Fadil-1/8-BIT-BREADBOARD-CPU/README.md

# F8-BB: Expanded 8-bit Breadboard CPU

F8-BB is my expanded 8-bit breadboard CPU. The project is inspired by [Ben Eater's 8-bit CPU series](https://www.youtube.com/playlist?list=PLowKtXNTBypGqImE405J2565dvjafglHU), but it has grown into a larger custom machine with a 16-bit address space and additional I/O hardware.

The goal of this repository is to collect the files needed to document, program, and maintain the build.

Full build

## Blog

More detailed explanations are available on the project blog:

```text
https://fadil-1.github.io/blog/8-bit_breadboard_CPU/overview/
```

## Acknowledgment

A huge thank you to [Ben Eater](https://github.com/beneater) for the original educational CPU series that inspired this project.

I also want to thank [DerULF1 / ULF_Casper](https://github.com/DerULF1) for his 8-bit CPU [series](https://www.youtube.com/playlist?list=PL5-Ar_CvItgaP27eT_C7MnCiubkyaEqF0). The interrupt handling and PS/2 keyboard module in my build are largely derived from his design.

## Hardware highlights

- 8-bit data bus
- 16-bit memory/system bus
- 16-bit Program Counter
- 16-bit Stack Pointer
- Bridge Register for transfers between the 8-bit data bus and 16-bit memory/system bus
- 48 KB of RAM from `0x0000` through `0xBFFF`
- Bootloader ROM window starting at `0xC000`
- Stack initialized at `0xBFFF` and growing downward into RAM
- Programmable clock speed with eight selectable clock rates
- Microcoded control unit built from three M27C4002 EPROMs
- Generated 48-bit control word split across three 16-bit ROM outputs
- General-purpose registers A, B, C, D, and E
- Writable flags and interrupt-related control state
- ALU operations including ADD, SUB, AND, OR, XOR, compare, and shifts
- 16-bit 14-segment display output
- 128x64 OLED display
- SPI/SD-card interface work
- PS/2 keyboard decoder integration planned for the monitor/OS path

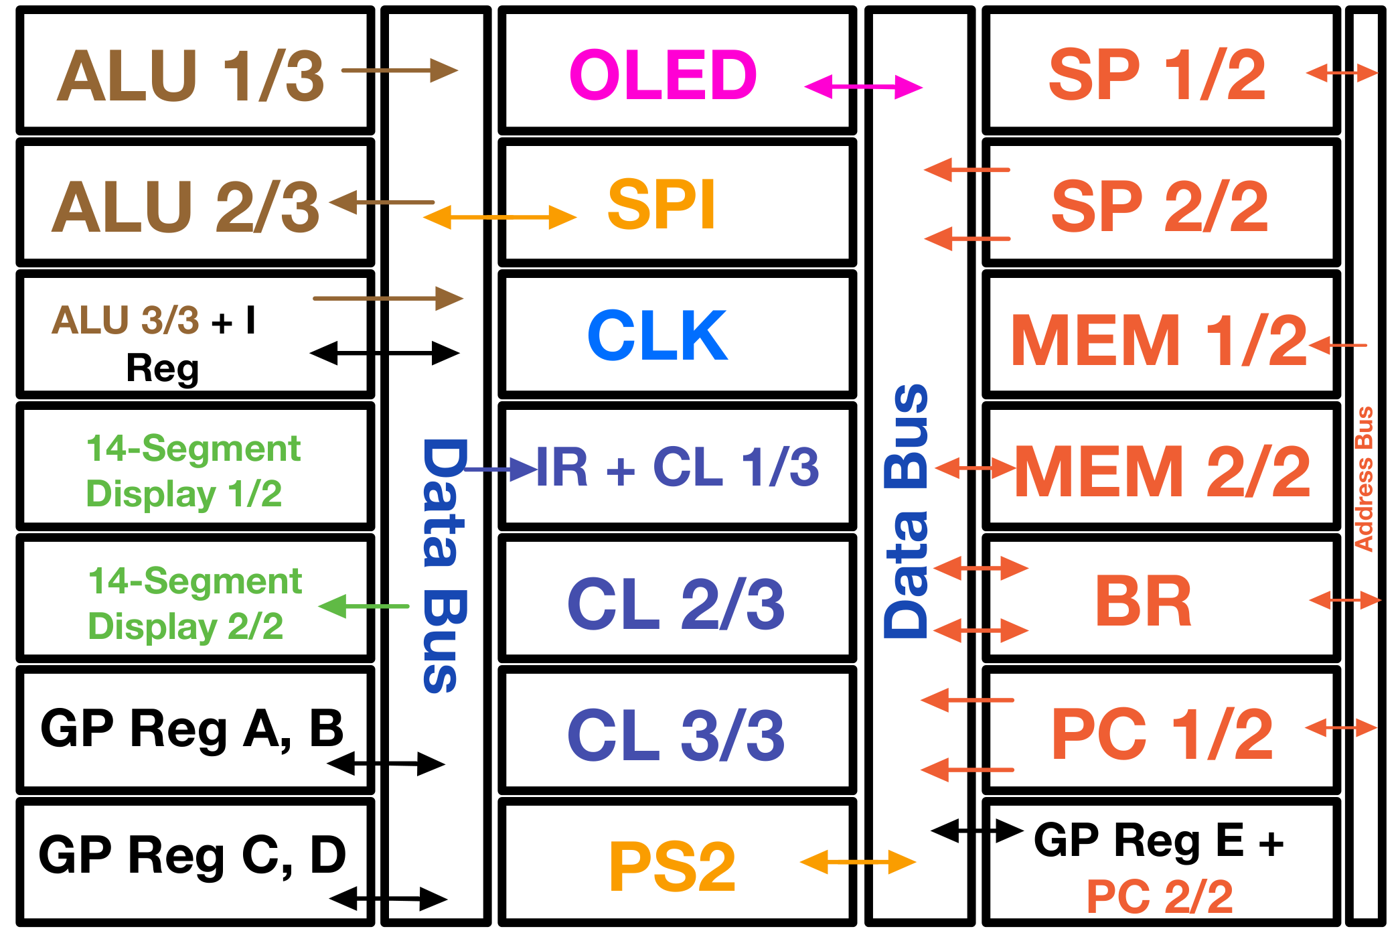
[picture p1: images/Layout.png]
Breadboard layout


## Repository layout

```text
ASM/
    Assembly source files.

ASM/boot/
    ROM bootstrap programs, including SD-card bootloader code.

ASM/drivers/
    Hardware-facing assembly libraries, including OLED and SPI/SD routines.

ASM/libs/
    Shared assembly helpers such as timing routines.

ASM/programs/
    Example programs grouped by how they are loaded.

ASM/programs/loaded_from_ROM/
    Smaller examples that can run from ROM or older direct-programming flows.

ASM/programs/loaded_from_SD/
    Larger SD-loaded programs, including prime-number and OLED animation examples.

ASM/ruledef.asm
    Generated CustomASM rule definitions for the current instruction set.

generated/
    Generated files produced by project tools.

generated/microcode/
    Generated instruction documentation and microcode ROM images.

tools/microcode/
    Python microcode generator used to create CustomASM rule definitions,
    instruction documentation, and the three microcode ROM binaries.

tools/deployment/
    Scripts for assembling, packaging, writing, and verifying ROM/SD payloads.

generated/display_rom/
    Generated binary image for the 14-segment display ROM.

tools/display_rom/
    Generator for the 14-segment display ROM.

tools/oled/
    OLED-related tools, including text-library generators and the SD delta video converter.

arduino_EEPROM_programmer/
    Arduino-based EEPROM programmer material used earlier in the project.

schematics_and_figures/
    Module schematics, and exported figures.

datasheets/
    Datasheets for ICs and modules used in the build.

images/
    Project photos and overview diagrams.
```

## Microcode and generated files

The current microcode source lives here:

```text
tools/microcode/microcode_generator.py
```

It generates:

```text
ASM/ruledef.asm
generated/microcode/instructions.md
generated/microcode/microcode_rom_0.bin
generated/microcode/microcode_rom_1.bin
generated/microcode/microcode_rom_2.bin
```

`ASM/ruledef.asm` is used by CustomASM programs. The generated instruction reference and ROM binaries are placed under `generated/microcode/`.

## Deployment tools

tools/deployment/
    Scripts for assembling, packaging, writing, and verifying ROM/SD payloads.

The deployment tools live here:

```text
tools/deployment/
```

Current tools include:

```text
deploy_asm.py
make_bootdesc.py
compare_binary.py
```

`deploy_asm.py` assembles CustomASM programs and prepares either ROM payloads or SD-card payloads. It can also create BT1 multi-sector SD payloads and write/read back data from a raw SD block device.

`make_bootdesc.py` creates standalone BT1 boot descriptor sectors.

`compare_binary.py` compares two binary files byte-for-byte and reports whether they match.

## Assembly files

The `ASM/` directory is split between boot code, reusable drivers, shared helpers, and standalone programs.

Current public assembly areas include:

```text
ASM/boot/
    SD-card ROM bootstrap programs.

ASM/drivers/oled/
    OLED constants, low-level display routines, text libraries, and graphics primitives.

ASM/drivers/spi_sd/
    SPI and SD-card routines used by the bootloader and future monitor work.

ASM/libs/
    Shared helper routines.

ASM/programs/
    Early demo programs.
```

## OLED text libraries

The OLED driver includes two text layers:

```text
oled_text_5x7.asm
    5x7 text in 6x8 cells.

oled_text_4x6.asm
    Compact 4x6 text in 4x7 cells.
```

I noticed that **writing on raw pixel row 63 produces a visible artifact near the top of the display**.
Normal 5x7 text usually hides this because the last row of each 8-pixel cell is blank spacing, but filled graphics can expose it.
The compact 4x6 library only uses a 32-column by 9-row text grid and avoids raw pixel row 63 altogether.

## Architecture

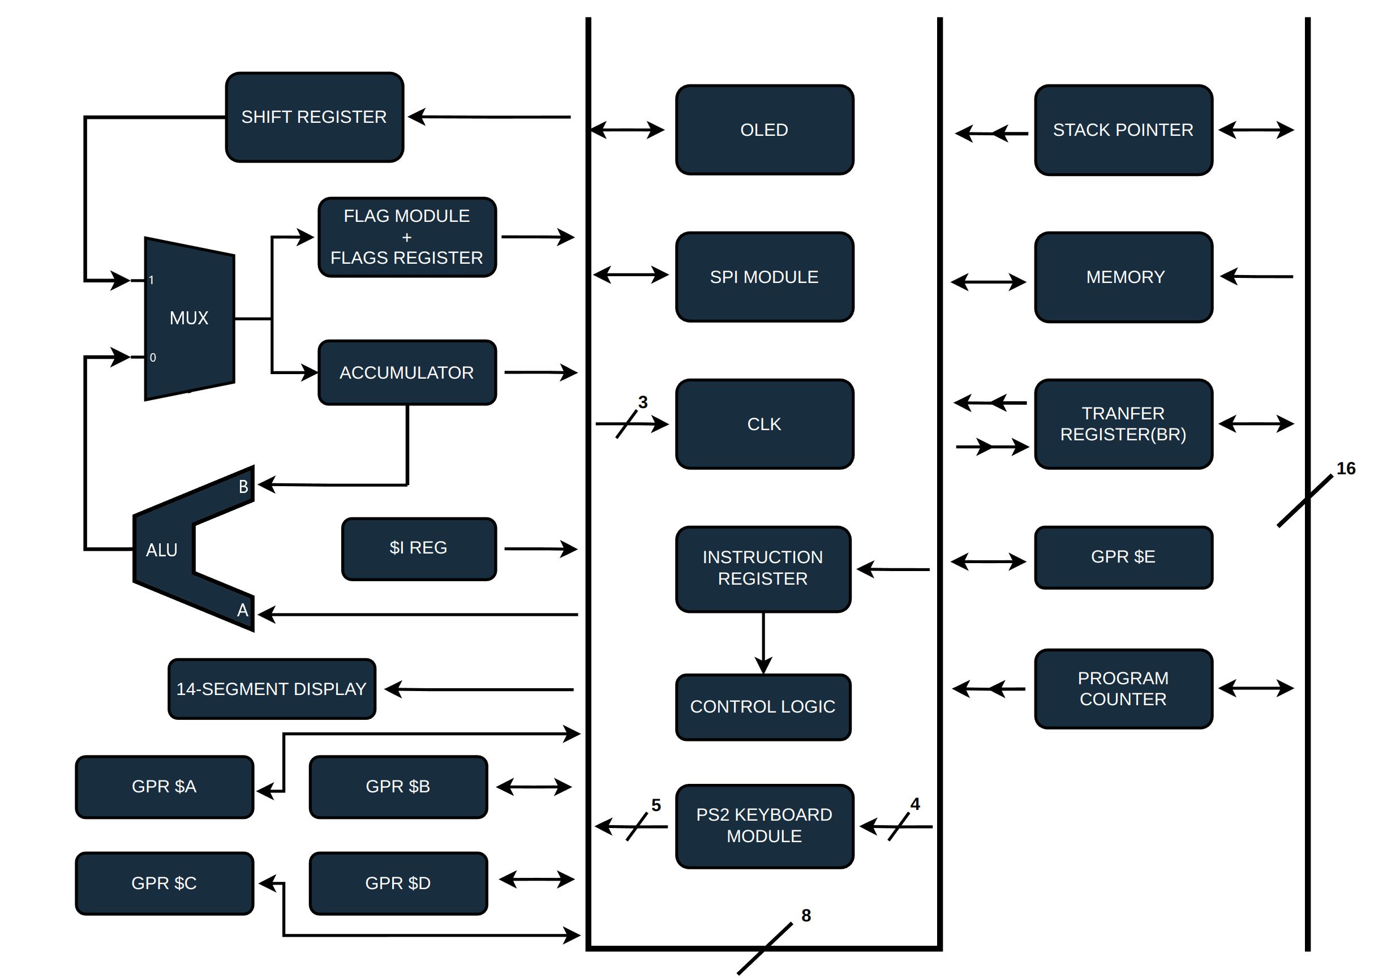
[picture p2: images/architecture.png]
Architecture diagram


## License

This repository uses separate licenses for software, hardware design material, and documentation/images. See `LICENSE.md` and the `LICENSES/` directory for details.
