Fadil-1/8-BIT-BREADBOARD-CPU/ASM/programs/loaded_from_SD/oled_animations/input_media/sources.md

**eyes.gif**: https://in.pinterest.com/pin/1144547692800903402/

**stick_fight.webp**: https://substackcdn.com/image/fetch/$s_!EK0Y!,f_auto,q_auto:good,fl_progressive:steep/https%3A%2F%2Fsubstack-post-media.s3.amazonaws.com%2Fpublic%2Fimages%2F11380e14-c910-4db9-95fe-eae28db8013d_900x430.gif

**rick_roll.gif**: https://www.hoyolab.com/article/73837

**think.gif**: https://kr.pinterest.com/pin/745134700892291931/

**moonwalk.gif**: https://pin.it/4PqO8smEx
