Fadil-1/8-BIT-BREADBOARD-CPU/ASM/programs/loaded_from_SD/oled_animations/input_media/rick_roll.gif

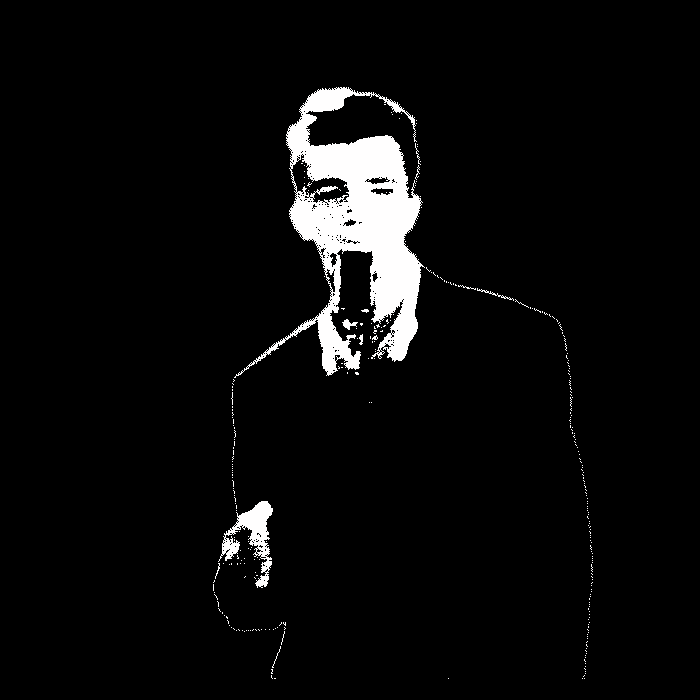
ASM/programs/loaded_from_SD/oled_animations/input_media/rick_roll.gif
