Fadil-1/8-BIT-BREADBOARD-CPU/ASM/programs/loaded_from_SD/oled_animations/input_media/stick_fight.webp

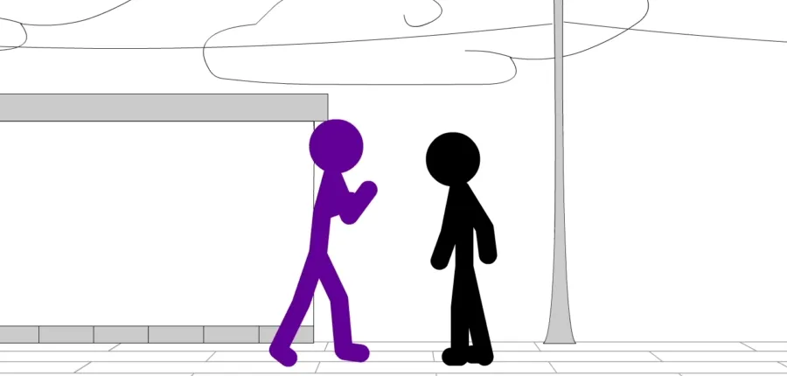
ASM/programs/loaded_from_SD/oled_animations/input_media/stick_fight.webp
