Fadil-1/8-BIT-BREADBOARD-CPU/datasheets/PS2_PORT.png

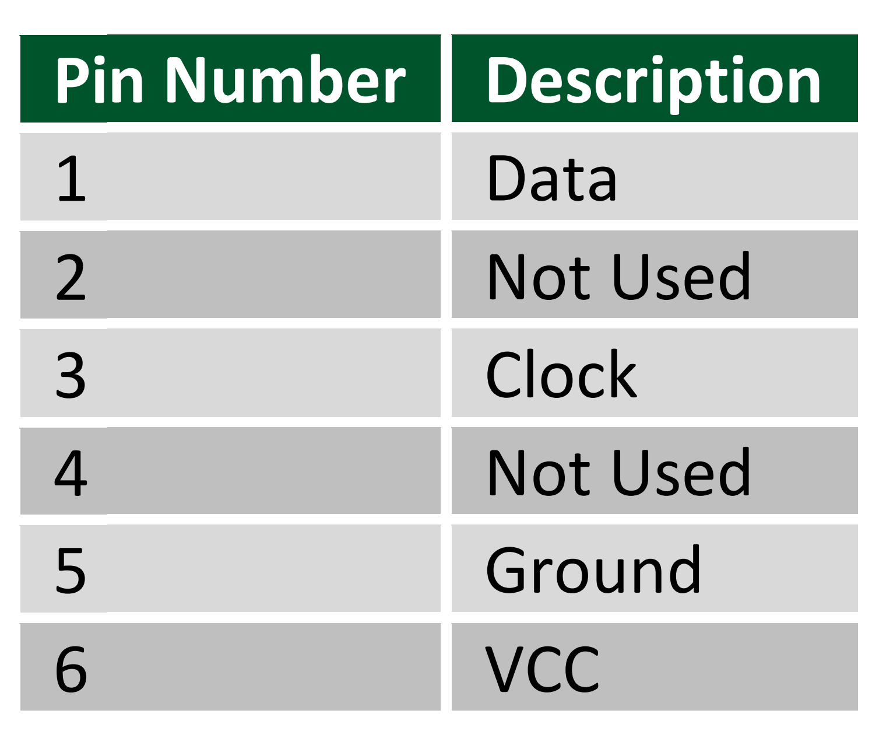
datasheets/PS2_PORT.png
