Fadil-1/8-BIT-BREADBOARD-CPU/datasheets/Segmented Display/6_14-segment_display.png

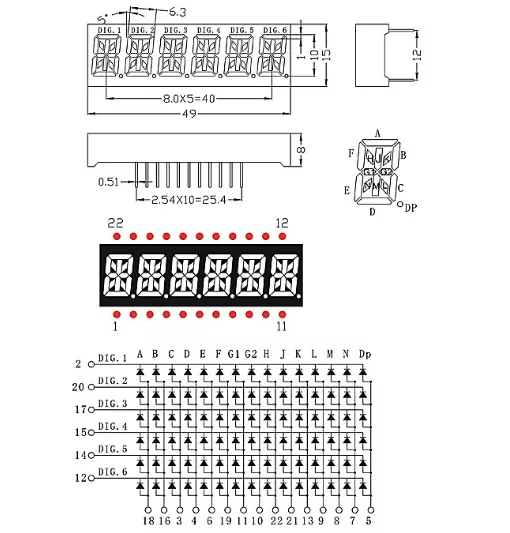
datasheets/Segmented Display/6_14-segment_display.png
