Fadil-1/8-BIT-BREADBOARD-CPU/schematics_and_figures/ALU & Flags Figures/Images/ALU_&_Flags_Figures.png

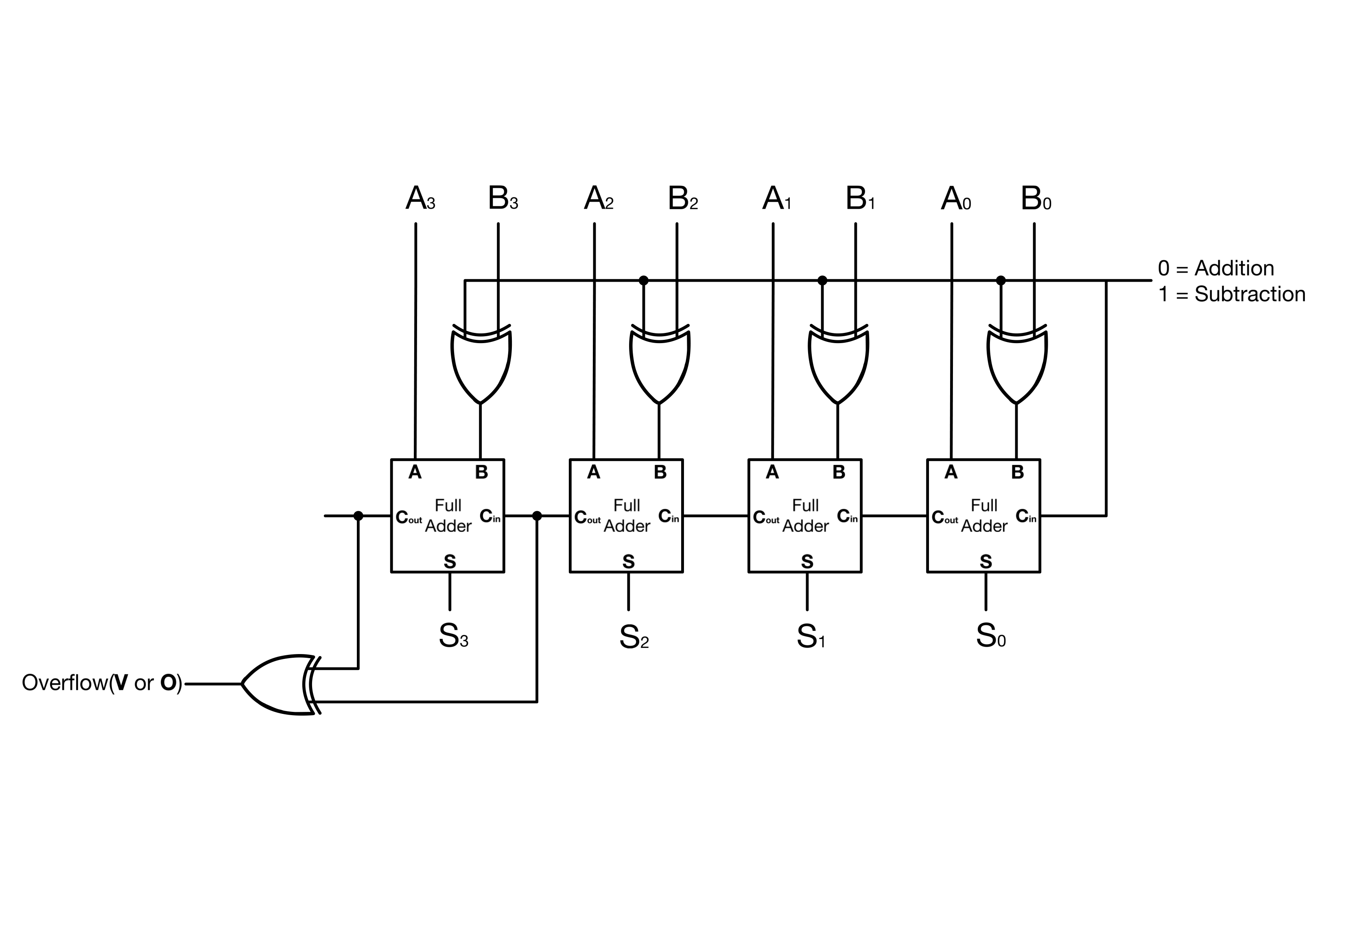
schematics_and_figures/ALU & Flags Figures/Images/ALU_&_Flags_Figures.png
