Fadil-1/8-BIT-BREADBOARD-CPU/schematics_and_figures/ALU Primer Figures/Images/ALU_Primer_Figures-5.png

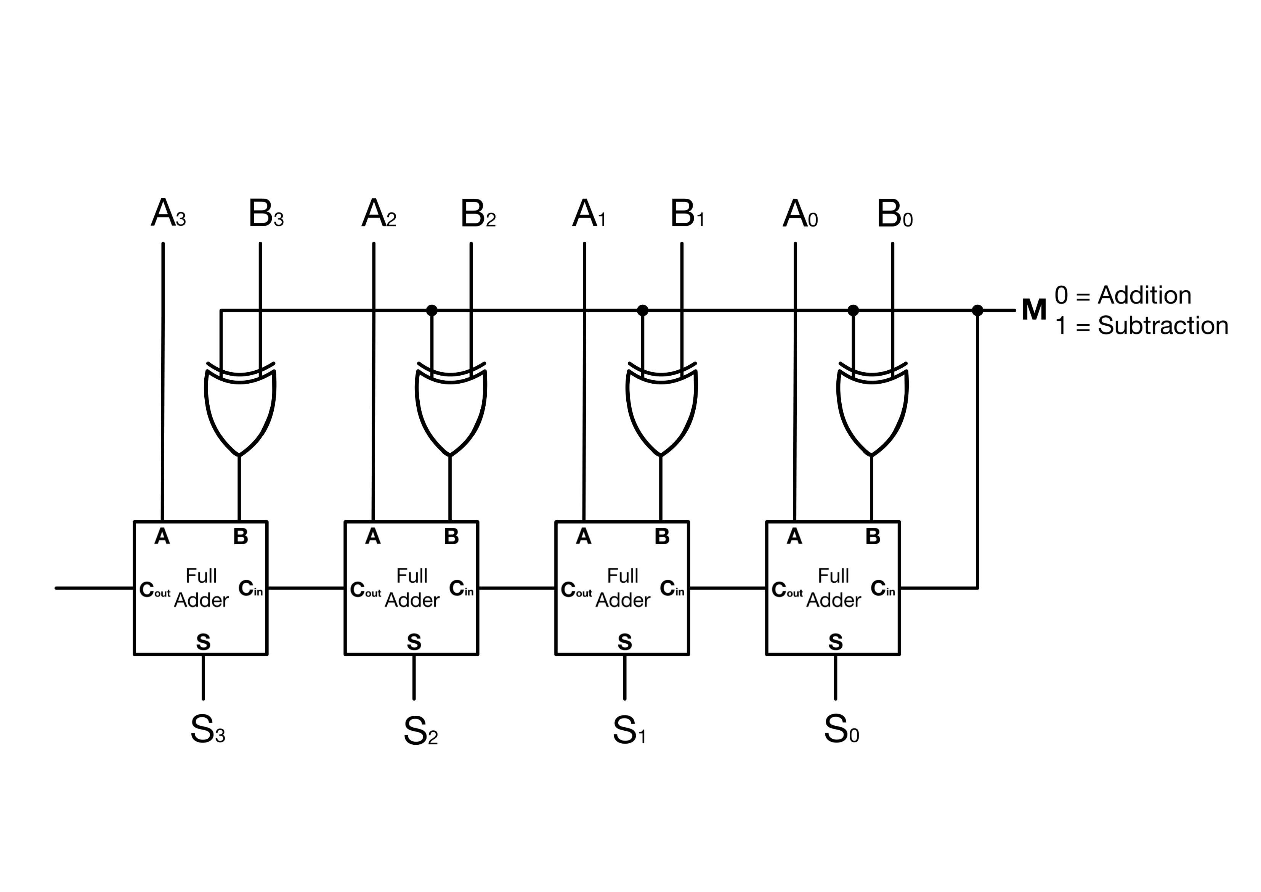
schematics_and_figures/ALU Primer Figures/Images/ALU_Primer_Figures-5.png
