Fadil-1/8-BIT-BREADBOARD-CPU/schematics_and_figures/ALU/Images/ALU-1.png

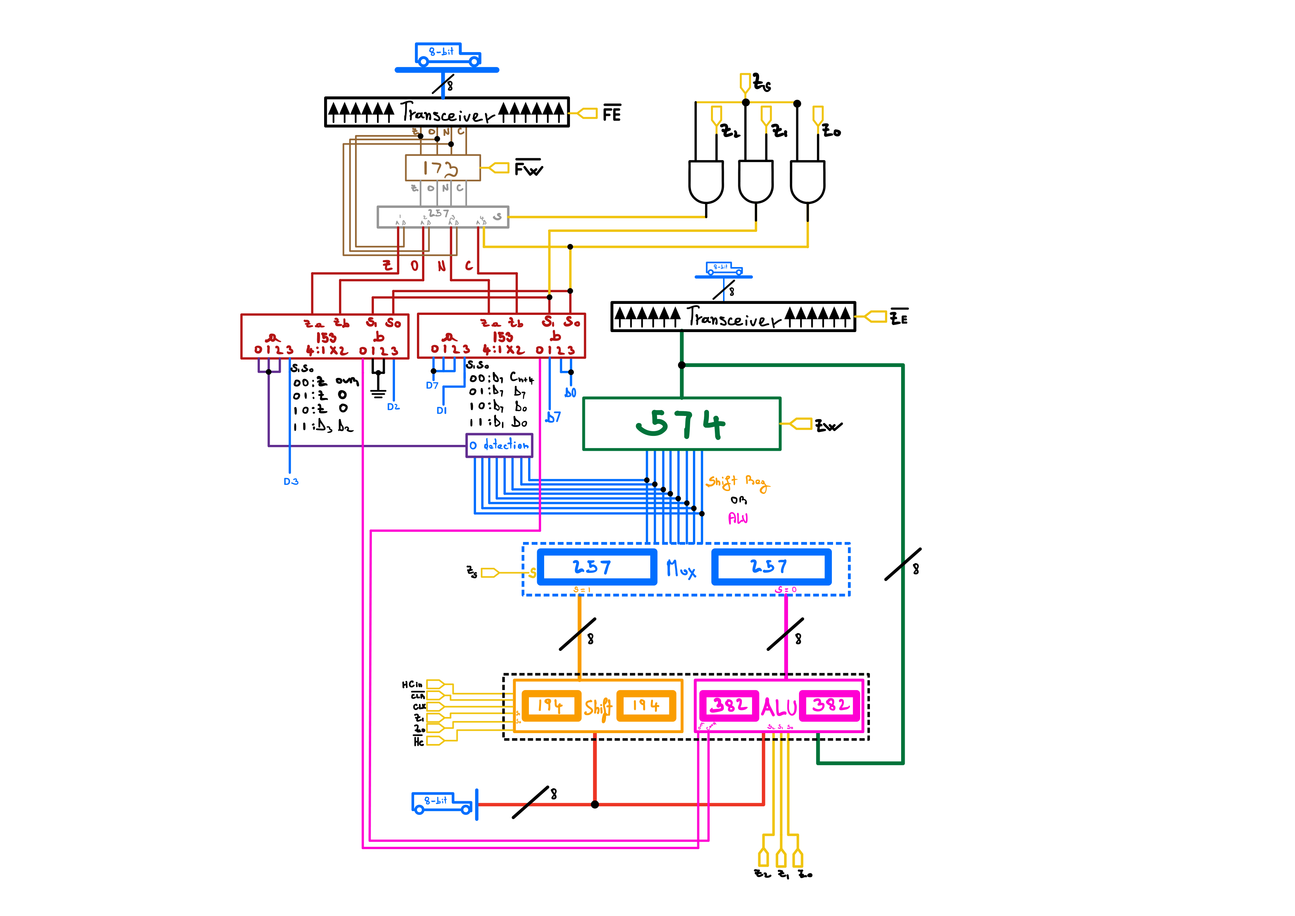
schematics_and_figures/ALU/Images/ALU-1.png
