Fadil-1/8-BIT-BREADBOARD-CPU/schematics_and_figures/ALU/Images/ALU-4.png

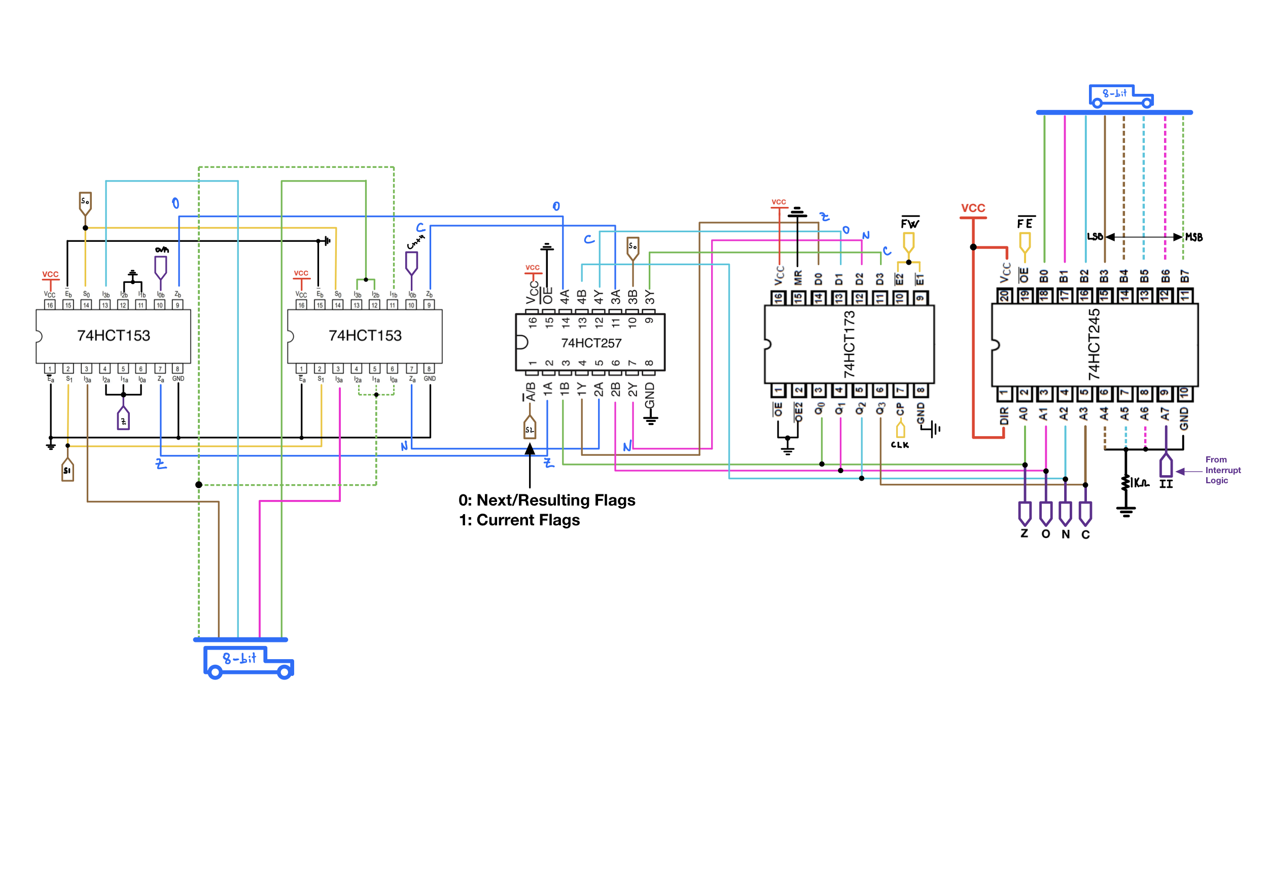
schematics_and_figures/ALU/Images/ALU-4.png
