Fadil-1/8-BIT-BREADBOARD-CPU/schematics_and_figures/Basics Figures/Images/Basics_figures-10.png

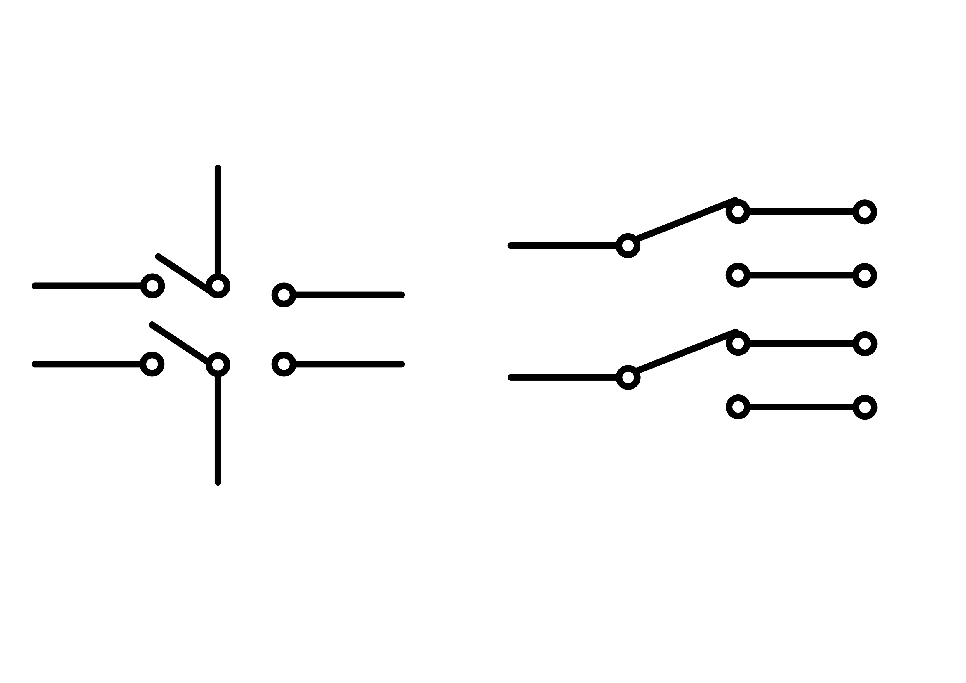
schematics_and_figures/Basics Figures/Images/Basics_figures-10.png
