Fadil-1/8-BIT-BREADBOARD-CPU/schematics_and_figures/Control Logic Figures/Images/Control_Logic_Figures-2.png

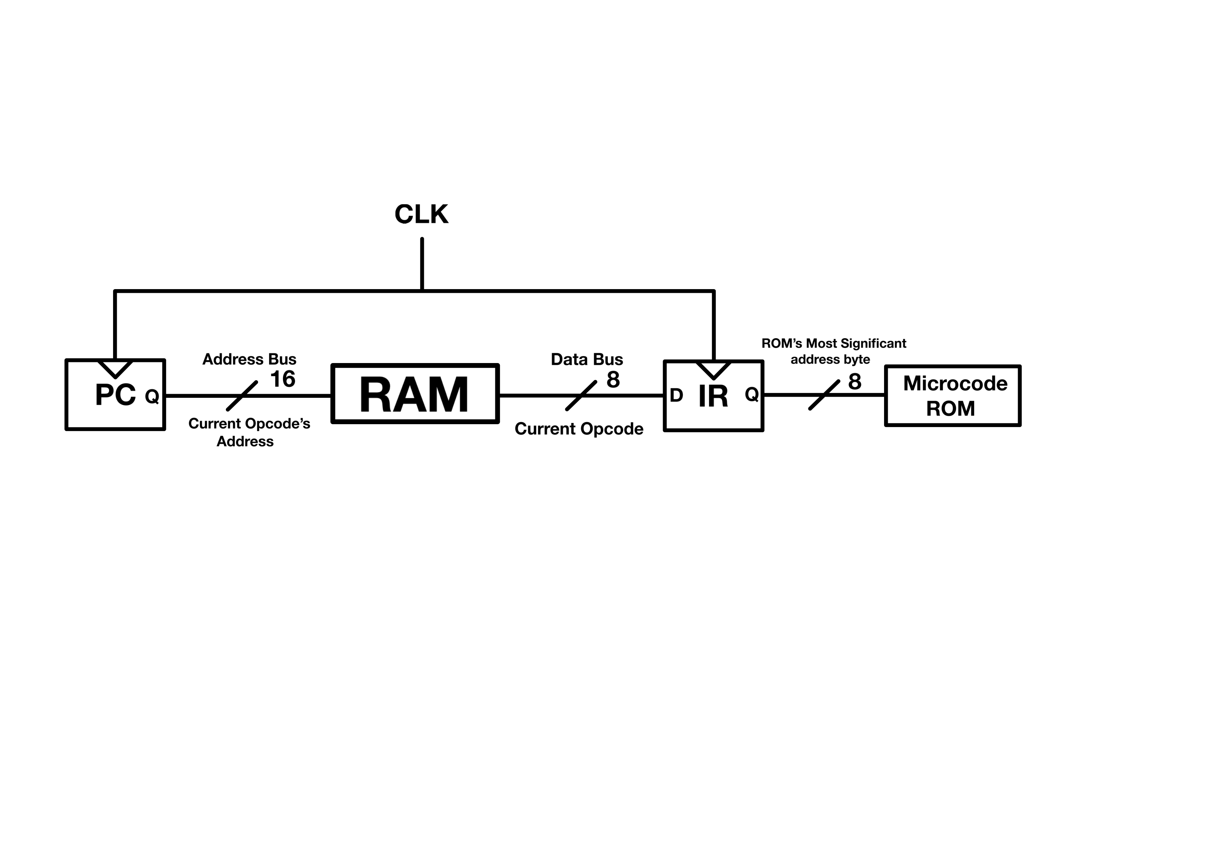
schematics_and_figures/Control Logic Figures/Images/Control_Logic_Figures-2.png
