Fadil-1/8-BIT-BREADBOARD-CPU/schematics_and_figures/Control Logic/Images/Control Logic-1.png

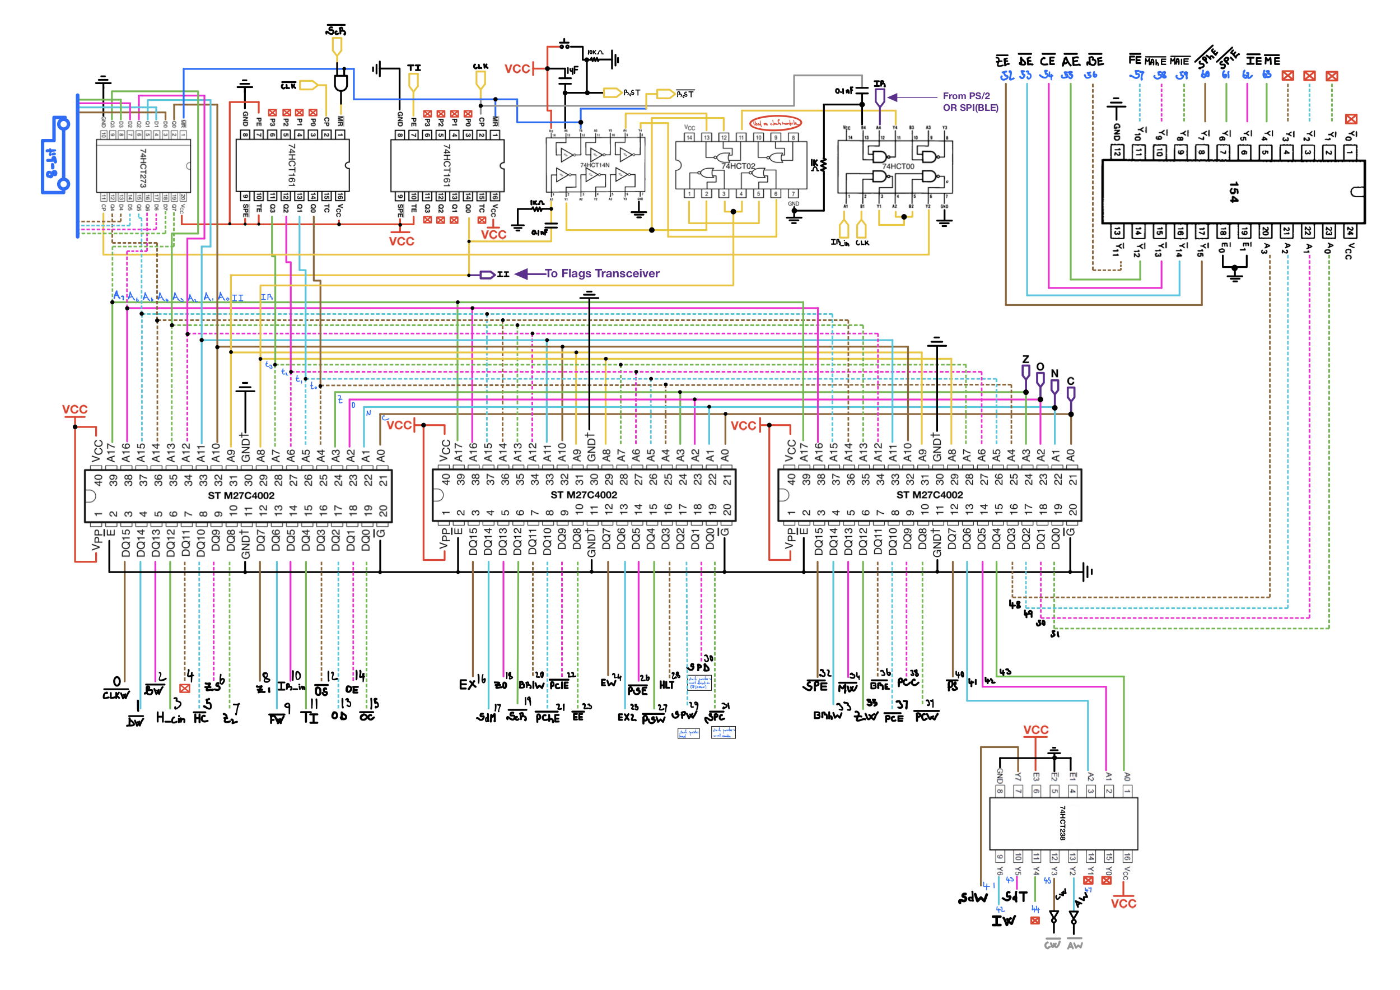
schematics_and_figures/Control Logic/Images/Control Logic-1.png
