Fadil-1/8-BIT-BREADBOARD-CPU/schematics_and_figures/EEPROM Programmers/Images/EEPROM programmers -1.png

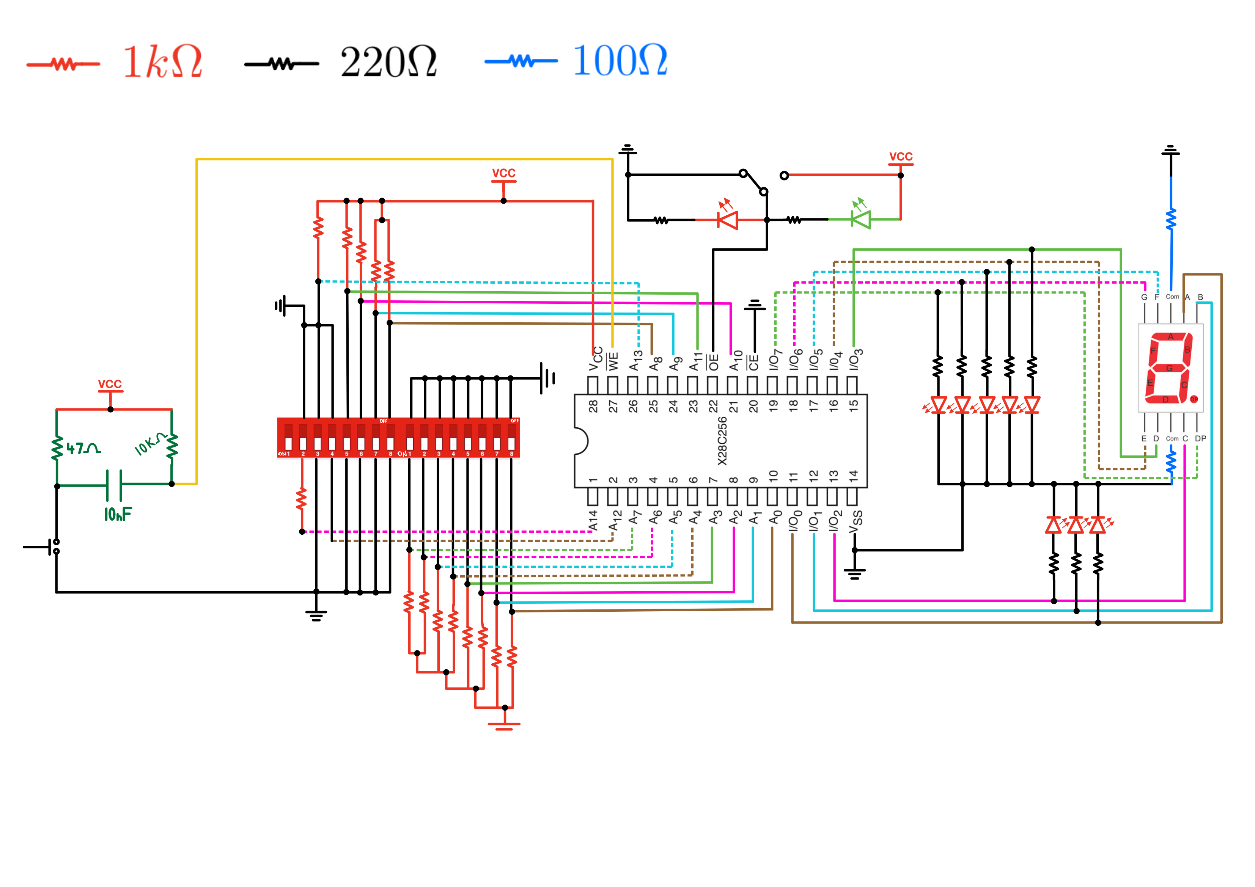
schematics_and_figures/EEPROM Programmers/Images/EEPROM programmers -1.png
