Fadil-1/8-BIT-BREADBOARD-CPU/schematics_and_figures/General Purpose Registers/Images/General purpose Registers-1.png

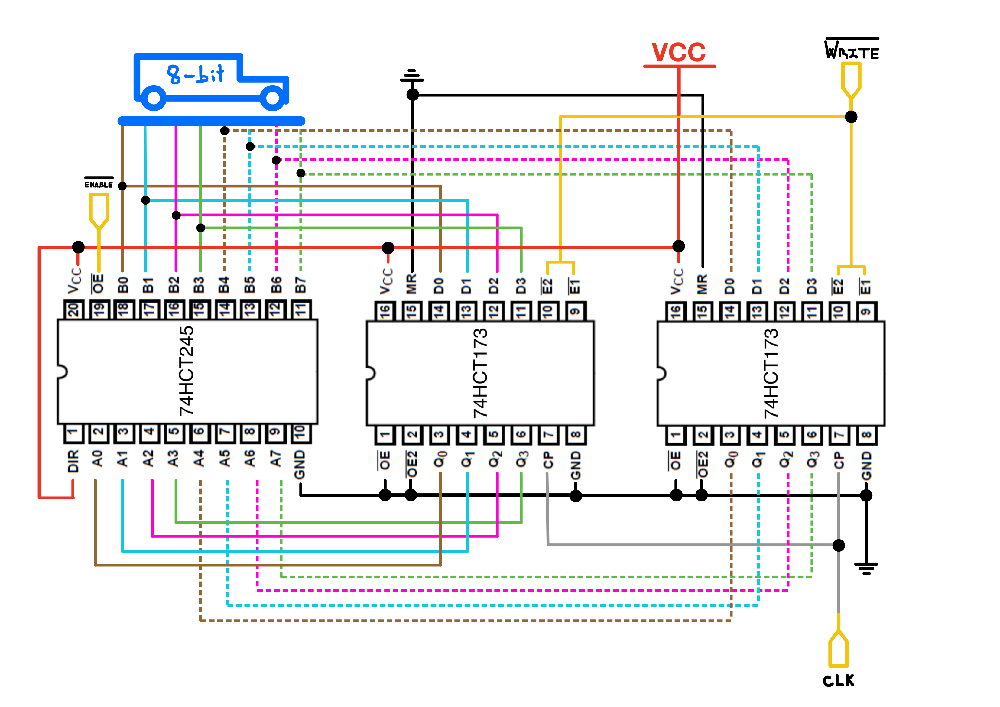
schematics_and_figures/General Purpose Registers/Images/General purpose Registers-1.png
