Fadil-1/8-BIT-BREADBOARD-CPU/schematics_and_figures/Layout/Images/Layout-1.png

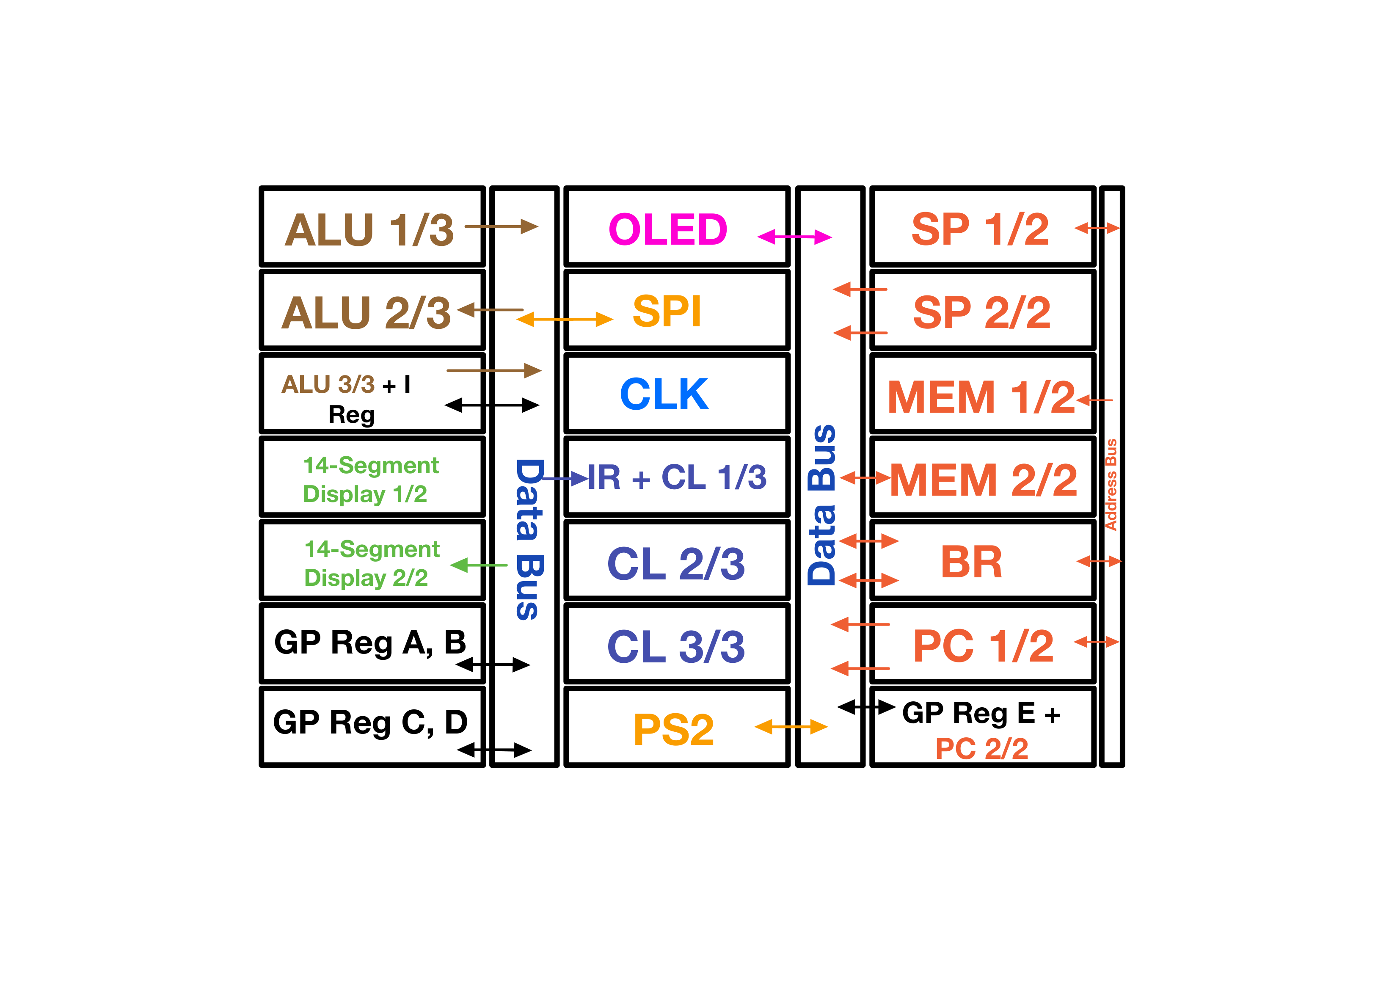
schematics_and_figures/Layout/Images/Layout-1.png
