Fadil-1/8-BIT-BREADBOARD-CPU/schematics_and_figures/OLED Display/Images/OLED DISPLAY-1.png

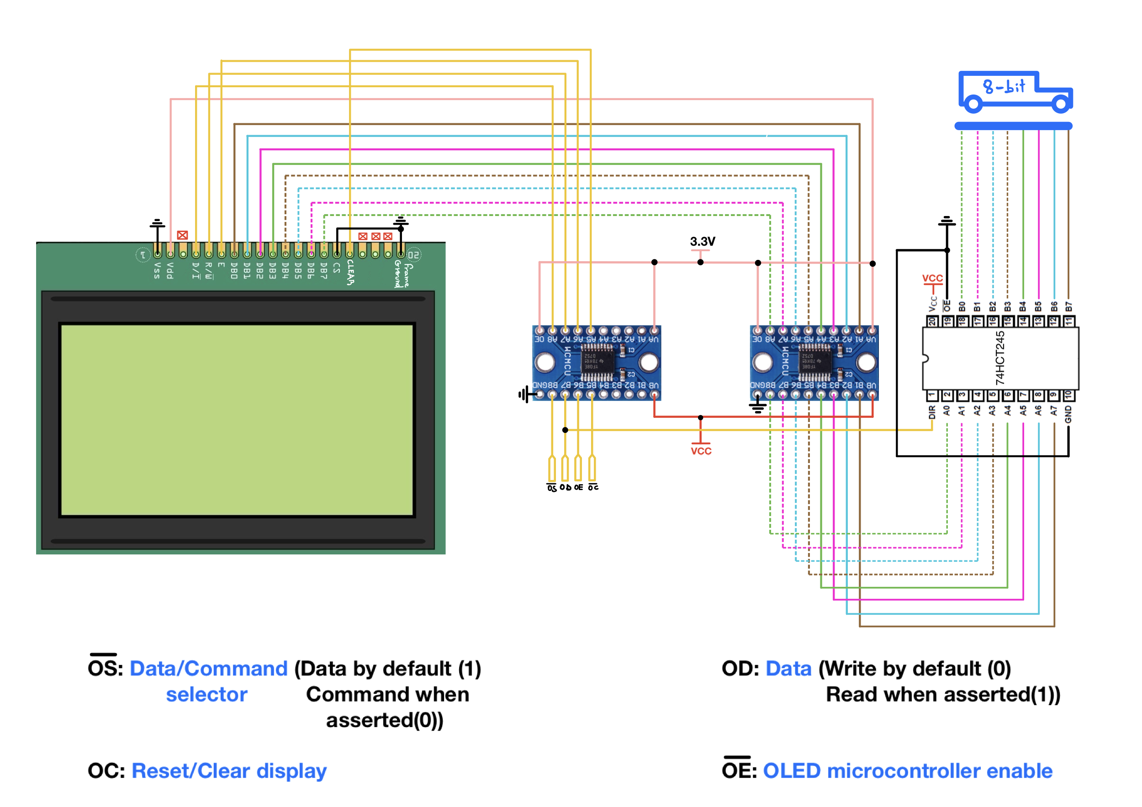
schematics_and_figures/OLED Display/Images/OLED DISPLAY-1.png
