Fadil-1/8-BIT-BREADBOARD-CPU/schematics_and_figures/Permanent Clock Figures/Images/Permanent_Clock_figures-2.png

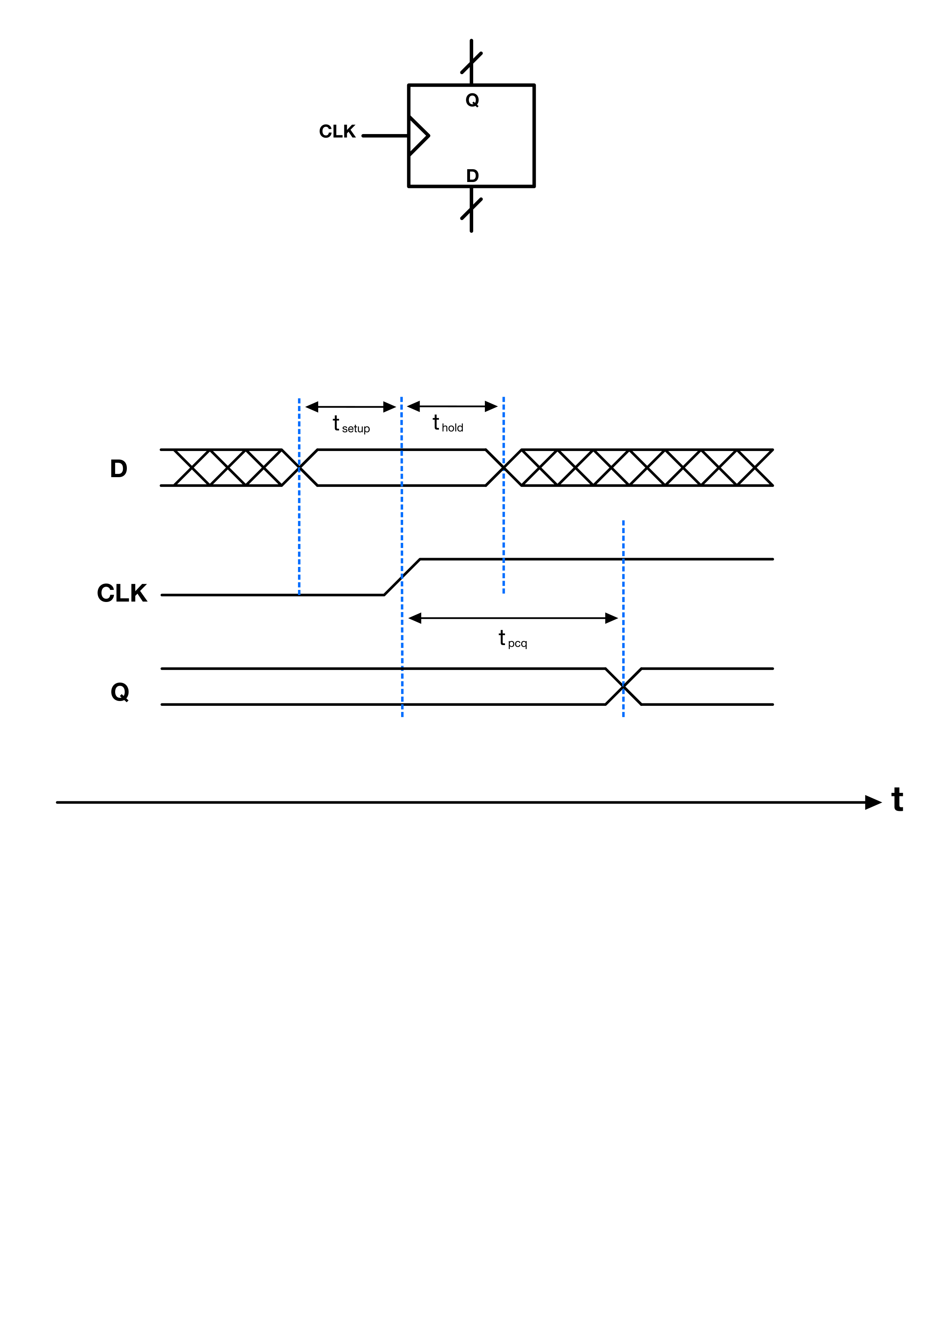
schematics_and_figures/Permanent Clock Figures/Images/Permanent_Clock_figures-2.png
