Fadil-1/8-BIT-BREADBOARD-CPU/schematics_and_figures/Permanent Clock/Images/Permanent Clock-1.png

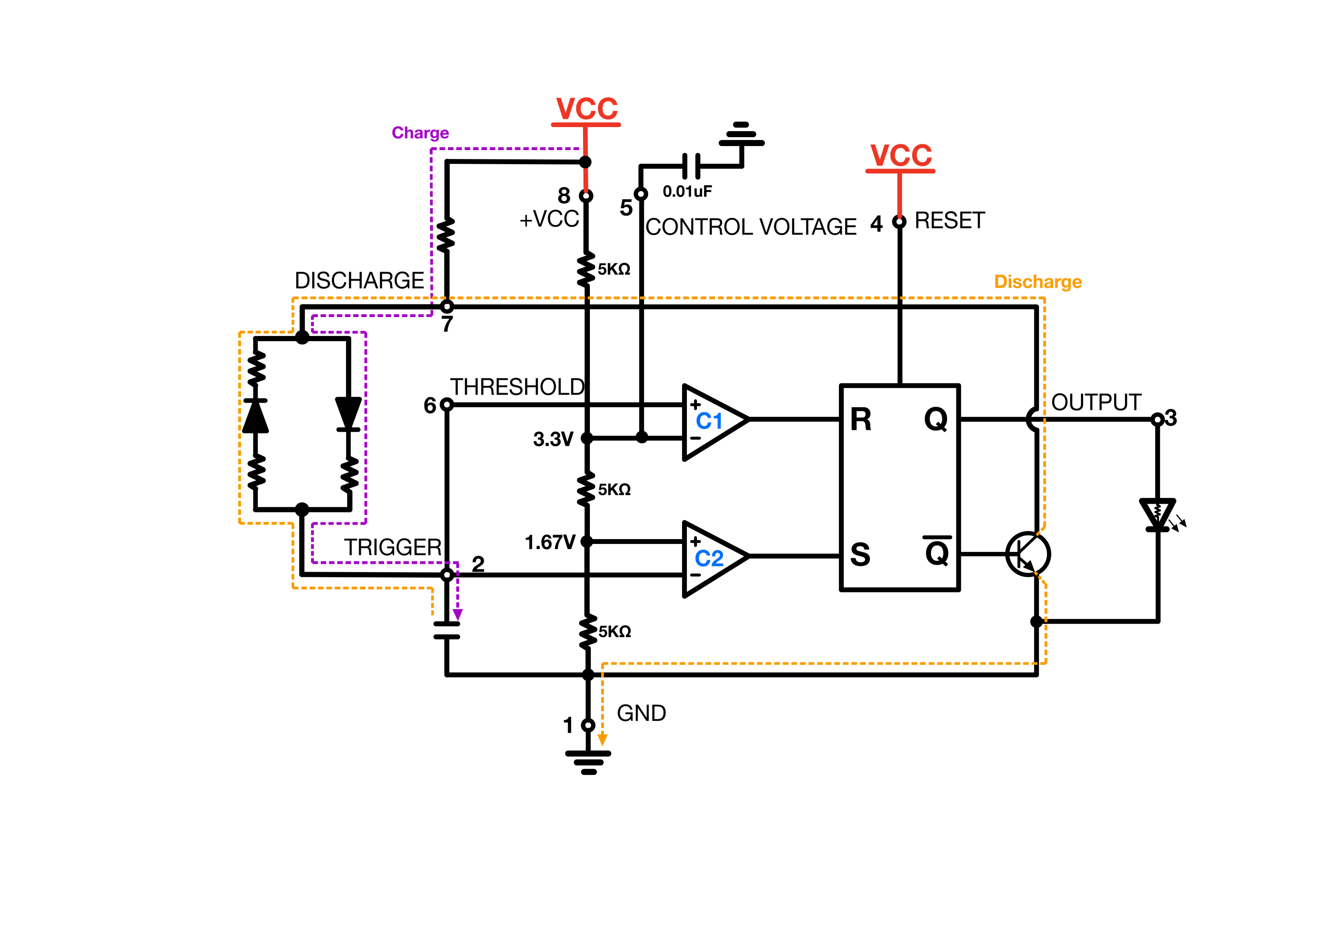
schematics_and_figures/Permanent Clock/Images/Permanent Clock-1.png
