Fadil-1/8-BIT-BREADBOARD-CPU/schematics_and_figures/Port Selector/Images/Port Selector-1.png

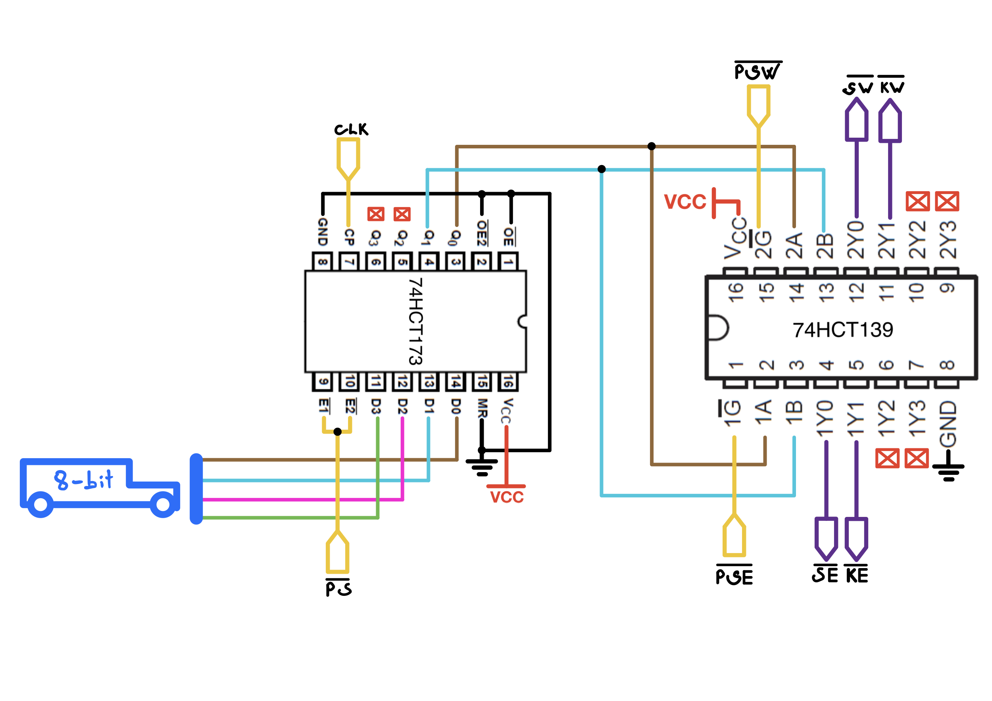
schematics_and_figures/Port Selector/Images/Port Selector-1.png
