Fadil-1/8-BIT-BREADBOARD-CPU/schematics_and_figures/Program Counter Figures/Images/Program_Counter _Figures-3.png

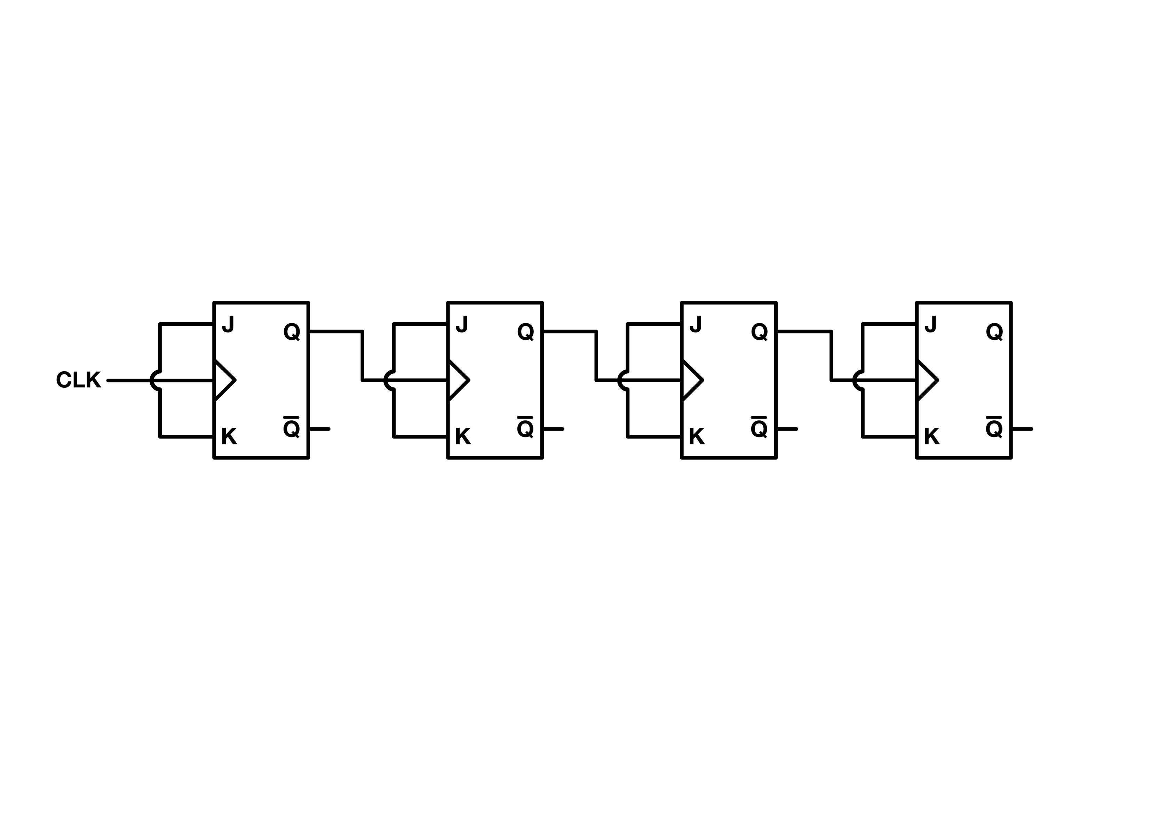
schematics_and_figures/Program Counter Figures/Images/Program_Counter _Figures-3.png
