Fadil-1/8-BIT-BREADBOARD-CPU/schematics_and_figures/Program Counter/Images/PROGRAM COUNTER.png

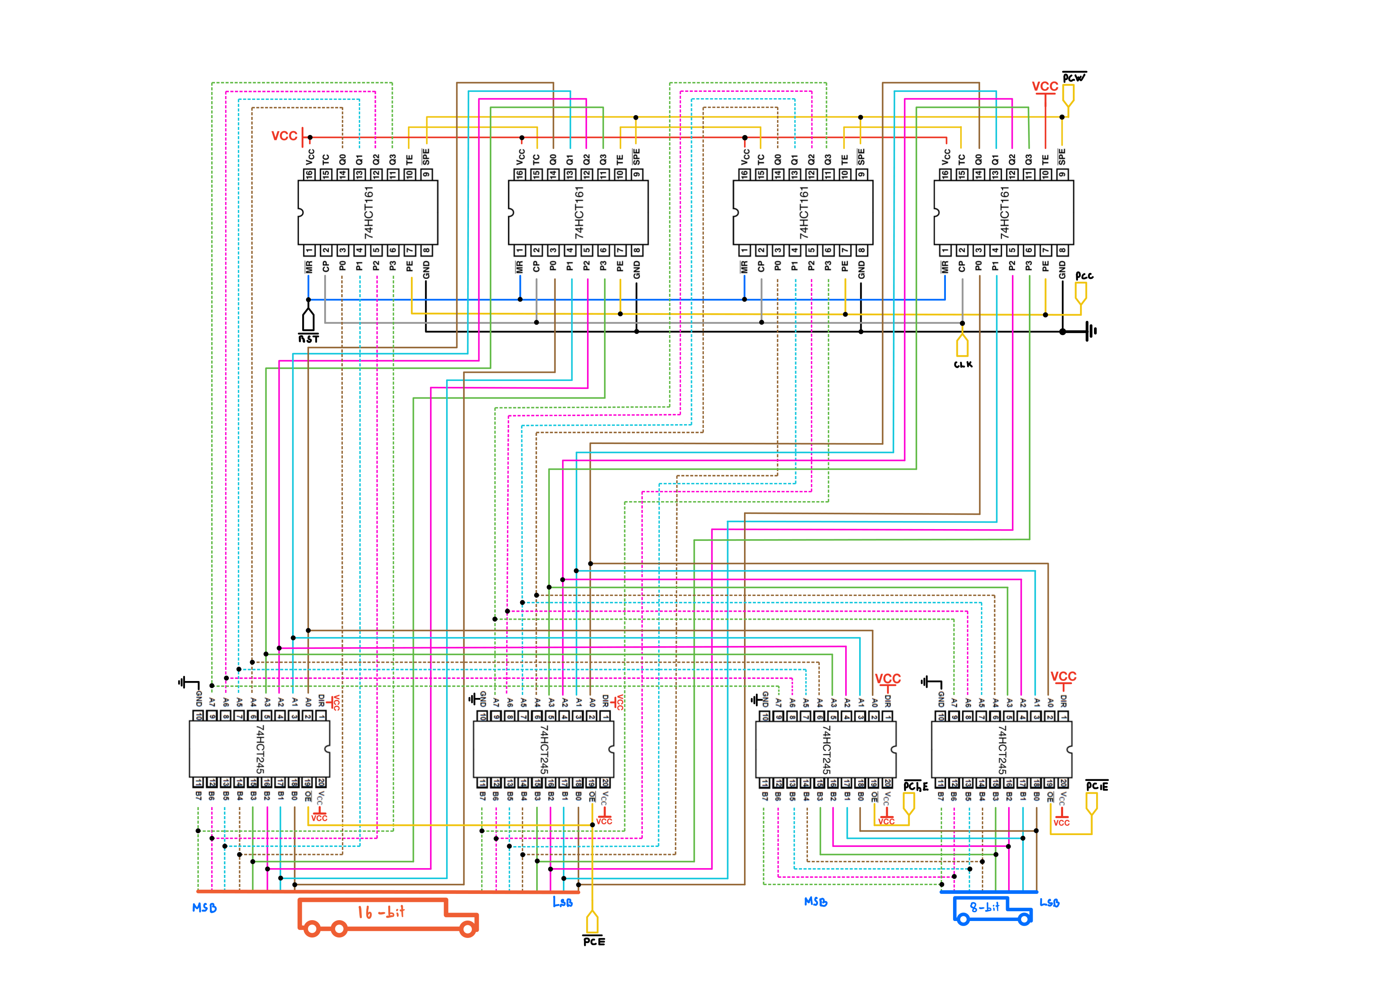
schematics_and_figures/Program Counter/Images/PROGRAM COUNTER.png
