Fadil-1/8-BIT-BREADBOARD-CPU/schematics_and_figures/RAM/Images/RAM-1.png

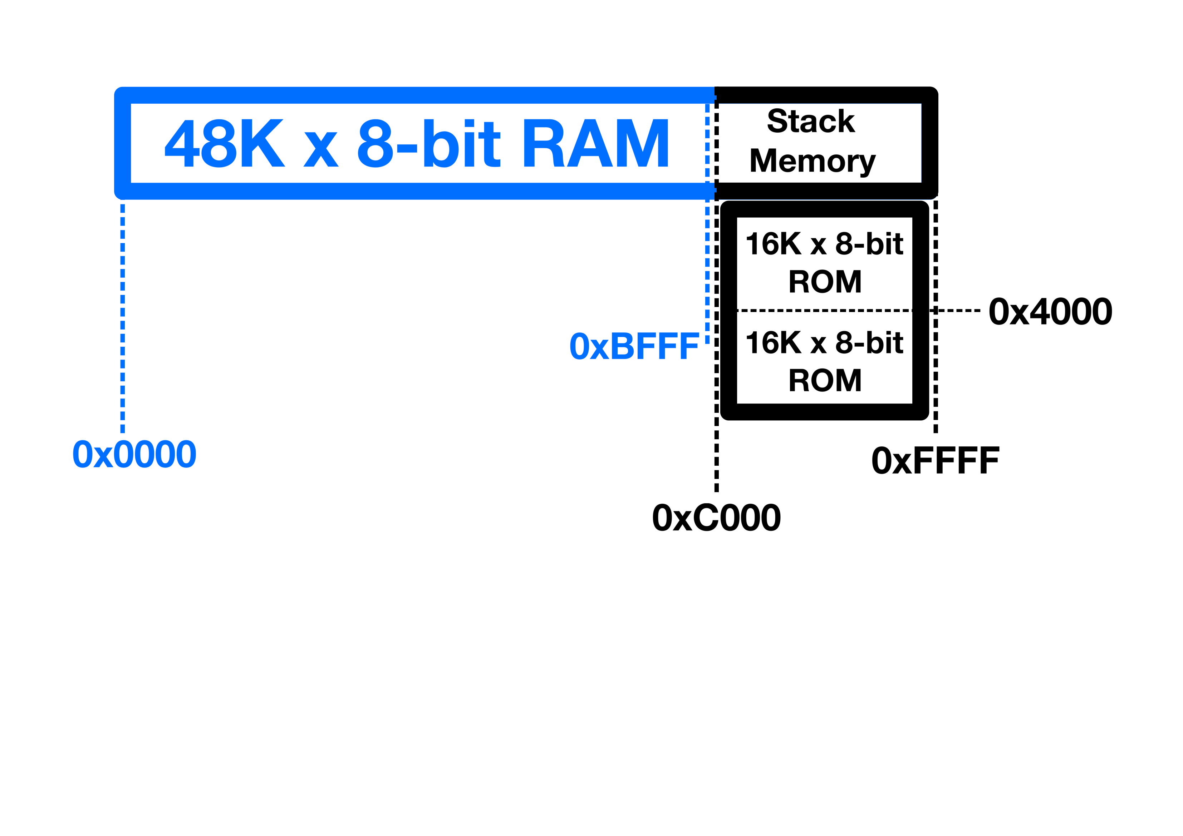
schematics_and_figures/RAM/Images/RAM-1.png
