Fadil-1/8-BIT-BREADBOARD-CPU/schematics_and_figures/RAM/Images/RAM-3.png

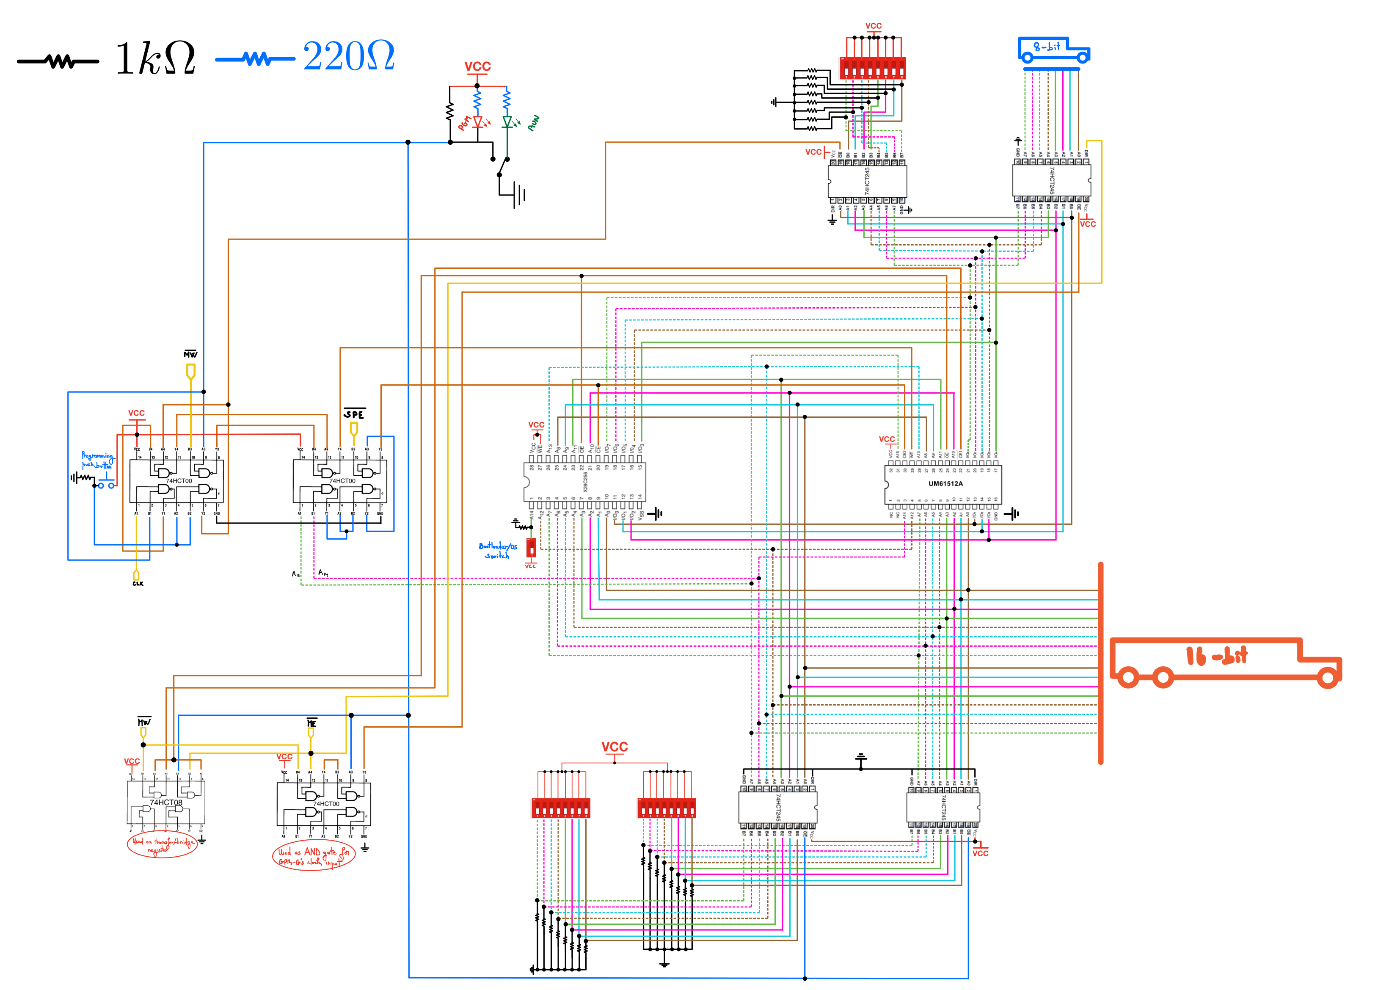
schematics_and_figures/RAM/Images/RAM-3.png
