Fadil-1/8-BIT-BREADBOARD-CPU/schematics_and_figures/Segmented Display Figures/Images/Segmented_Display _Figures-1.png

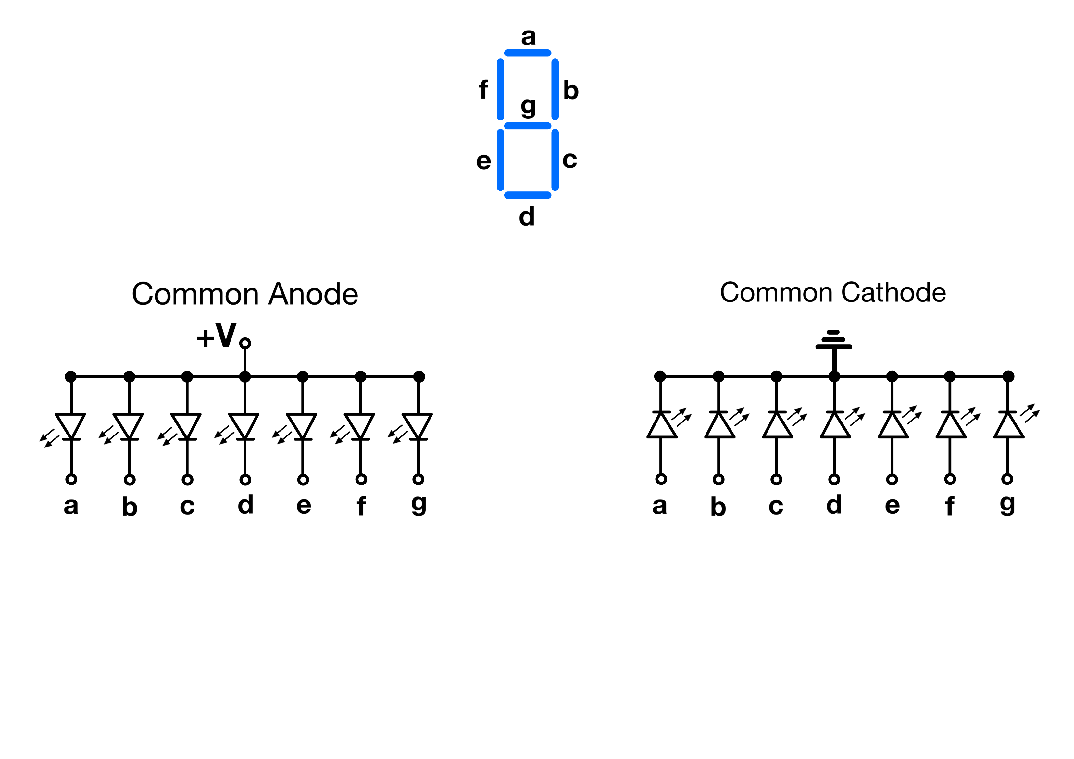
schematics_and_figures/Segmented Display Figures/Images/Segmented_Display _Figures-1.png
