Fadil-1/8-BIT-BREADBOARD-CPU/schematics_and_figures/Segmented Display/Images/Segmented Display-1.png

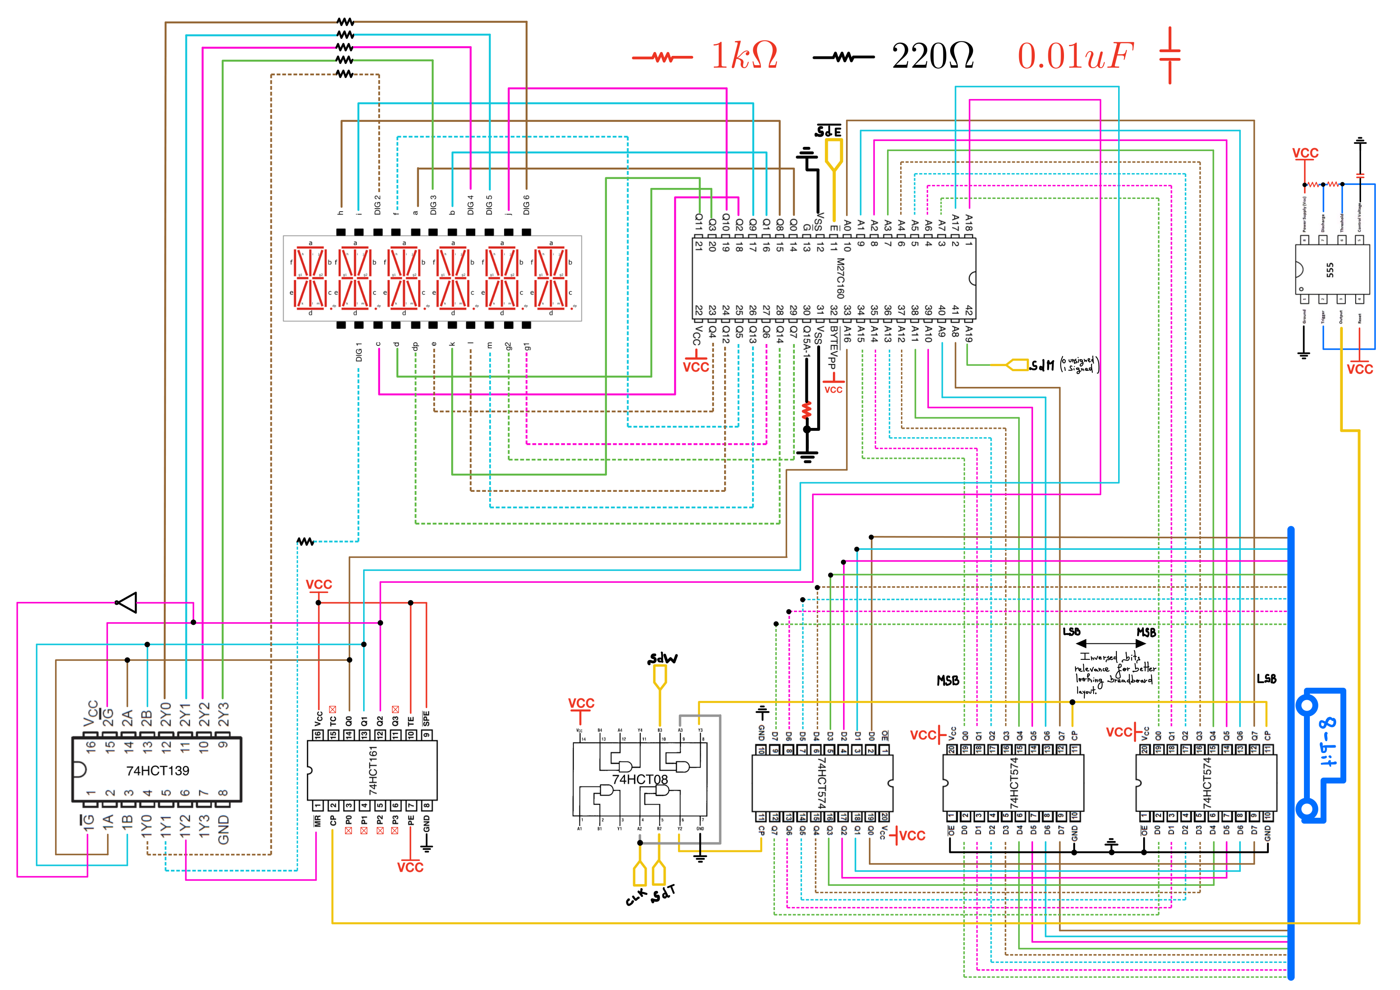
schematics_and_figures/Segmented Display/Images/Segmented Display-1.png
