Fadil-1/8-BIT-BREADBOARD-CPU/schematics_and_figures/SPI Bus/Images/SPI BUS-1.png

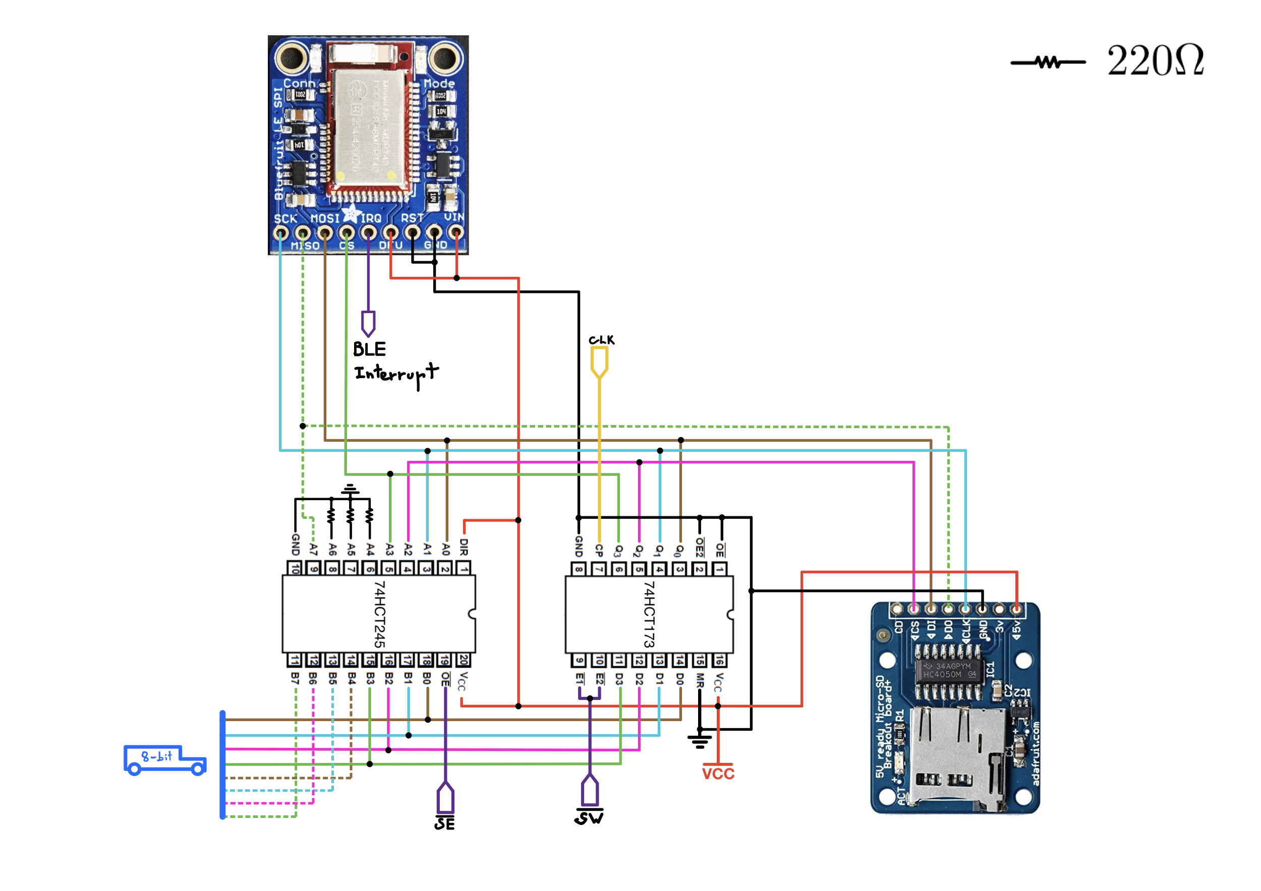
schematics_and_figures/SPI Bus/Images/SPI BUS-1.png
