Fadil-1/8-BIT-BREADBOARD-CPU/schematics_and_figures/Stack Pointer/Images/Stack Pointer.png

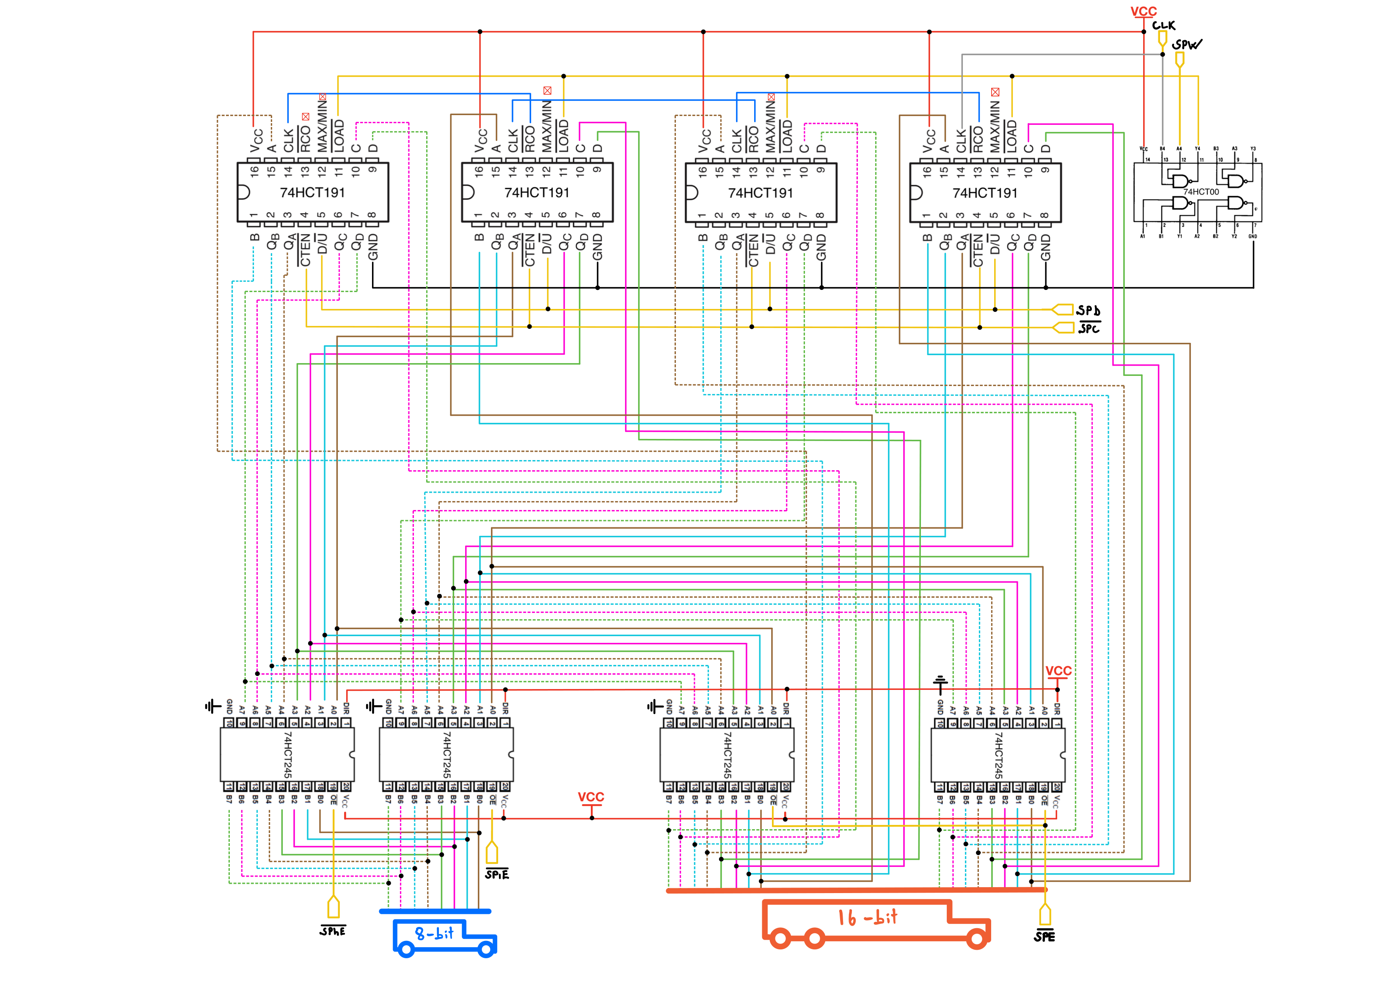
schematics_and_figures/Stack Pointer/Images/Stack Pointer.png
