Fadil-1/8-BIT-BREADBOARD-CPU/schematics_and_figures/Transfer Register/Images/Transfer Register.png

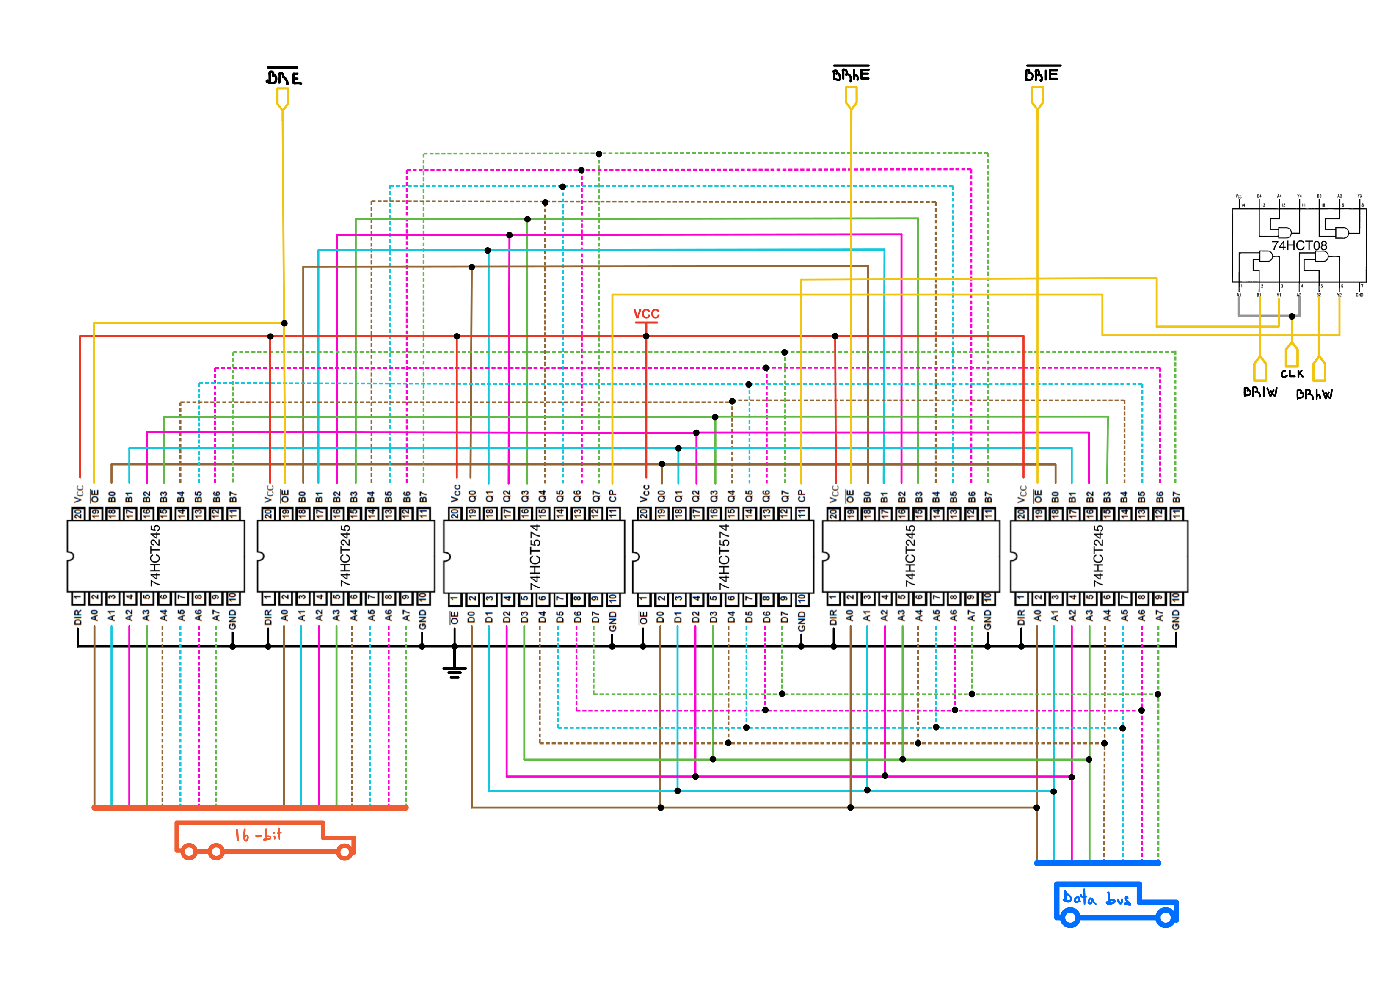
schematics_and_figures/Transfer Register/Images/Transfer Register.png
