Fadil-1/8-BIT-BREADBOARD-CPU/schematics_and_figures/Nomenclatures_figures/Nomenclatures Fgures.pdf

### General-purpose Control lines Clock

A/Q 0
A/Q 1
A/Q 2
A/Q 3
A/Q 4
A/Q 5
A/Q 6
A/Q 7

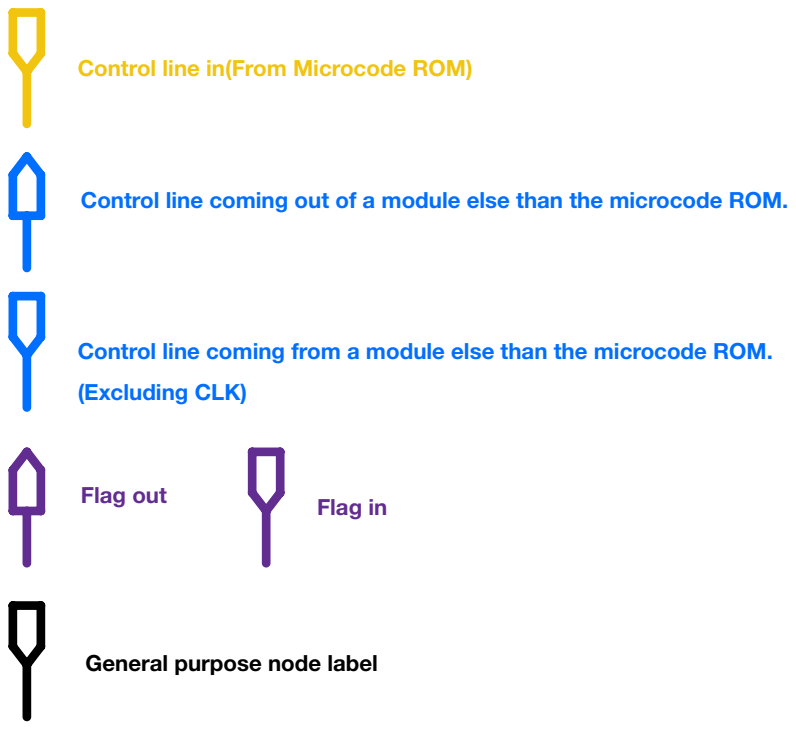
[picture p72: page 2]
Flag out; Flag in

Control line in(From Microcode ROM)

Control line coming out of a module else than the microcode ROM.

Control line coming from a module else than the microcode ROM.
(Excluding CLK)

General purpose node label

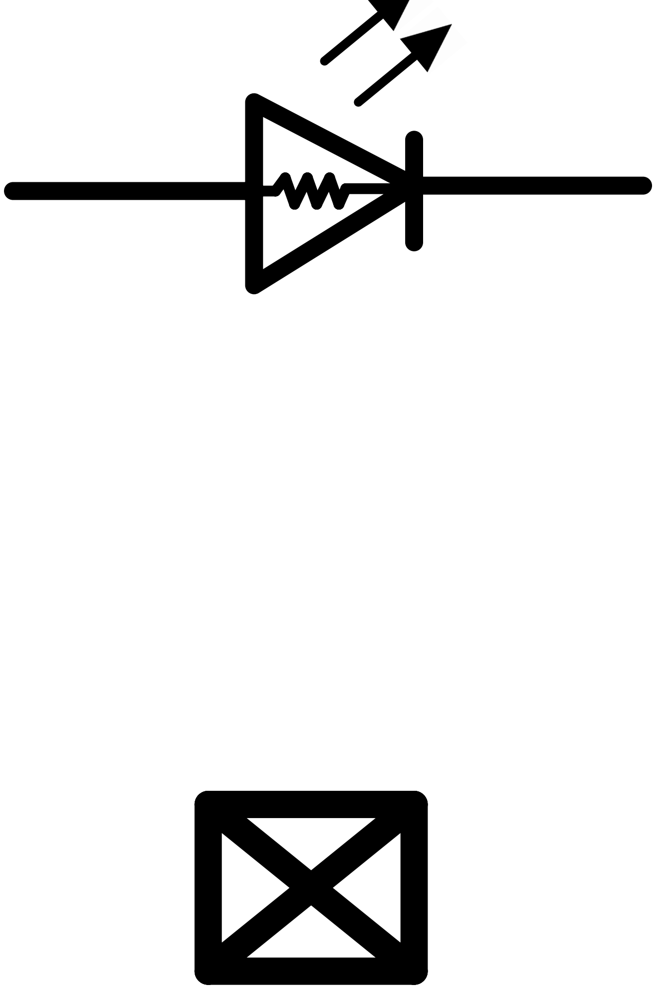
[picture p73: figure]

# LED with built-in resistor

# No connection

5V
