Fadil-1/8-BIT-BREADBOARD-CPU/schematics_and_figures/Nomenclatures_figures/Images/Nomenclatures_figures-1.png

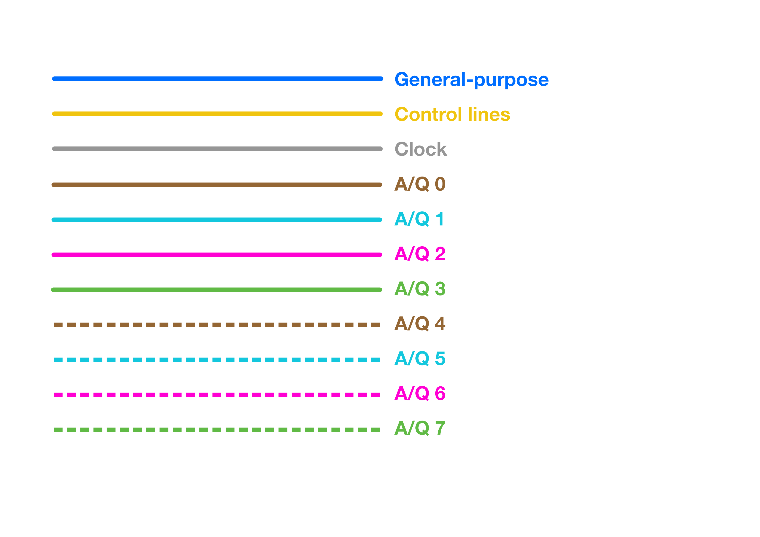
schematics_and_figures/Nomenclatures_figures/Images/Nomenclatures_figures-1.png
