Fadil-1/8-BIT-BREADBOARD-CPU/schematics_and_figures/Debugging CLK Figures/Images/Debugging_CLK_figures-09.png

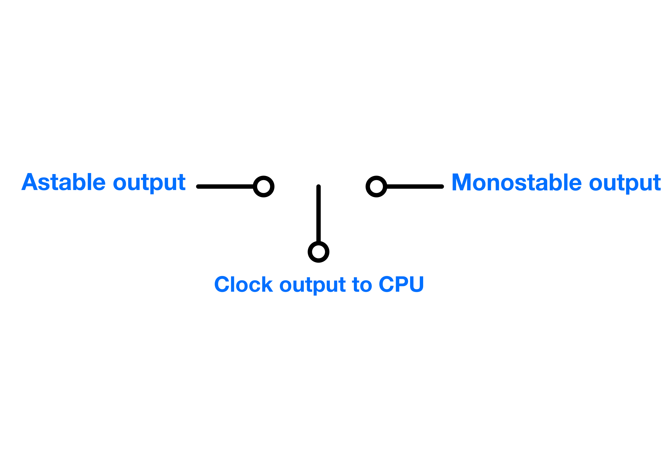
schematics_and_figures/Debugging CLK Figures/Images/Debugging_CLK_figures-09.png
