Fadil-1/8-BIT-BREADBOARD-CPU/schematics_and_figures/Debugging CLK Figures/Images/Debugging_CLK_figures-10.png

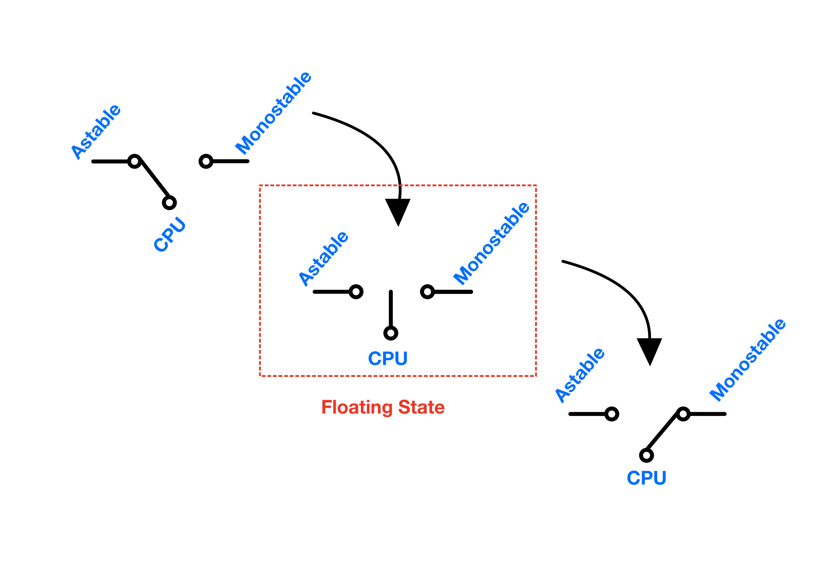
schematics_and_figures/Debugging CLK Figures/Images/Debugging_CLK_figures-10.png
