Fadil-1/8-BIT-BREADBOARD-CPU/schematics_and_figures/Debugging Clock/Images/Debugging Clock.png

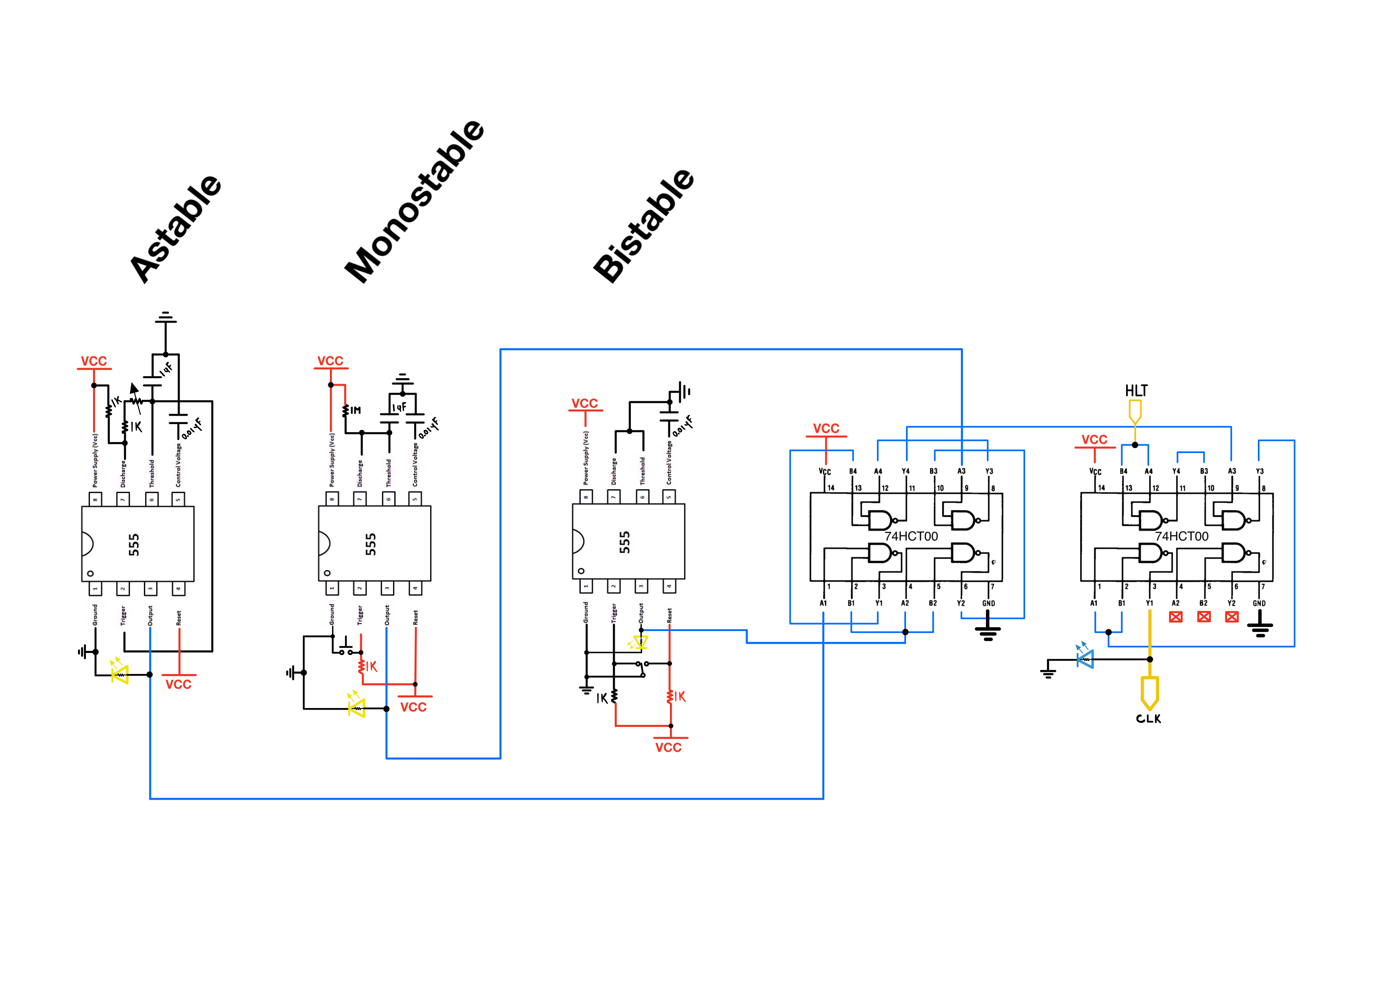
schematics_and_figures/Debugging Clock/Images/Debugging Clock.png
