Fadil-1/8-BIT-BREADBOARD-CPU/schematics_and_figures/Control Logic/Control Logic.pdf

### Sch

### sinCLK

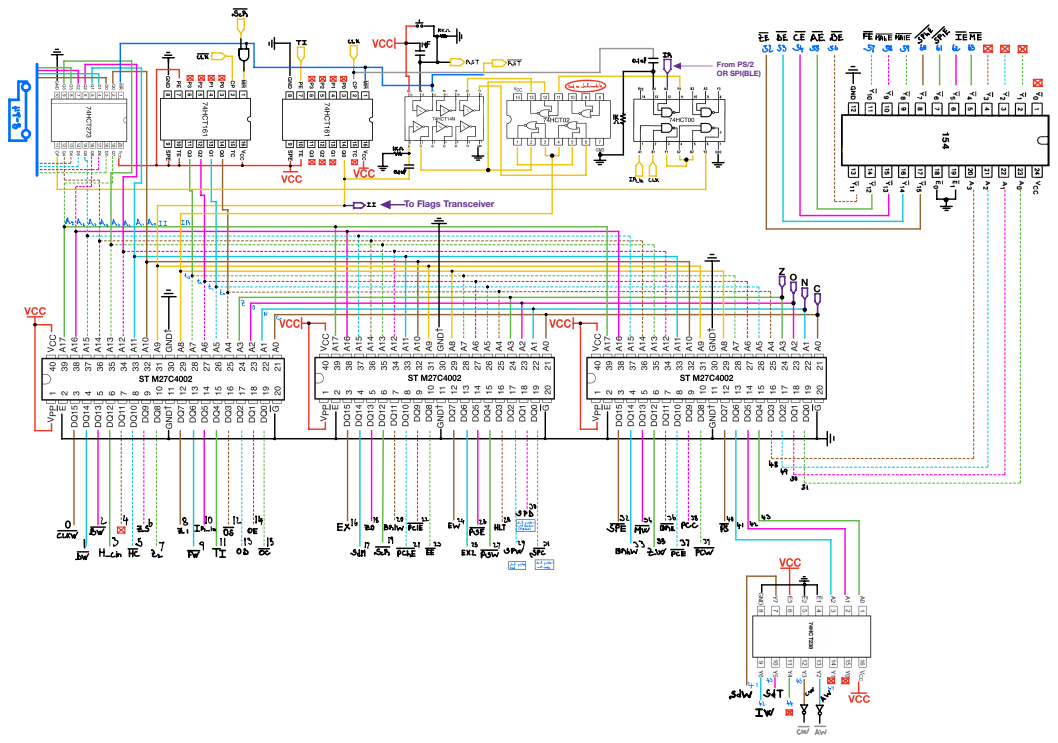
[picture p87: page 1]
FEB; EgE gyma Mag; o.int 3; o.int; ififi.it ff; sp must 256 28; sumsonpch; ps s.fiffi; Eism; CW⁷⁴HCT238

From PS/2
OR SPI(BLE)

used.net.inmodule

To Flags Transceiver
