Fadil-1/8-BIT-BREADBOARD-CPU/schematics_and_figures/SPI Bus/SPI BUS.pdf

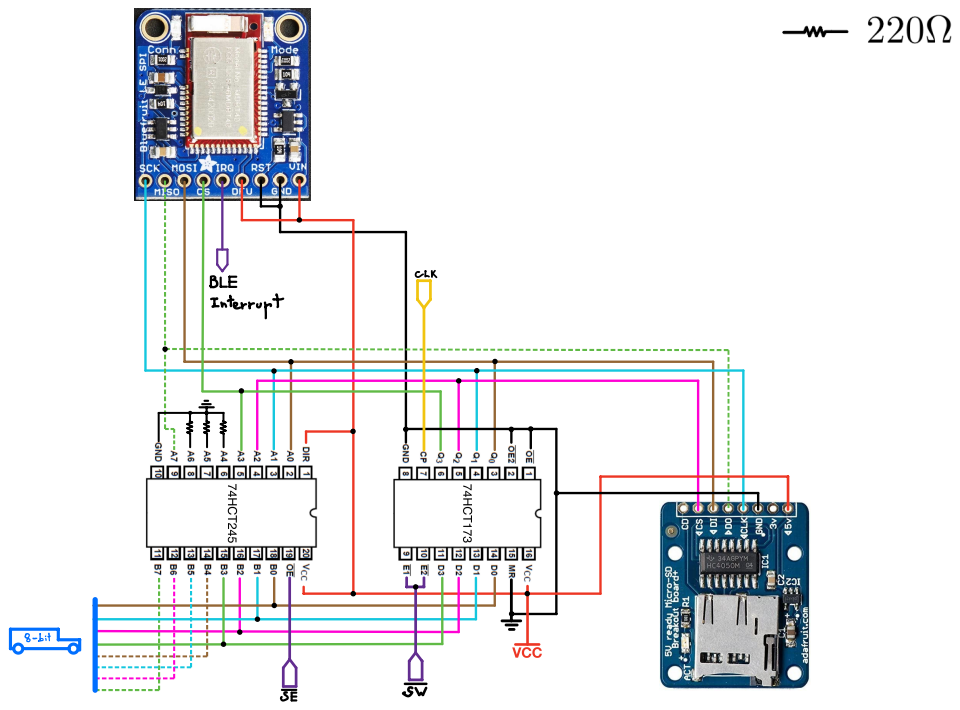
[picture p88: page 1]
CLK3; Interrupt8; bitSS

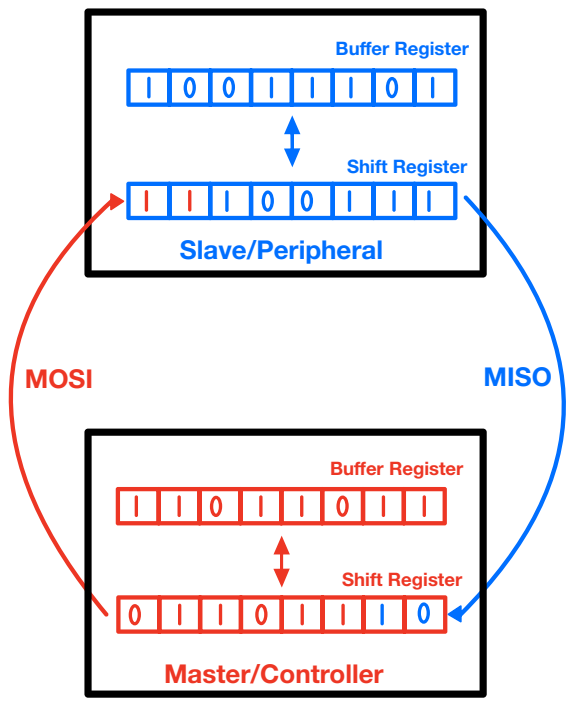
[picture p89: page 2]
MOSI; MISO; Slave/Peripheral; Master/Controller; Shift Register; Buffer Register
