Fadil-1/8-BIT-BREADBOARD-CPU/schematics_and_figures/Basics Figures/Basics Figures.pdf

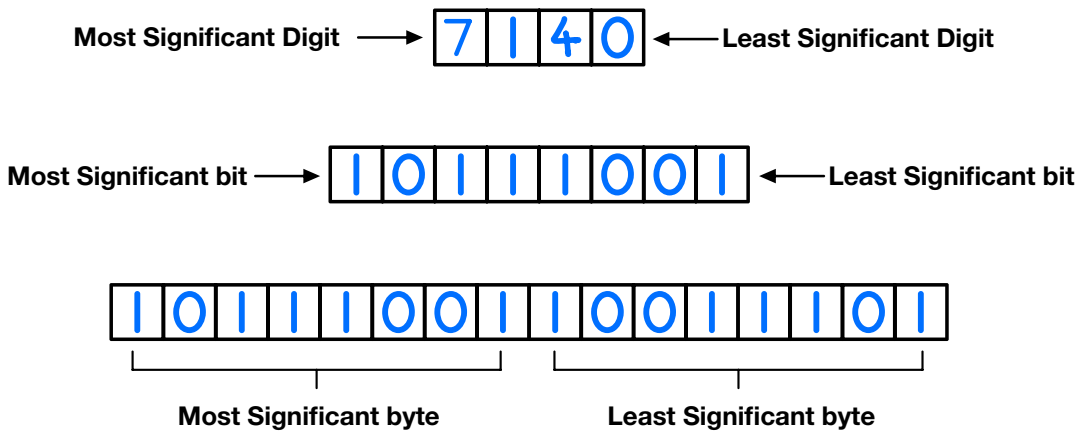
[picture p90: page 1]
4 Most Significant Digit; Least Significant Digit

Most Significant bit

Least Significant bit

Most Significant byte

Least Significant byte

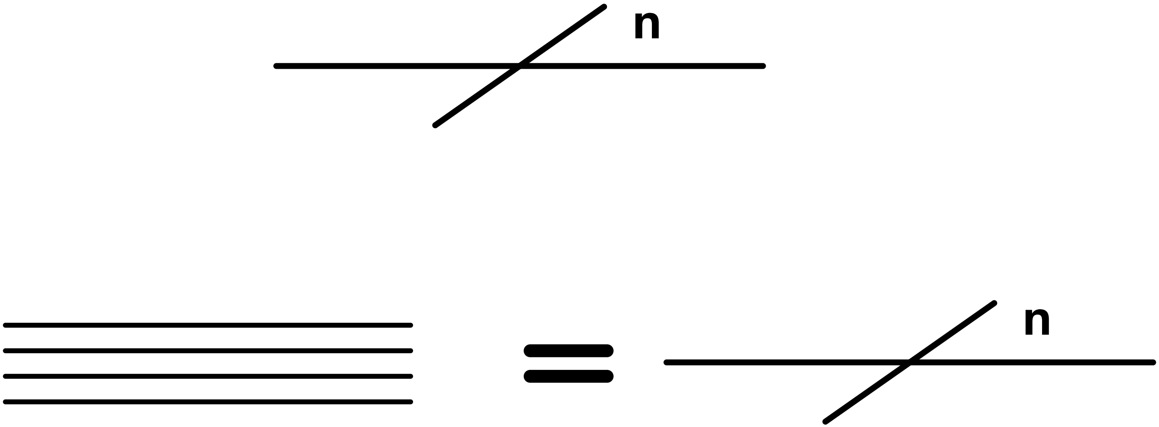
[picture p91: figure]
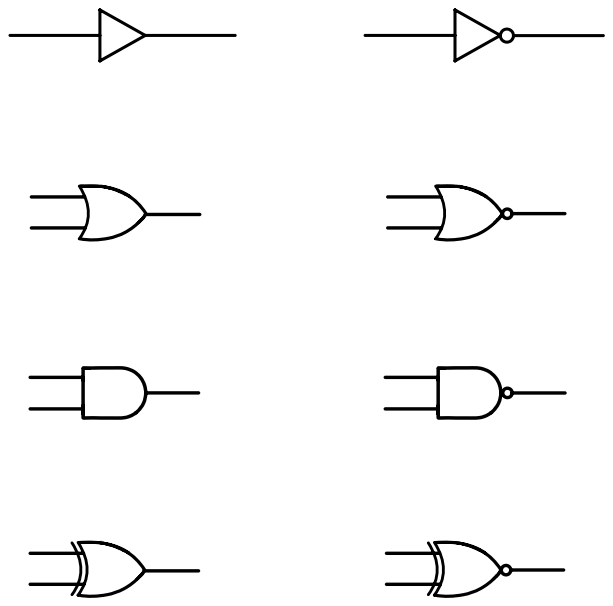
[picture p92: page 3]

It

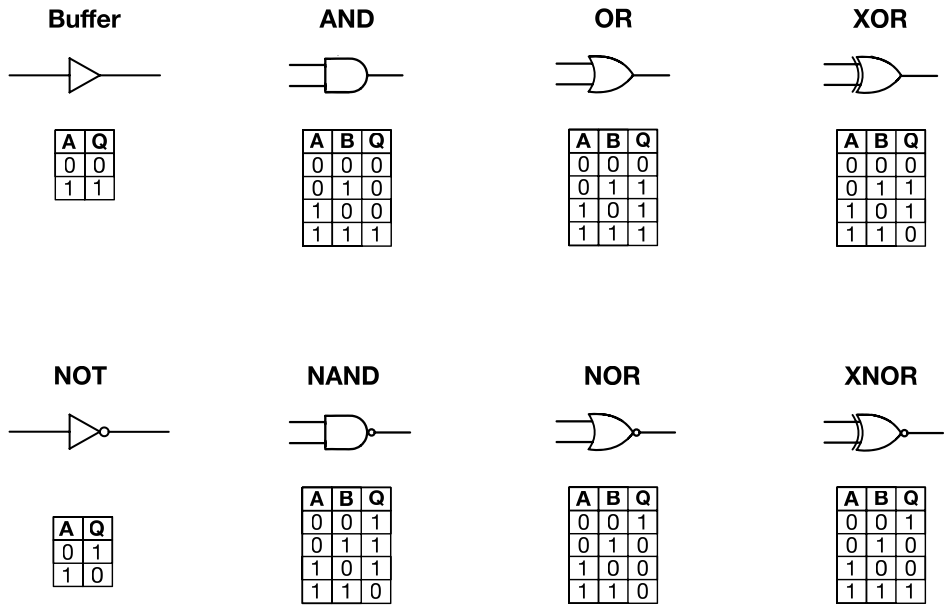
[picture p93: page 4]

Vcc | Vcc

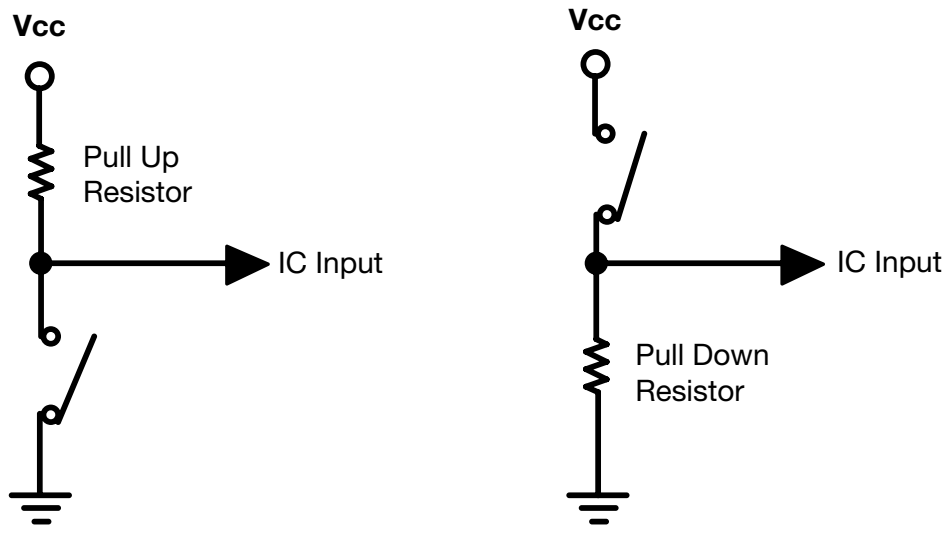
[picture p94: page 5]
Pull Up Resistor; Pull Down Resistor; IC Input

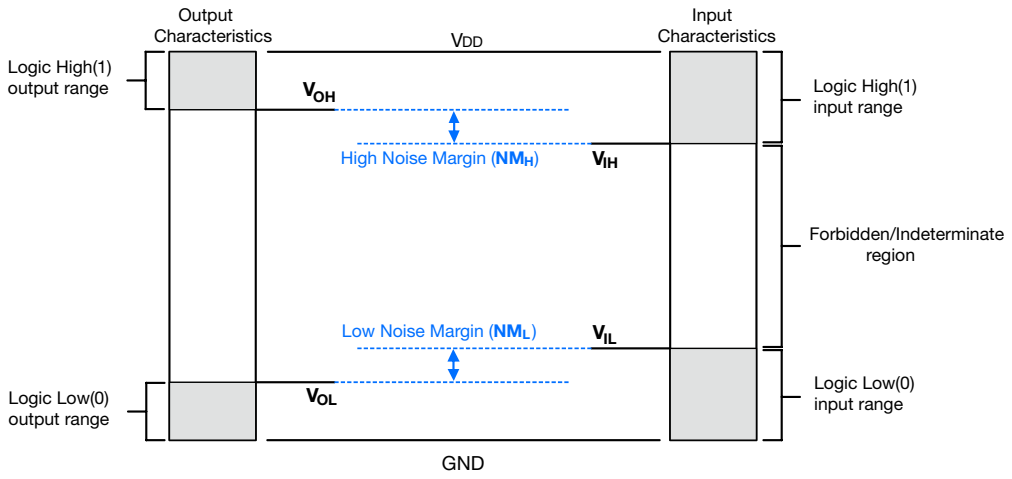
[picture p95: page 6]
Forbidden/Indeterminate region; Logic Low(0) output range; Logic Low(0) input range; Logic High(1); GND; Logic High(1) output range; Input; VDD; Characteristics; Output Characteristics

input range OH

High Noise Margin (NMH )

Low Noise Margin (NM ) L

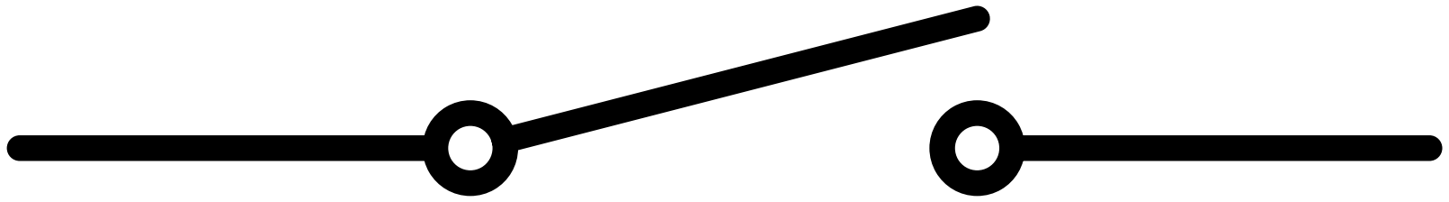
[picture p96: figure]
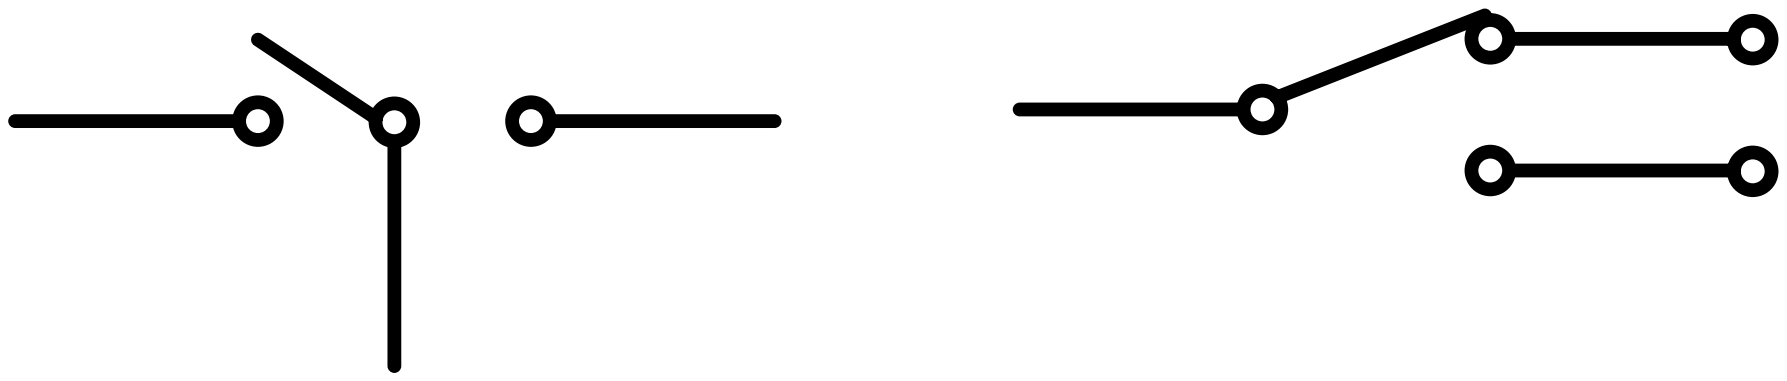
[picture p97: page 8]

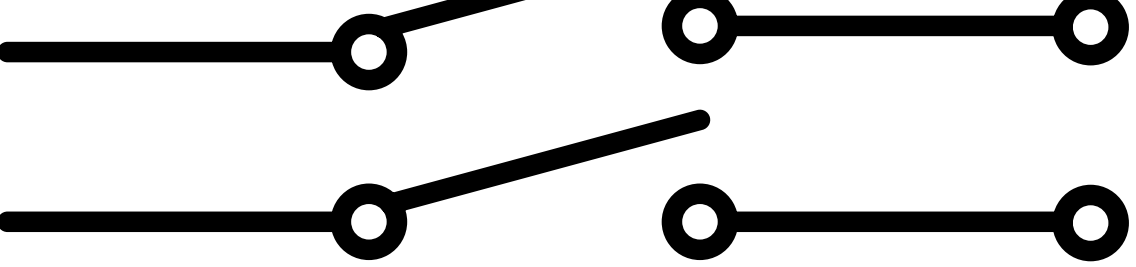
[picture p98: figure]
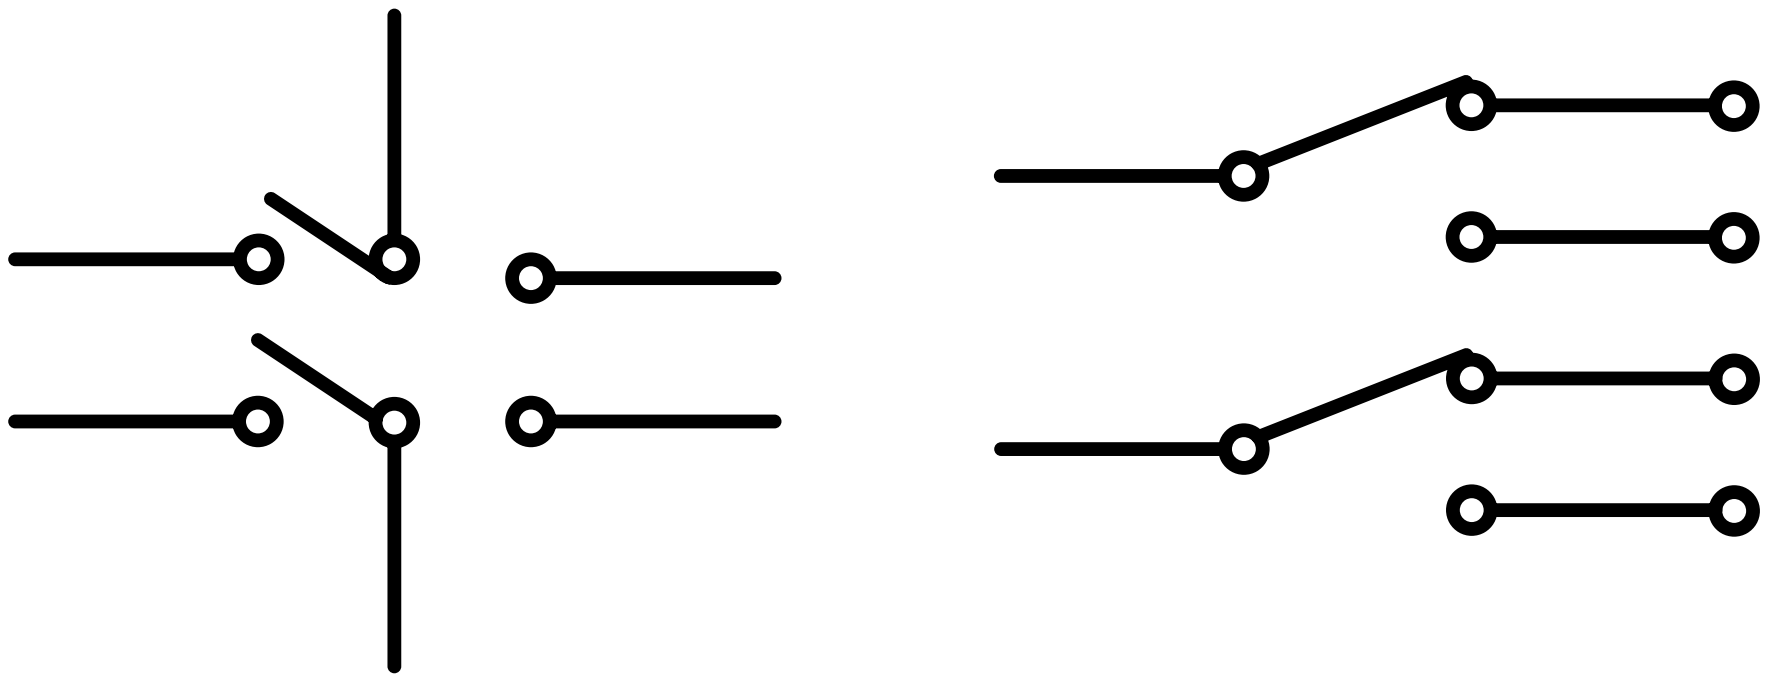
[picture p99: page 10]

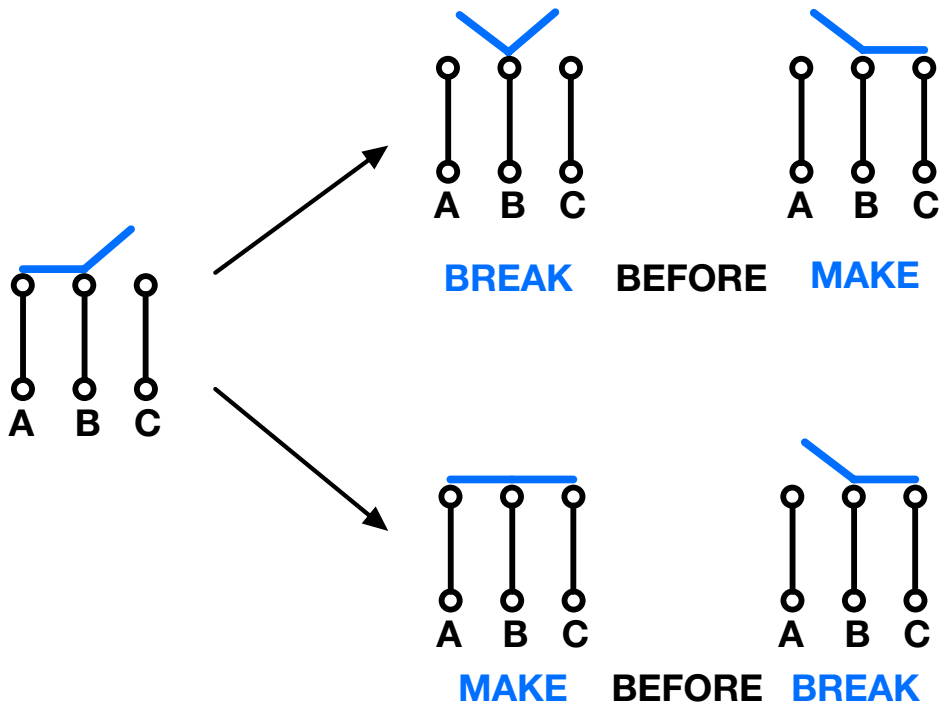
[picture p100: page 11]

BREAK BEFORE MAKE

MAKE BEFORE BREAK

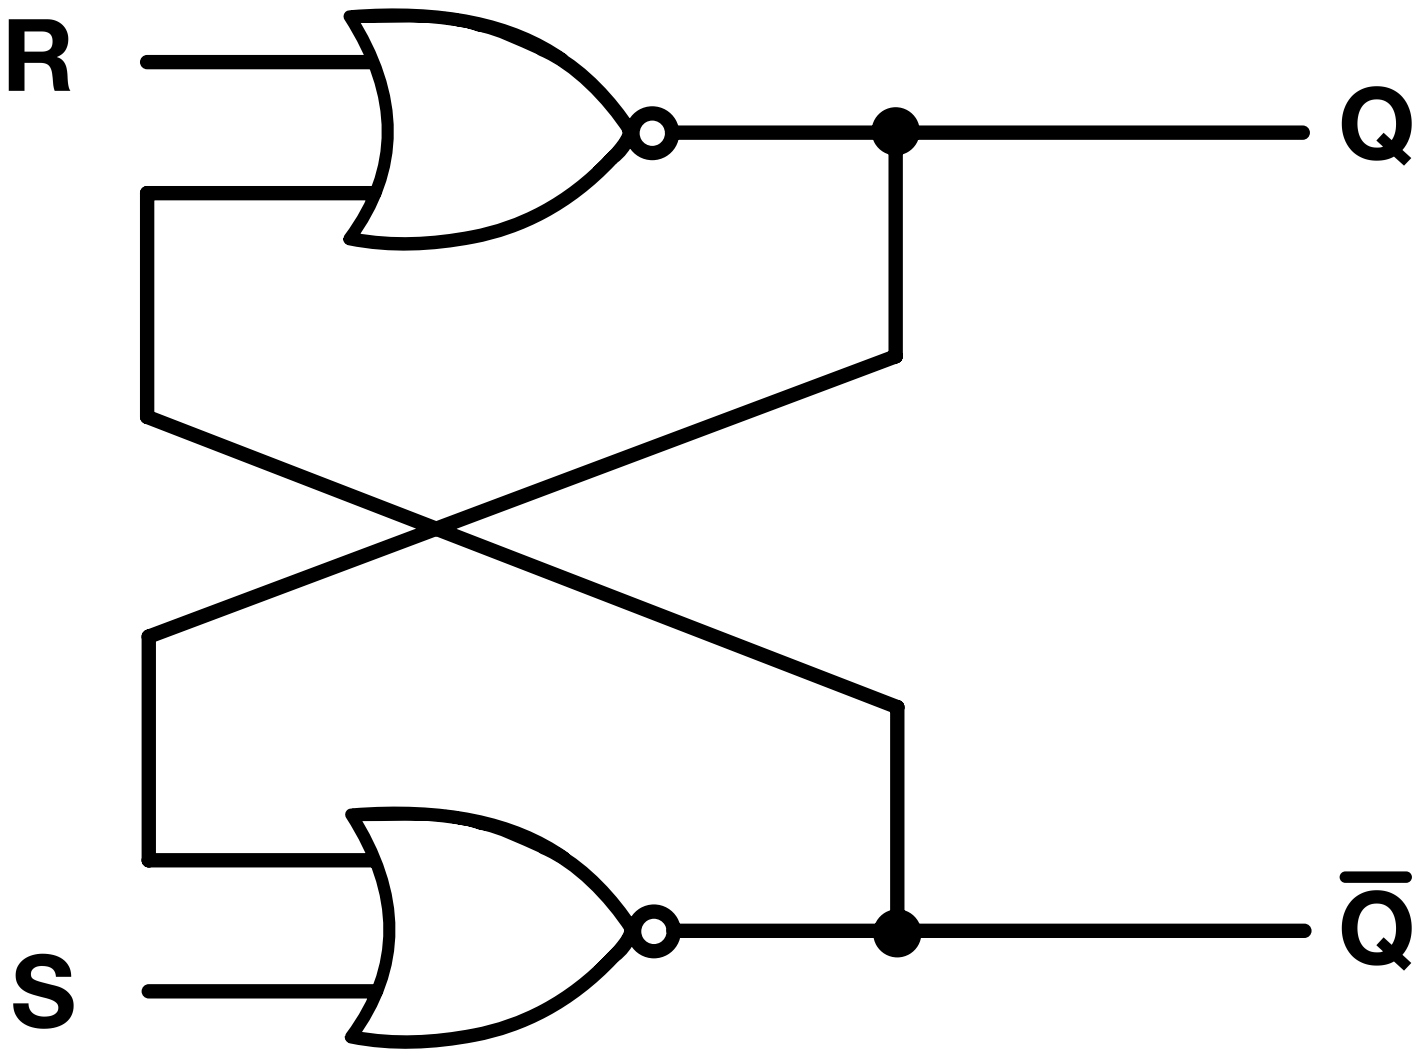
[picture p101: page 12]

R Q

S Q

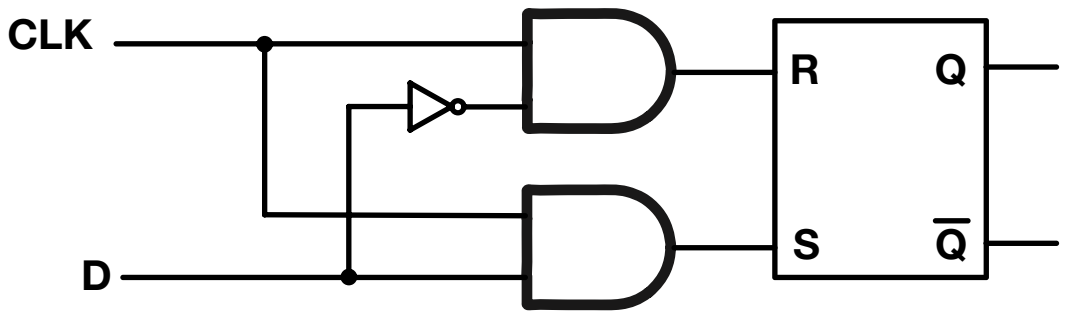
[picture p102: page 14]
CLK

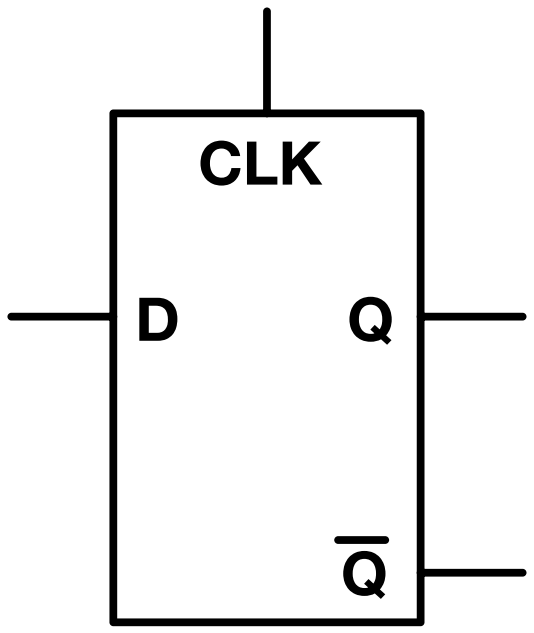
[picture p103: figure]
CLK

D

### CLK

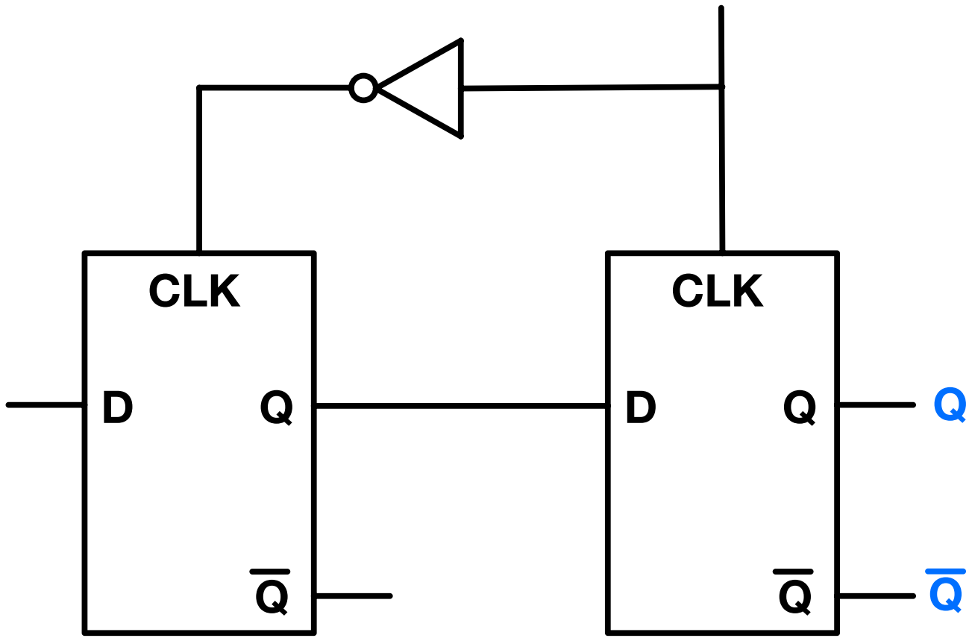
[picture p104: figure]
CLK

L1 | L2

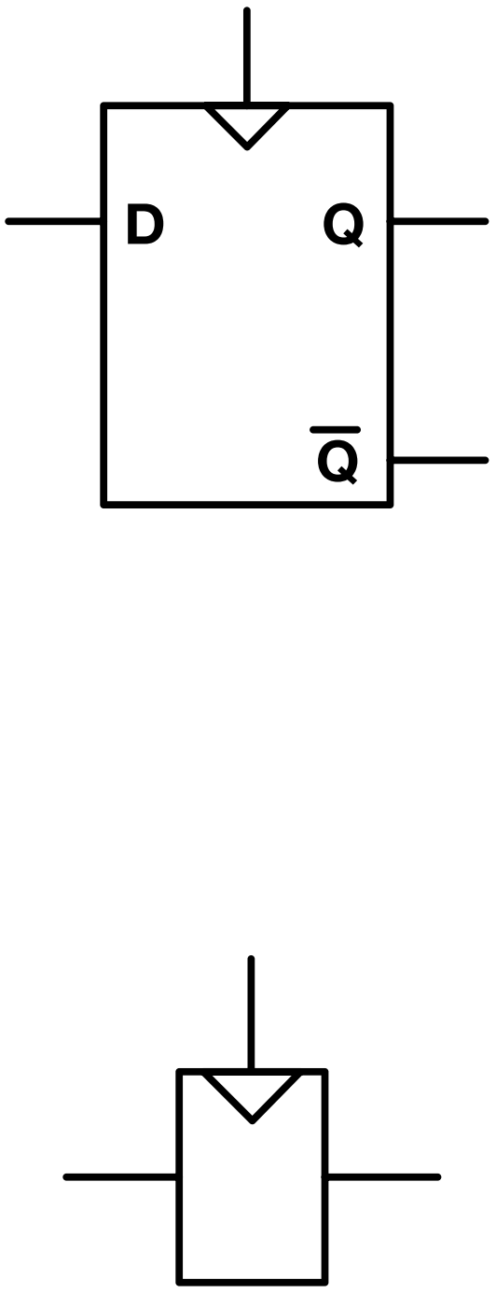
[picture p105: figure]
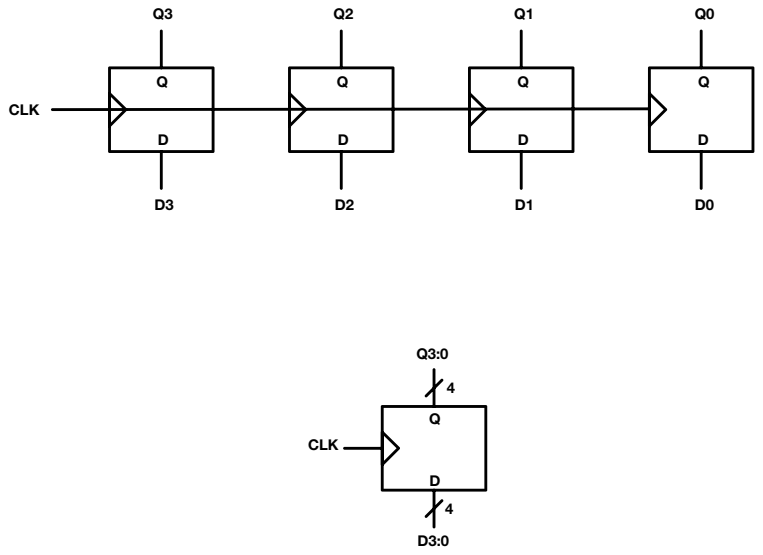
[picture p106: page 18]

Driver | Receiver

D
D ⁰1234567

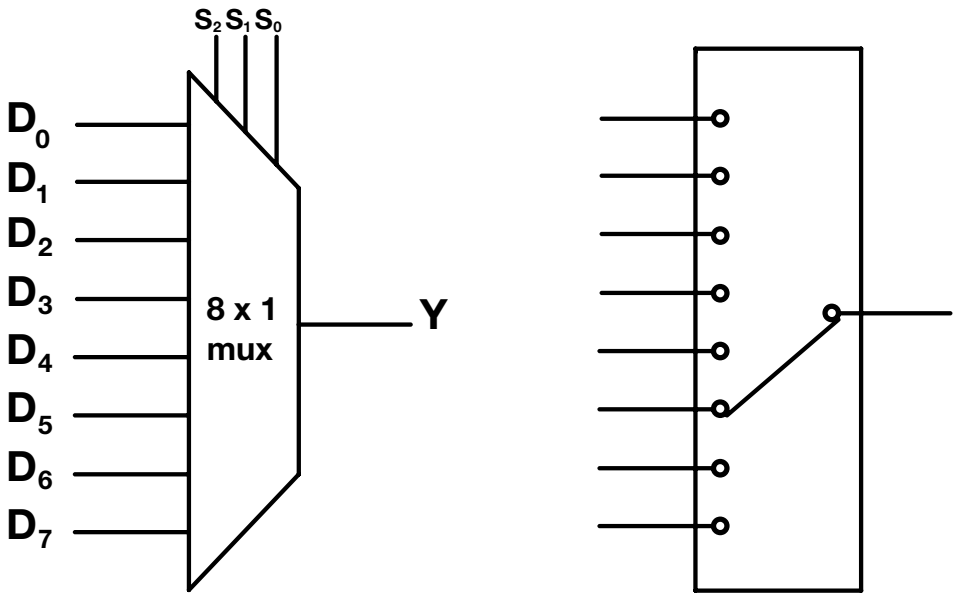
[picture p107: page 20]
mux S2S1S

Y

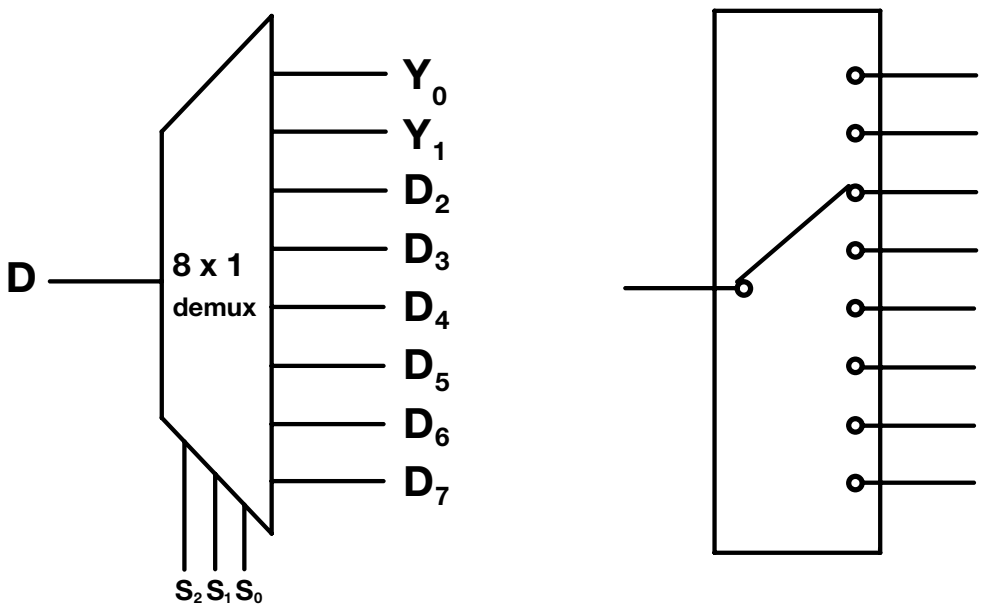
[picture p108: page 21]
x 1 demux
