Fadil-1/8-BIT-BREADBOARD-CPU/schematics_and_figures/Layout/Layout.pdf

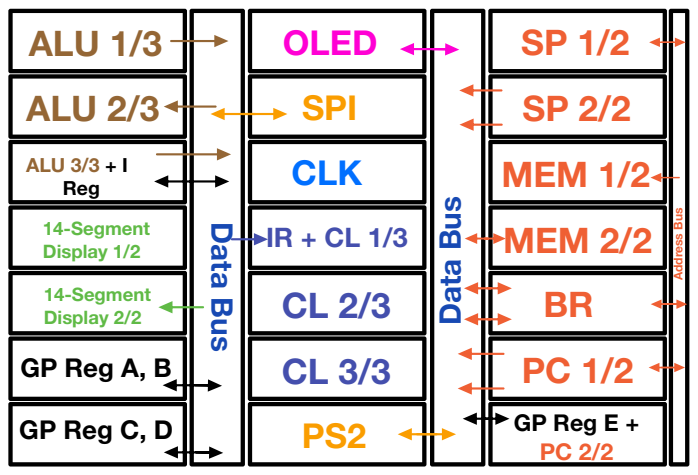
[picture p109: page 1]
MEM 1/2; ALU 1/3; ALU 2/3; 14-Segment Display 1/2; 14-Segment Display 2/2; CLK; GP Reg A,; GP Reg C,; OLED; SPI; Data Bus; MEM 2/2; Address Bus; GP Reg; ALU 3/3; Reg
