Fadil-1/8-BIT-BREADBOARD-CPU/schematics_and_figures/Debugging CLK Figures/Debugging CLK figures.pdf

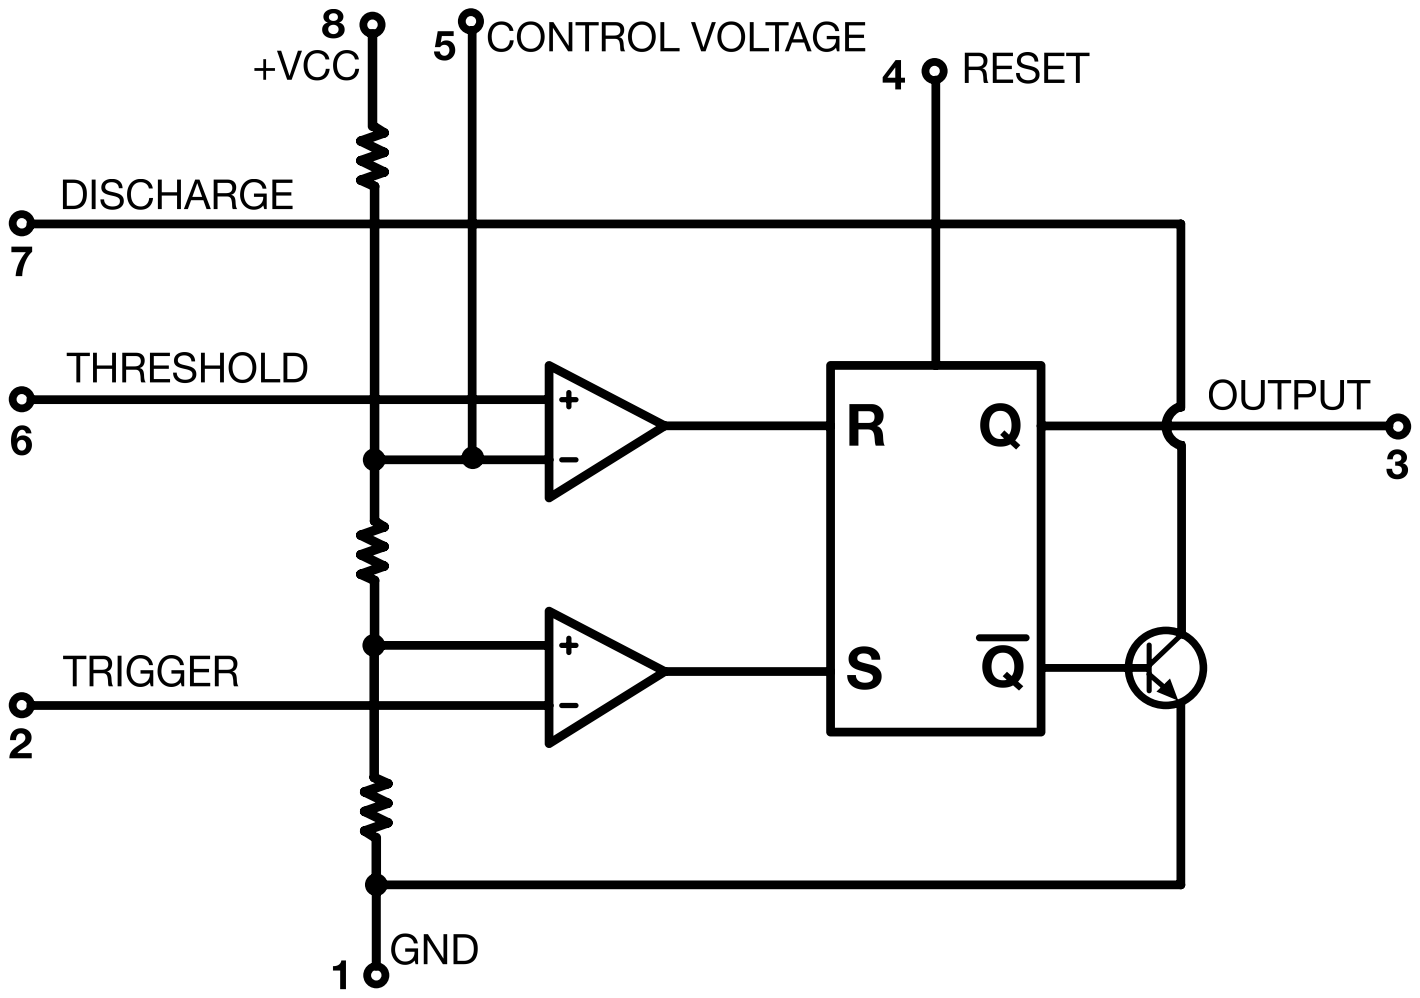
[picture p110: page 1]

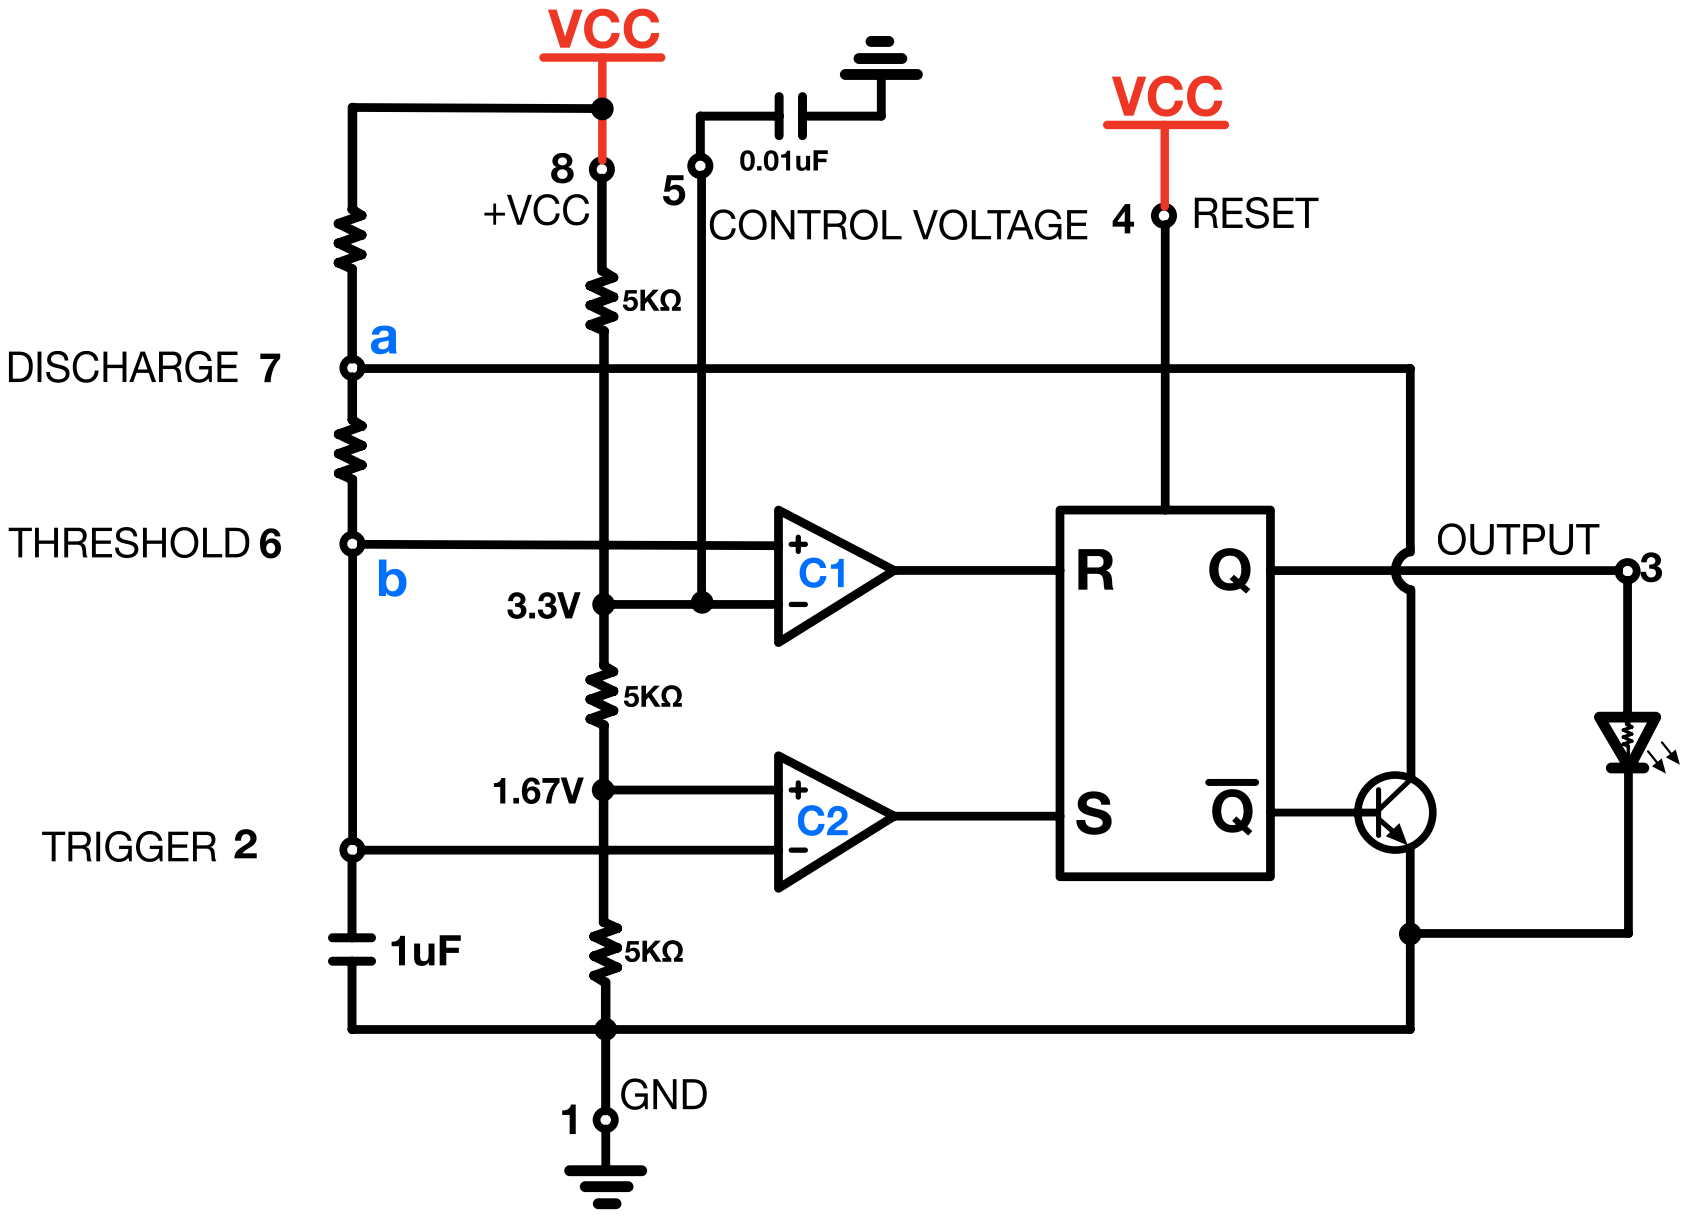
[picture p111: page 2]

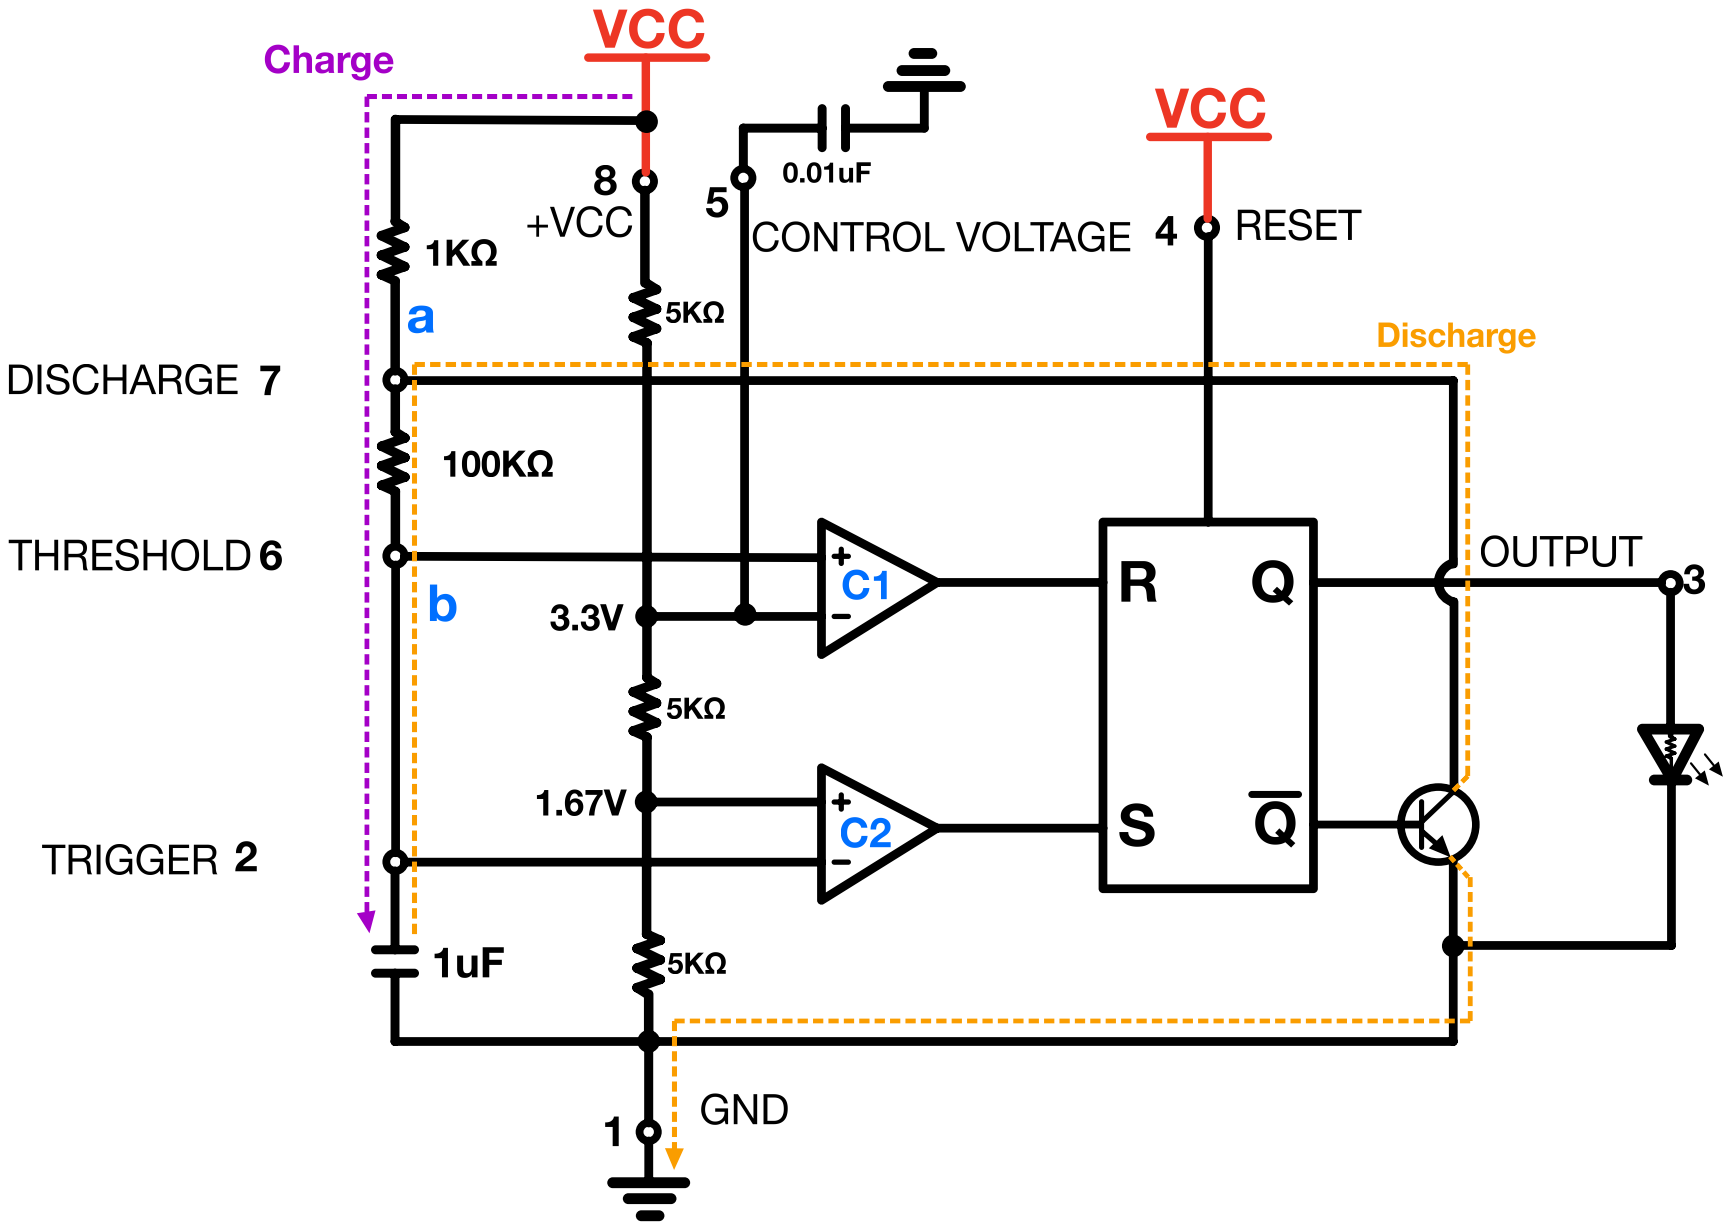
[picture p112: page 3]

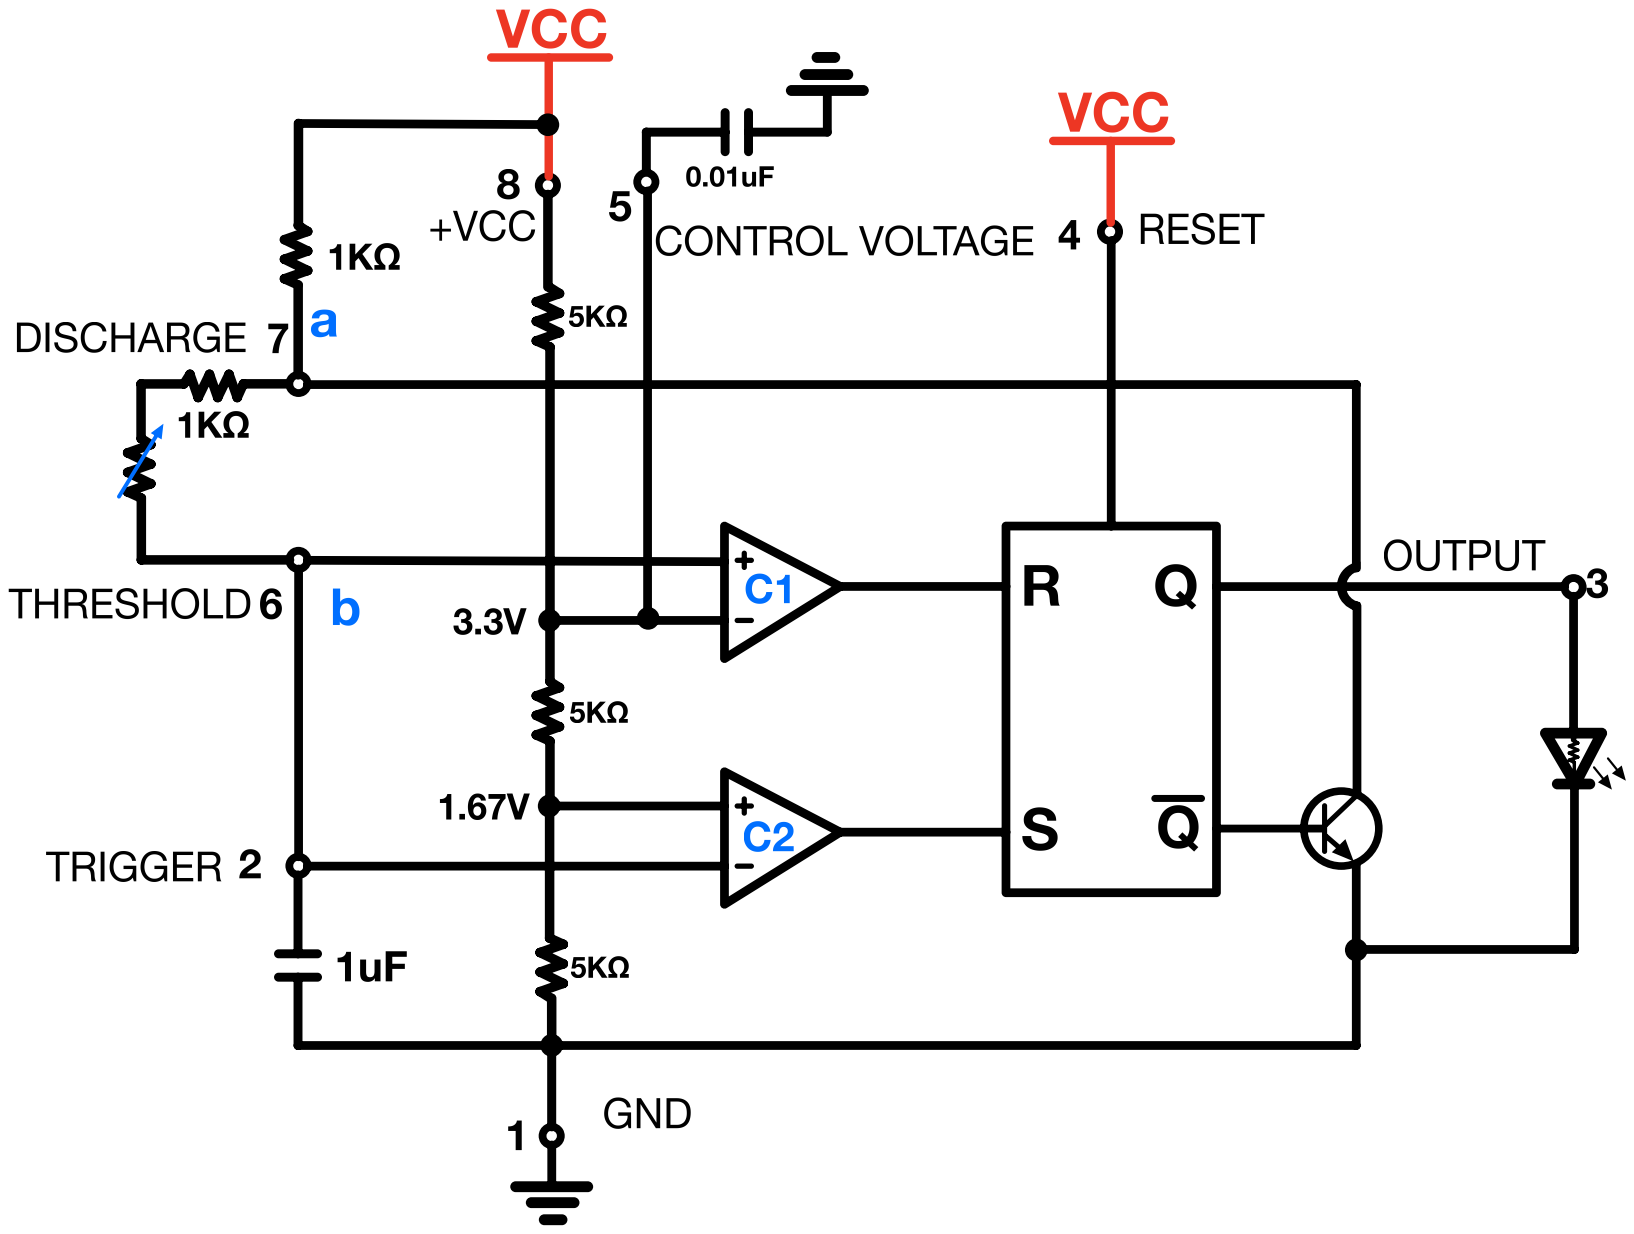
[picture p113: page 4]

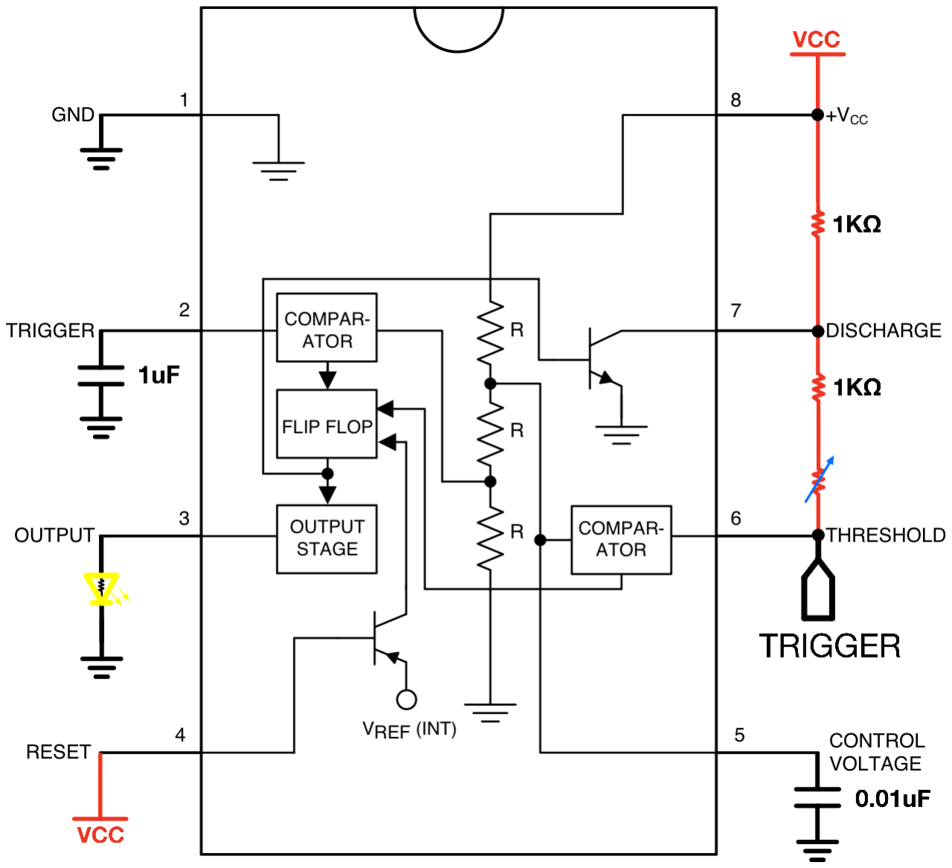
[picture p114: page 5]
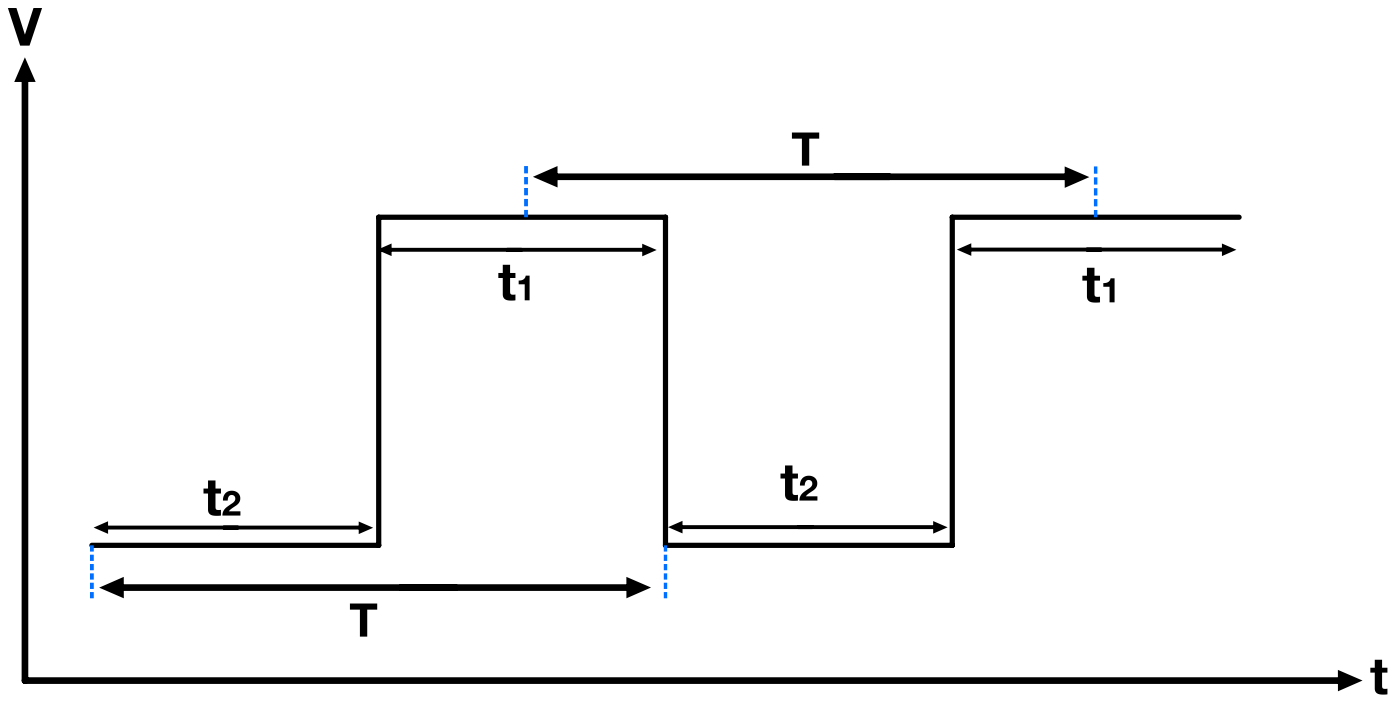
[picture p115: page 6]

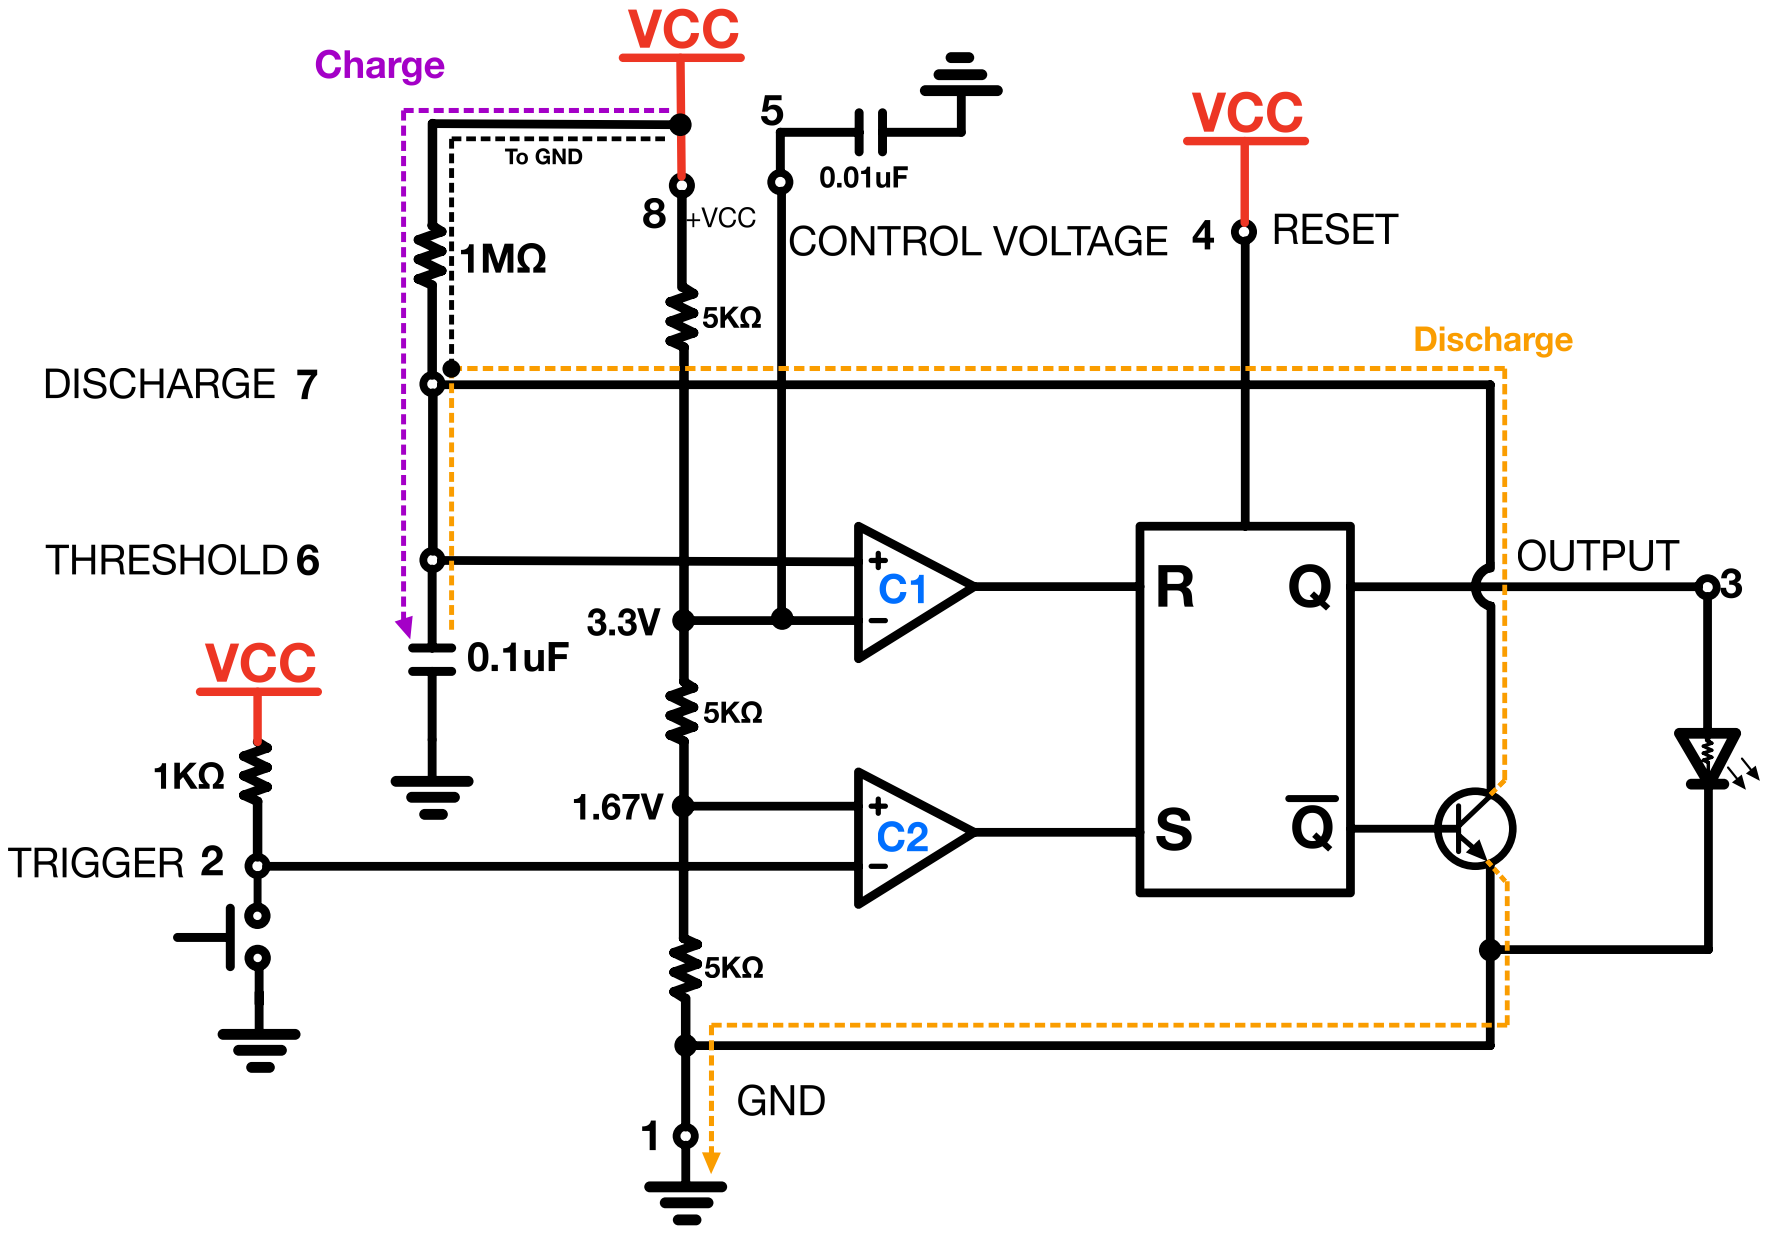
[picture p116: page 7]

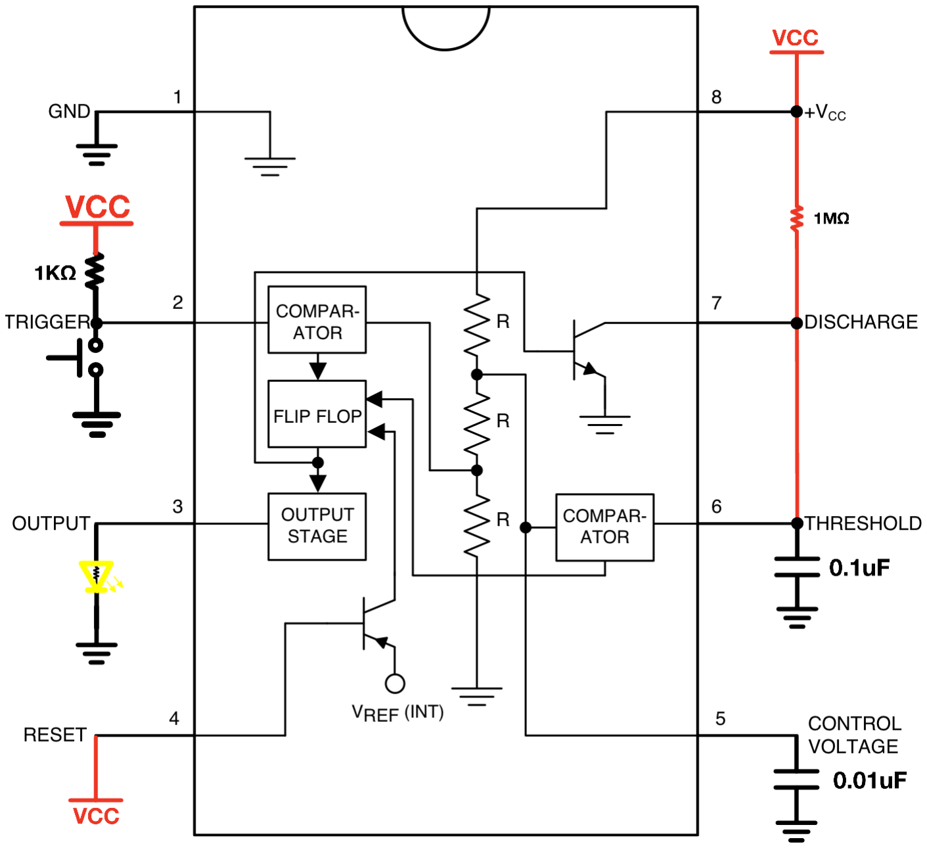
[picture p117: page 8]

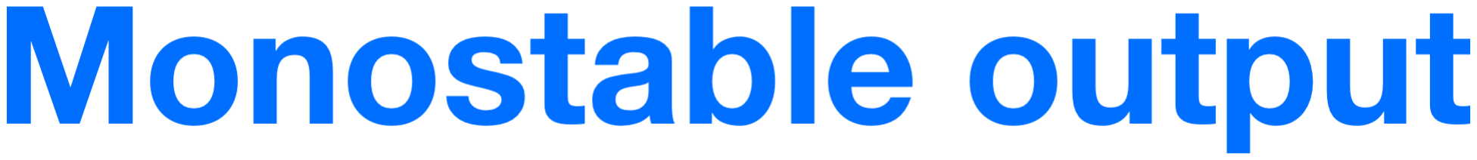
[picture p118: figure]
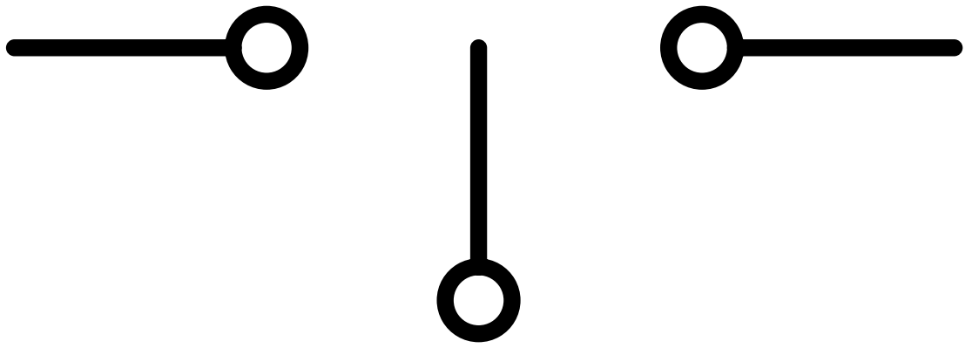
[picture p119: figure]
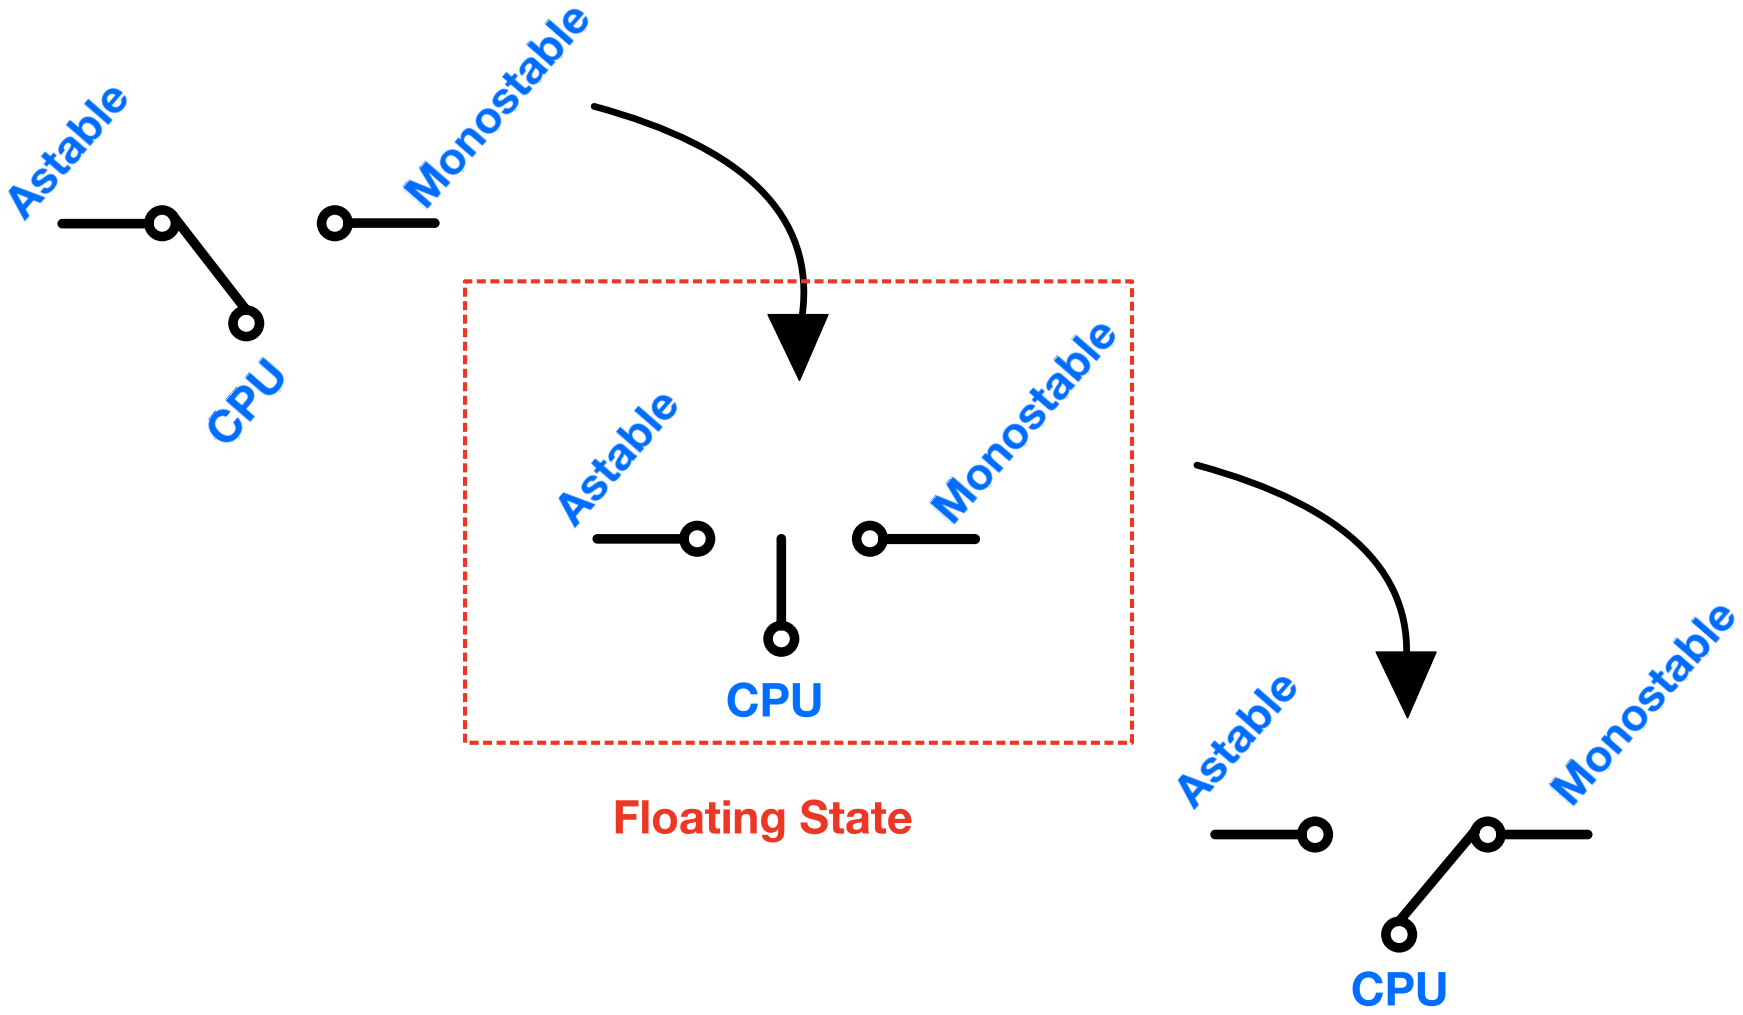
[picture p120: page 10]

A

B

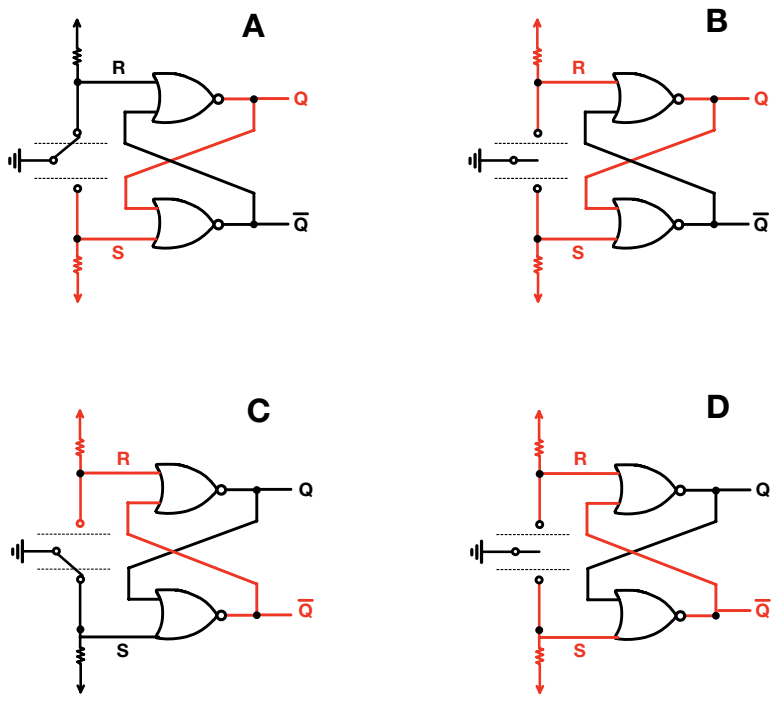
[picture p121: page 11]

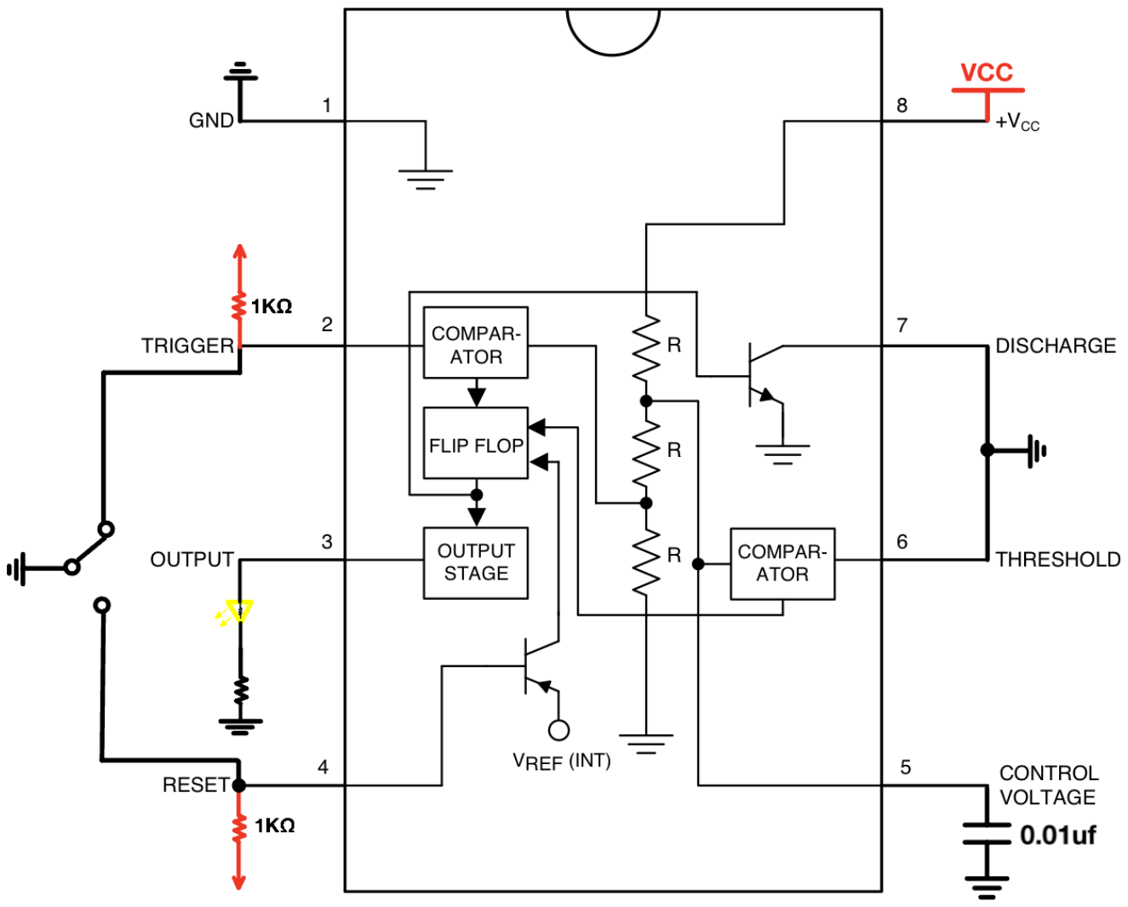
[picture p122: page 12]
