Fadil-1/8-BIT-BREADBOARD-CPU/schematics_and_figures/Debugging Clock/Debugging Clock.pdf

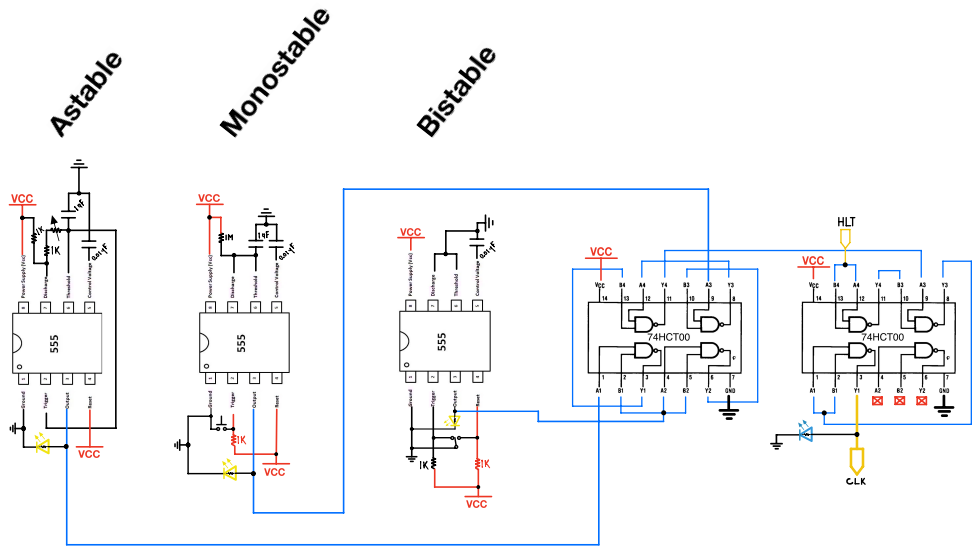
[picture p123: page 1]
art; get
