Fadil-1/8-BIT-BREADBOARD-CPU/schematics_and_figures/OLED Display/OLED Display.pdf

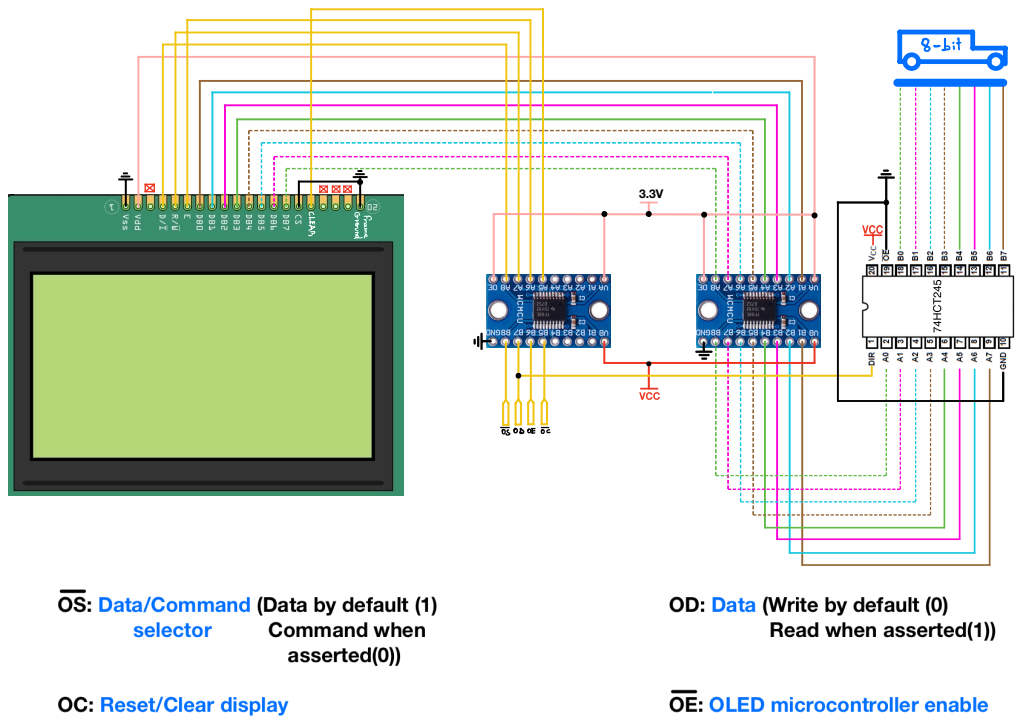
[picture p124: page 1]
SEEadf.aeBi; osODooc

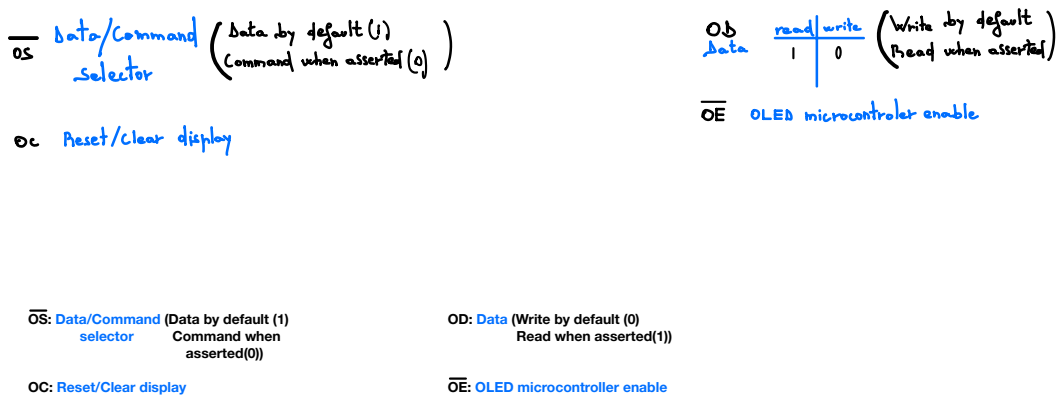
[picture p125: page 3]
data; read write; selector; I microcontroletenable; Reset clear display; OS: Data/Command (Data by default (1); OD: Data (Write by default (0); Command when; Read when asserted(1)); asserted(0)); OC: Reset/Clear display; OE: OLED microcontroller enable

OD d atranboyadf.eu se4fed

head yandex.fi tted
