Fadil-1/8-BIT-BREADBOARD-CPU/schematics_and_figures/Port Selector/Port Selector.pdf

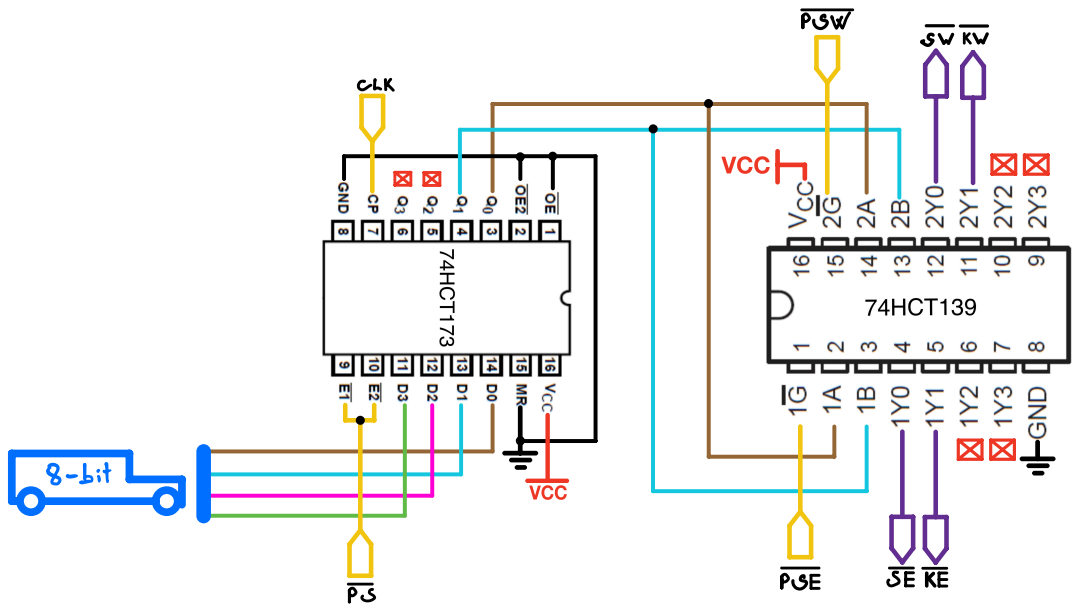
[picture p126: page 1]
PSW; CLK
