Fadil-1/8-BIT-BREADBOARD-CPU/schematics_and_figures/ALU & Flags Figures/ALU & Flags Figures.pdf

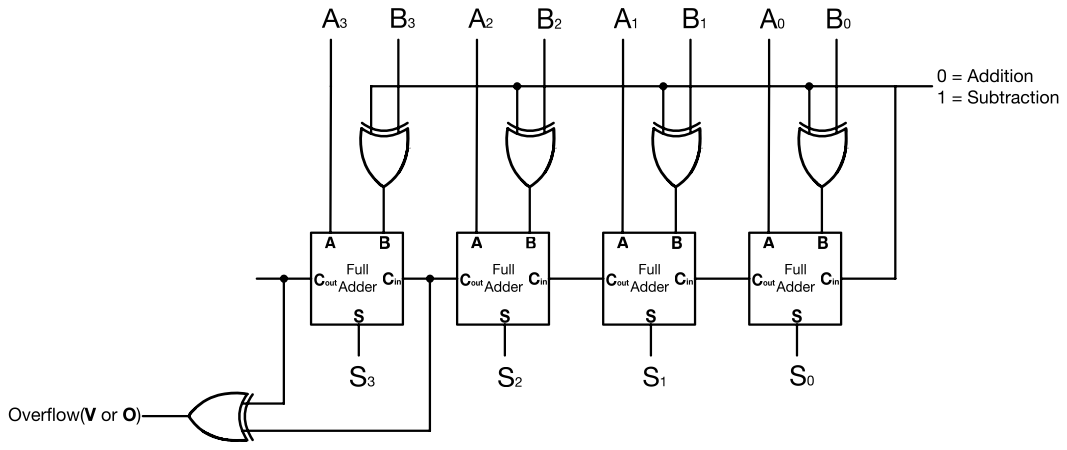
[picture p127: page 1]
