Fadil-1/8-BIT-BREADBOARD-CPU/schematics_and_figures/ALU Primer Figures/ALU Primer Figures.pdf

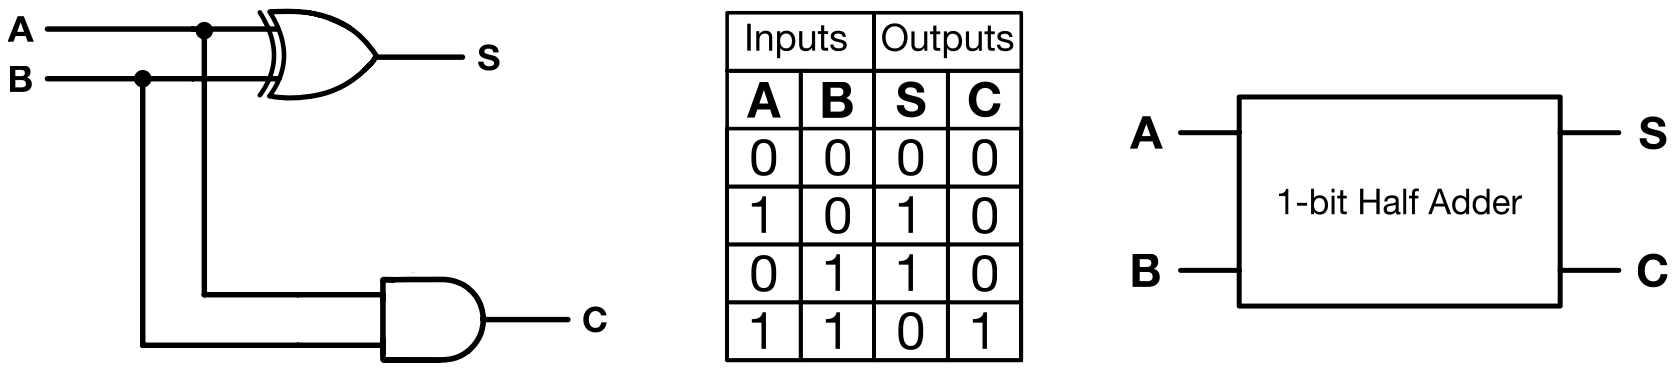
[picture p128: page 1]

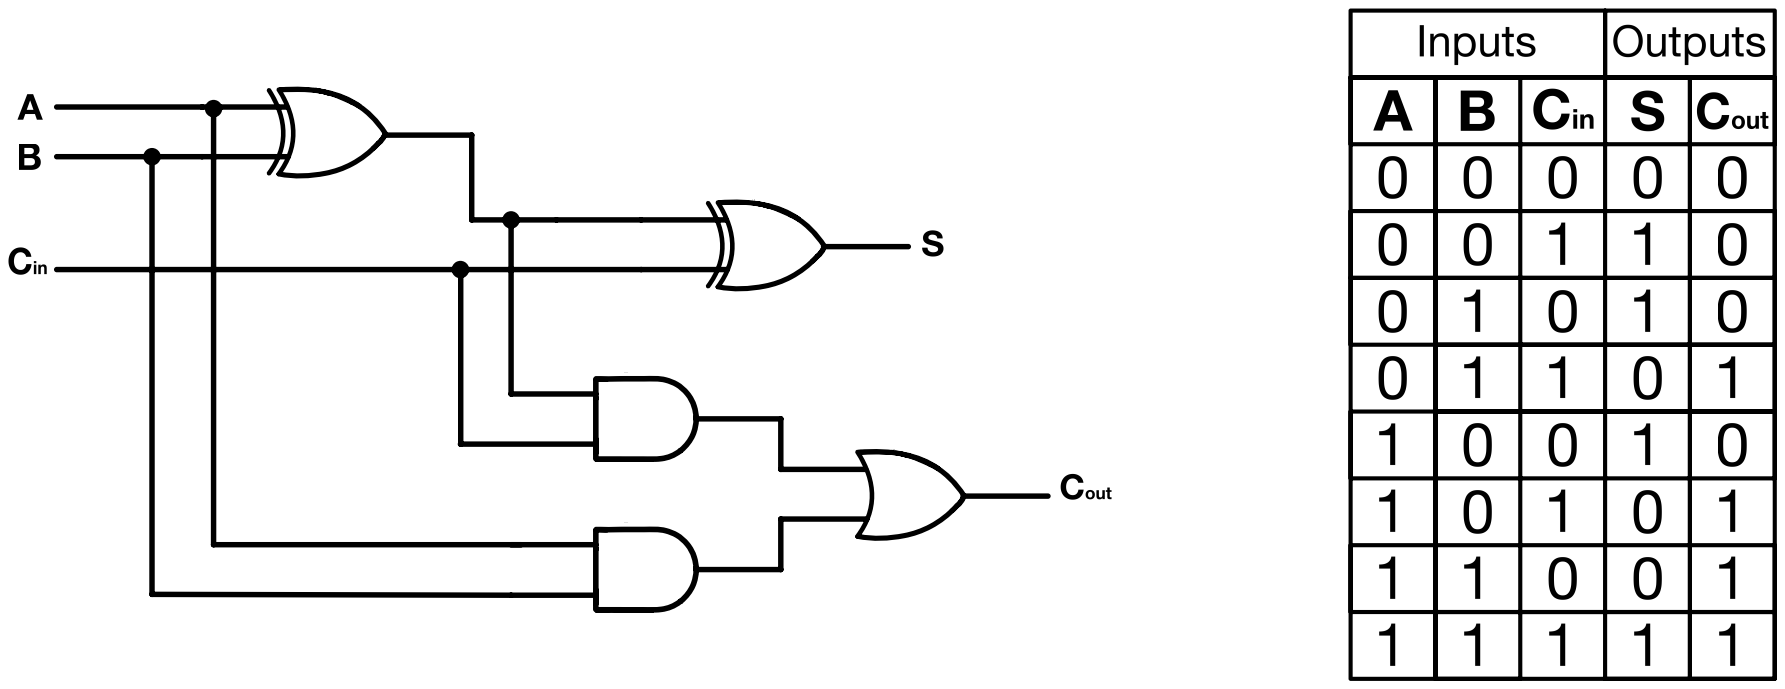
[picture p129: page 2]

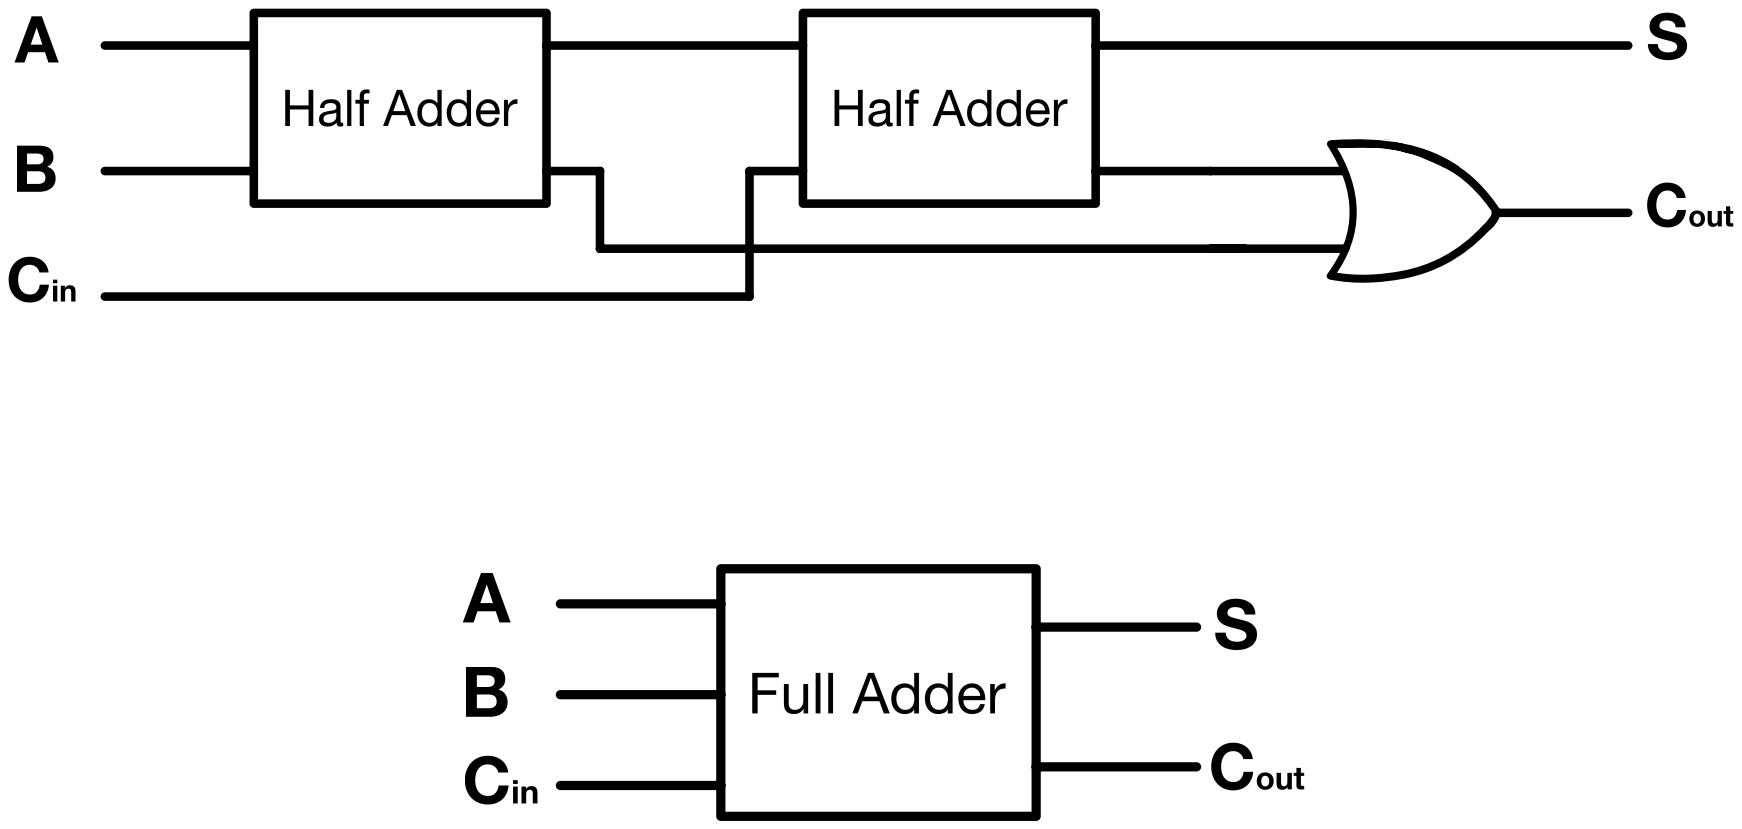
[picture p130: page 3]

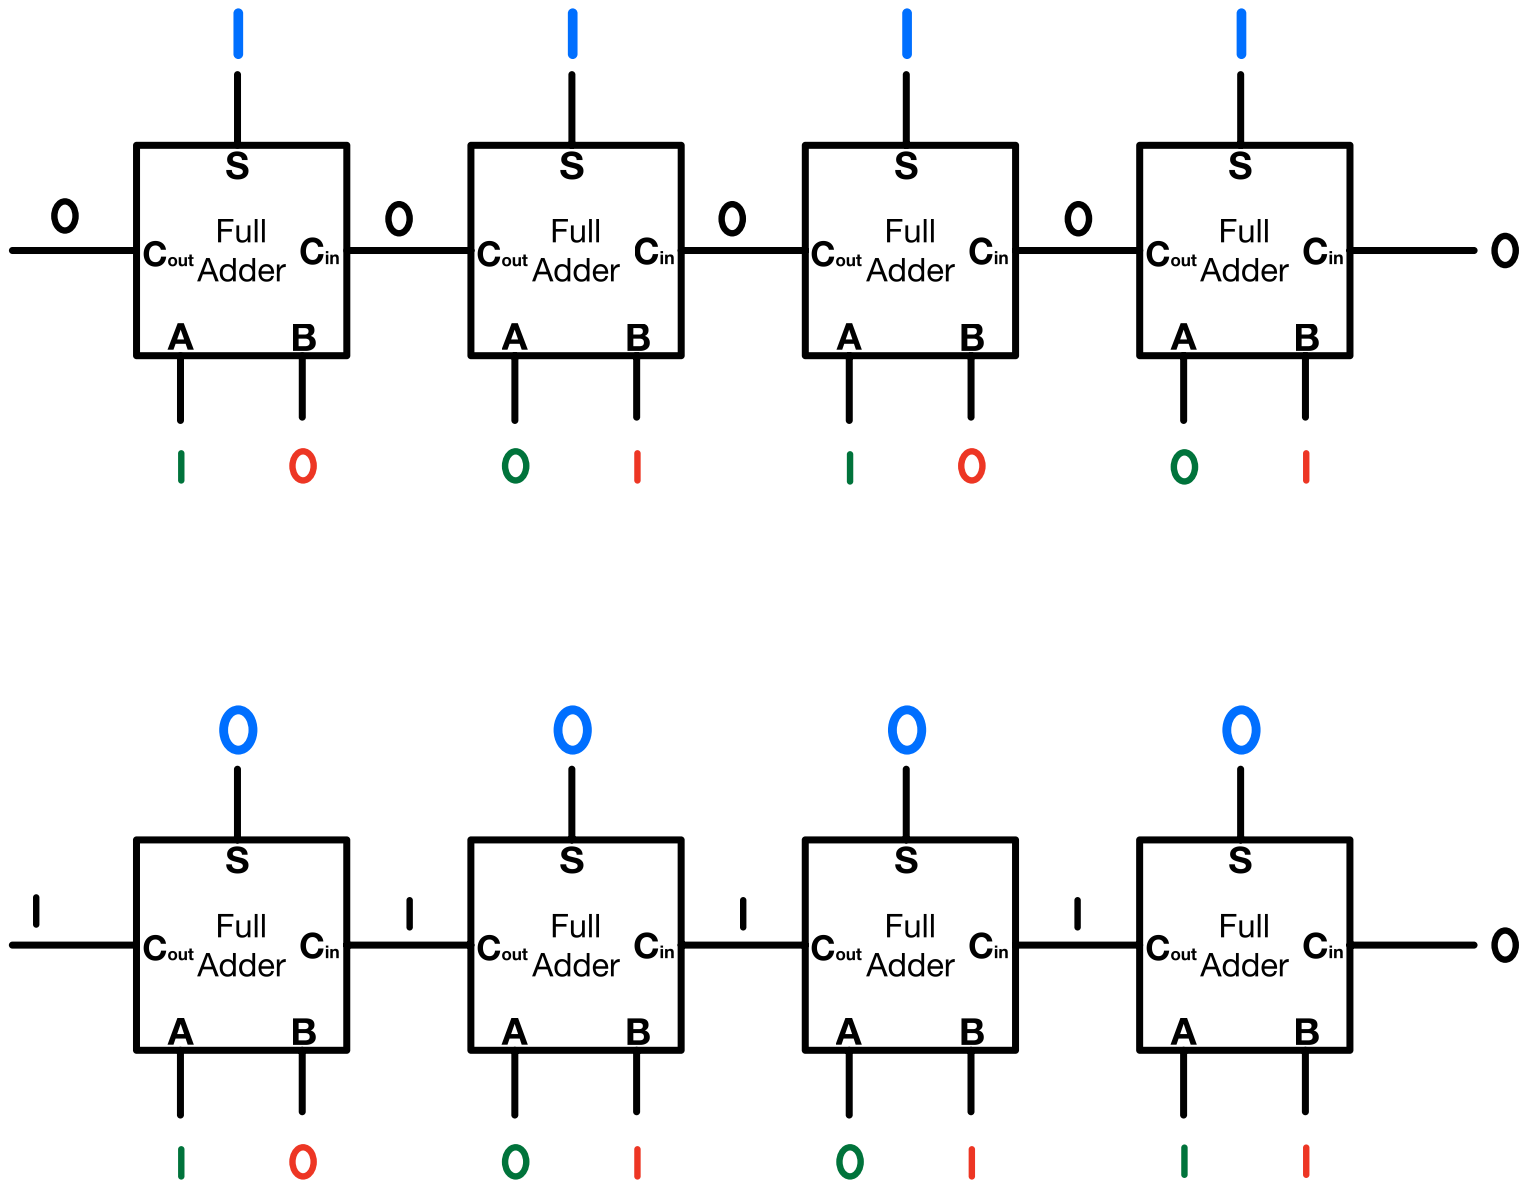
[picture p131: page 4]

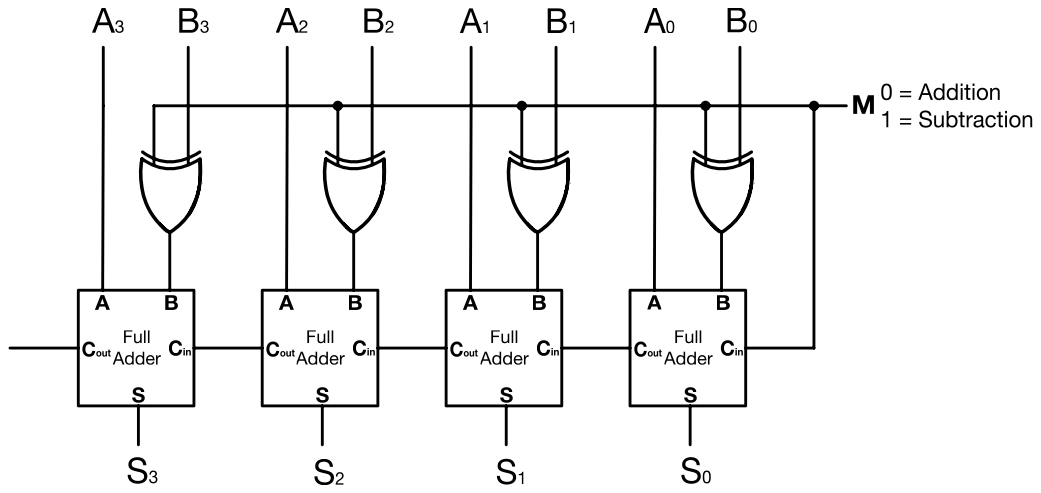
[picture p132: page 5]

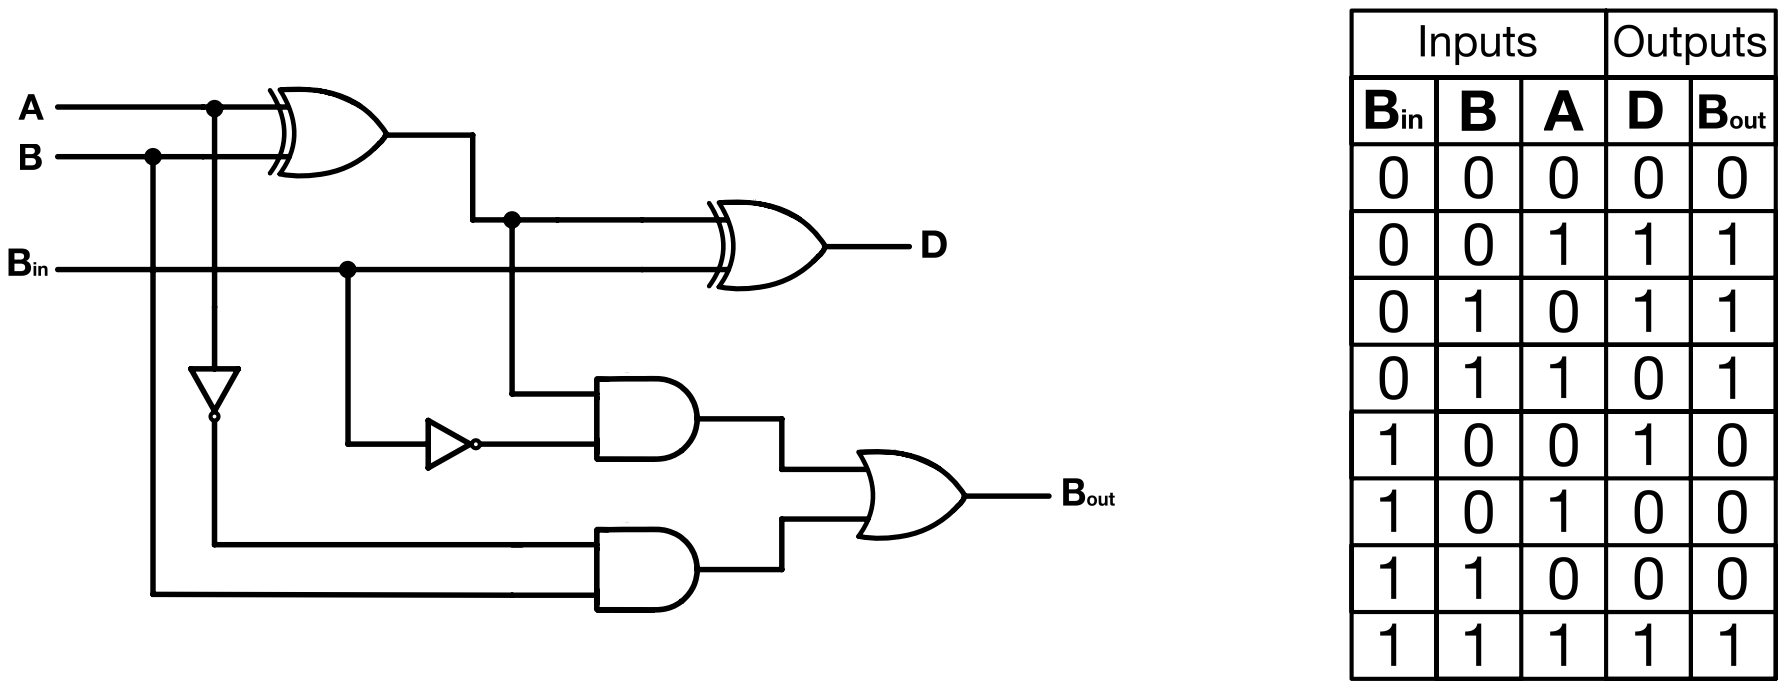
[picture p133: page 6]

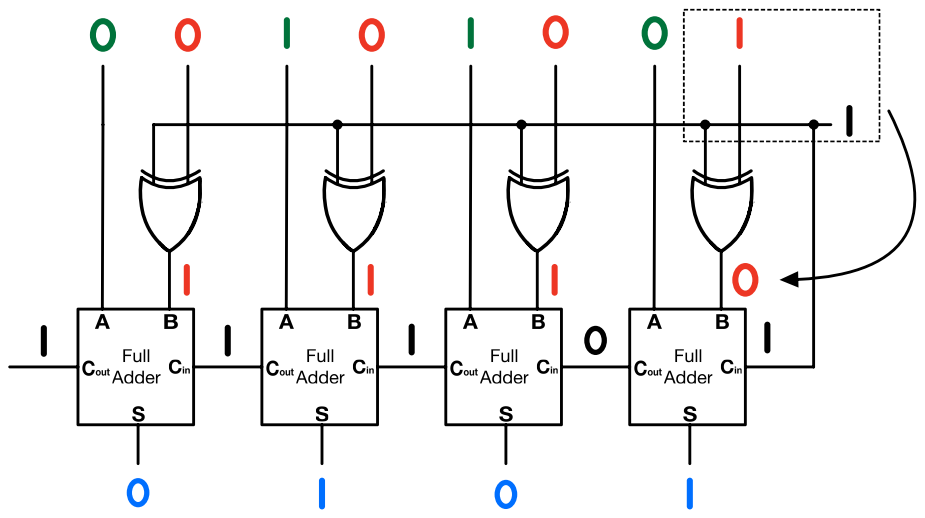
[picture p134: page 7]
