Fadil-1/8-BIT-BREADBOARD-CPU/schematics_and_figures/Control Logic Figures/Control Logic Figures.pdf

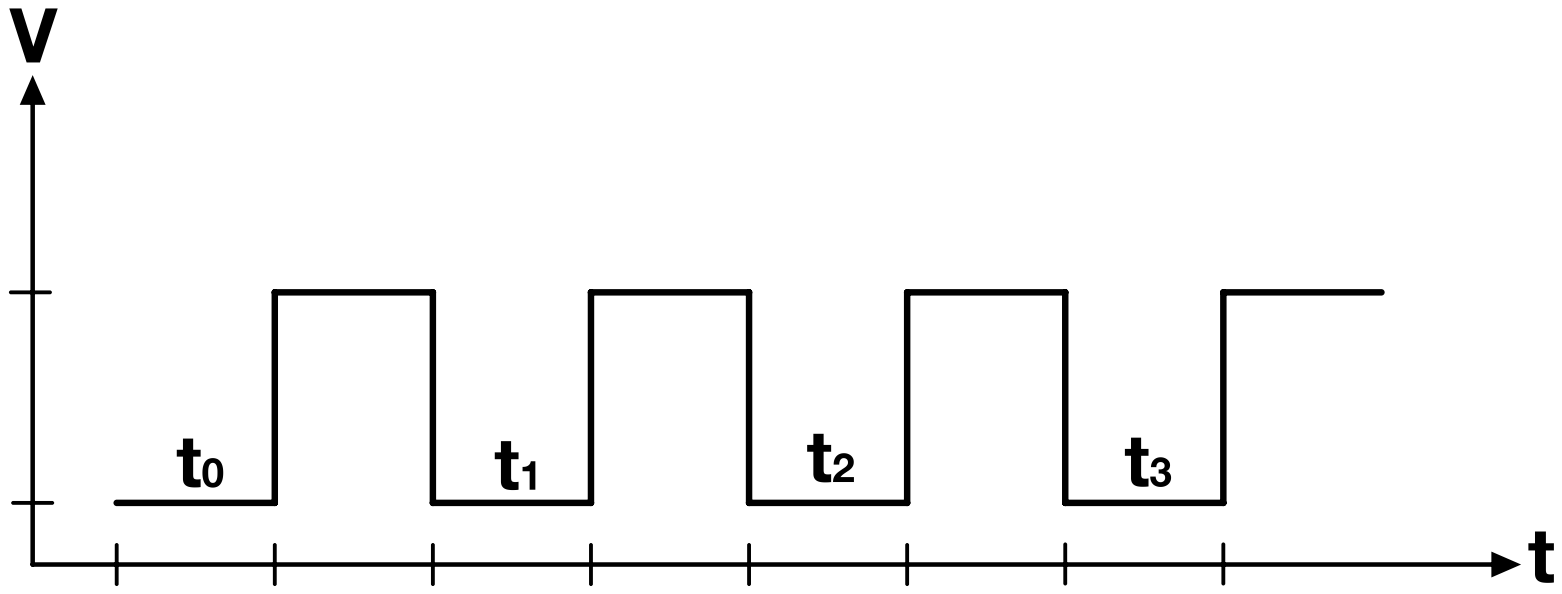
[picture p135: page 1]

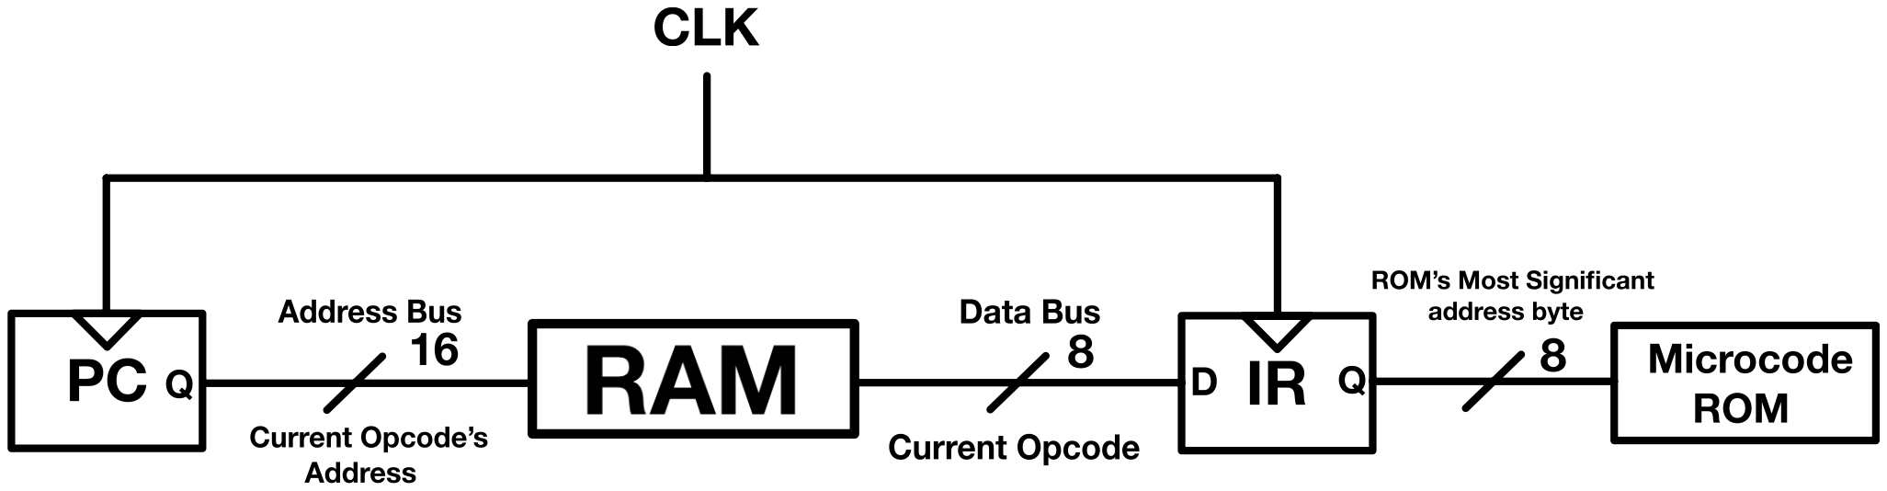
[picture p136: page 2]
