Fadil-1/8-BIT-BREADBOARD-CPU/schematics_and_figures/EEPROM Programmers/EEPROM programmers .pdf

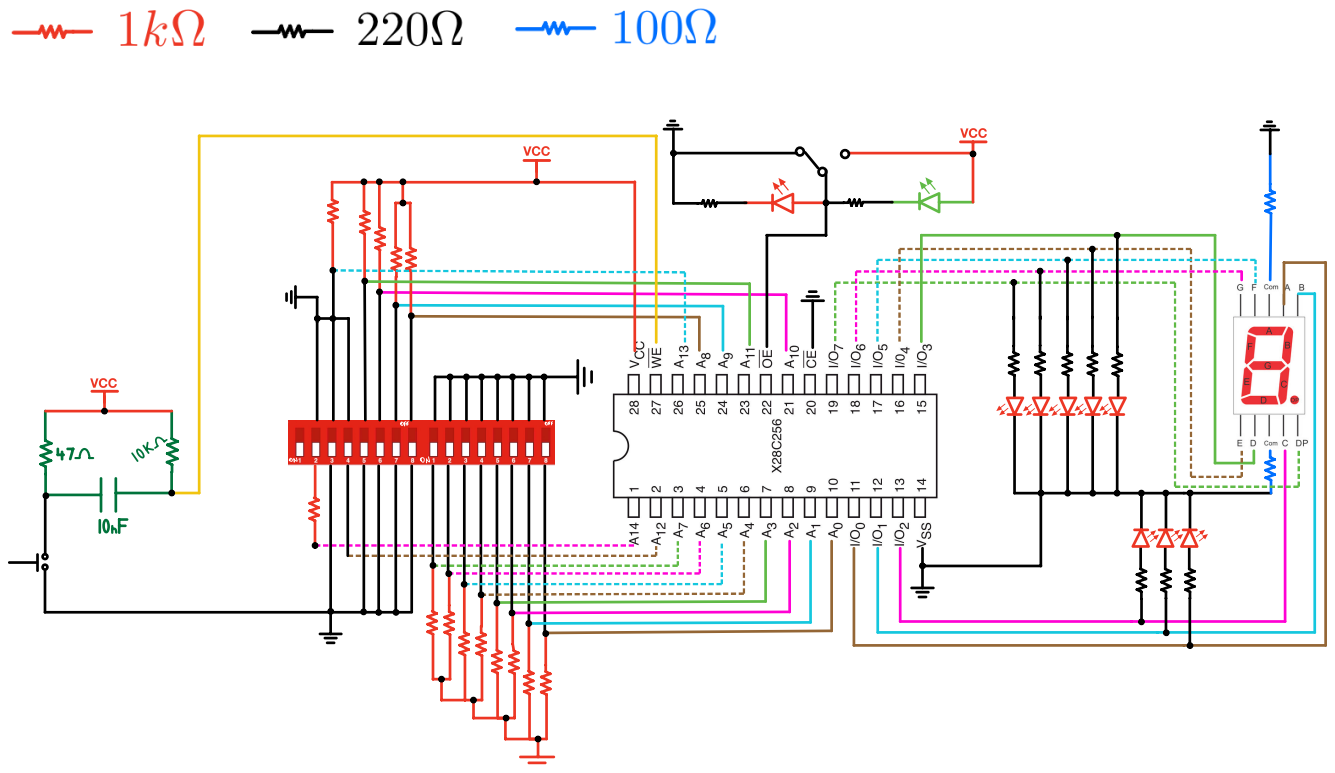
[picture p137: page 1]
OFF

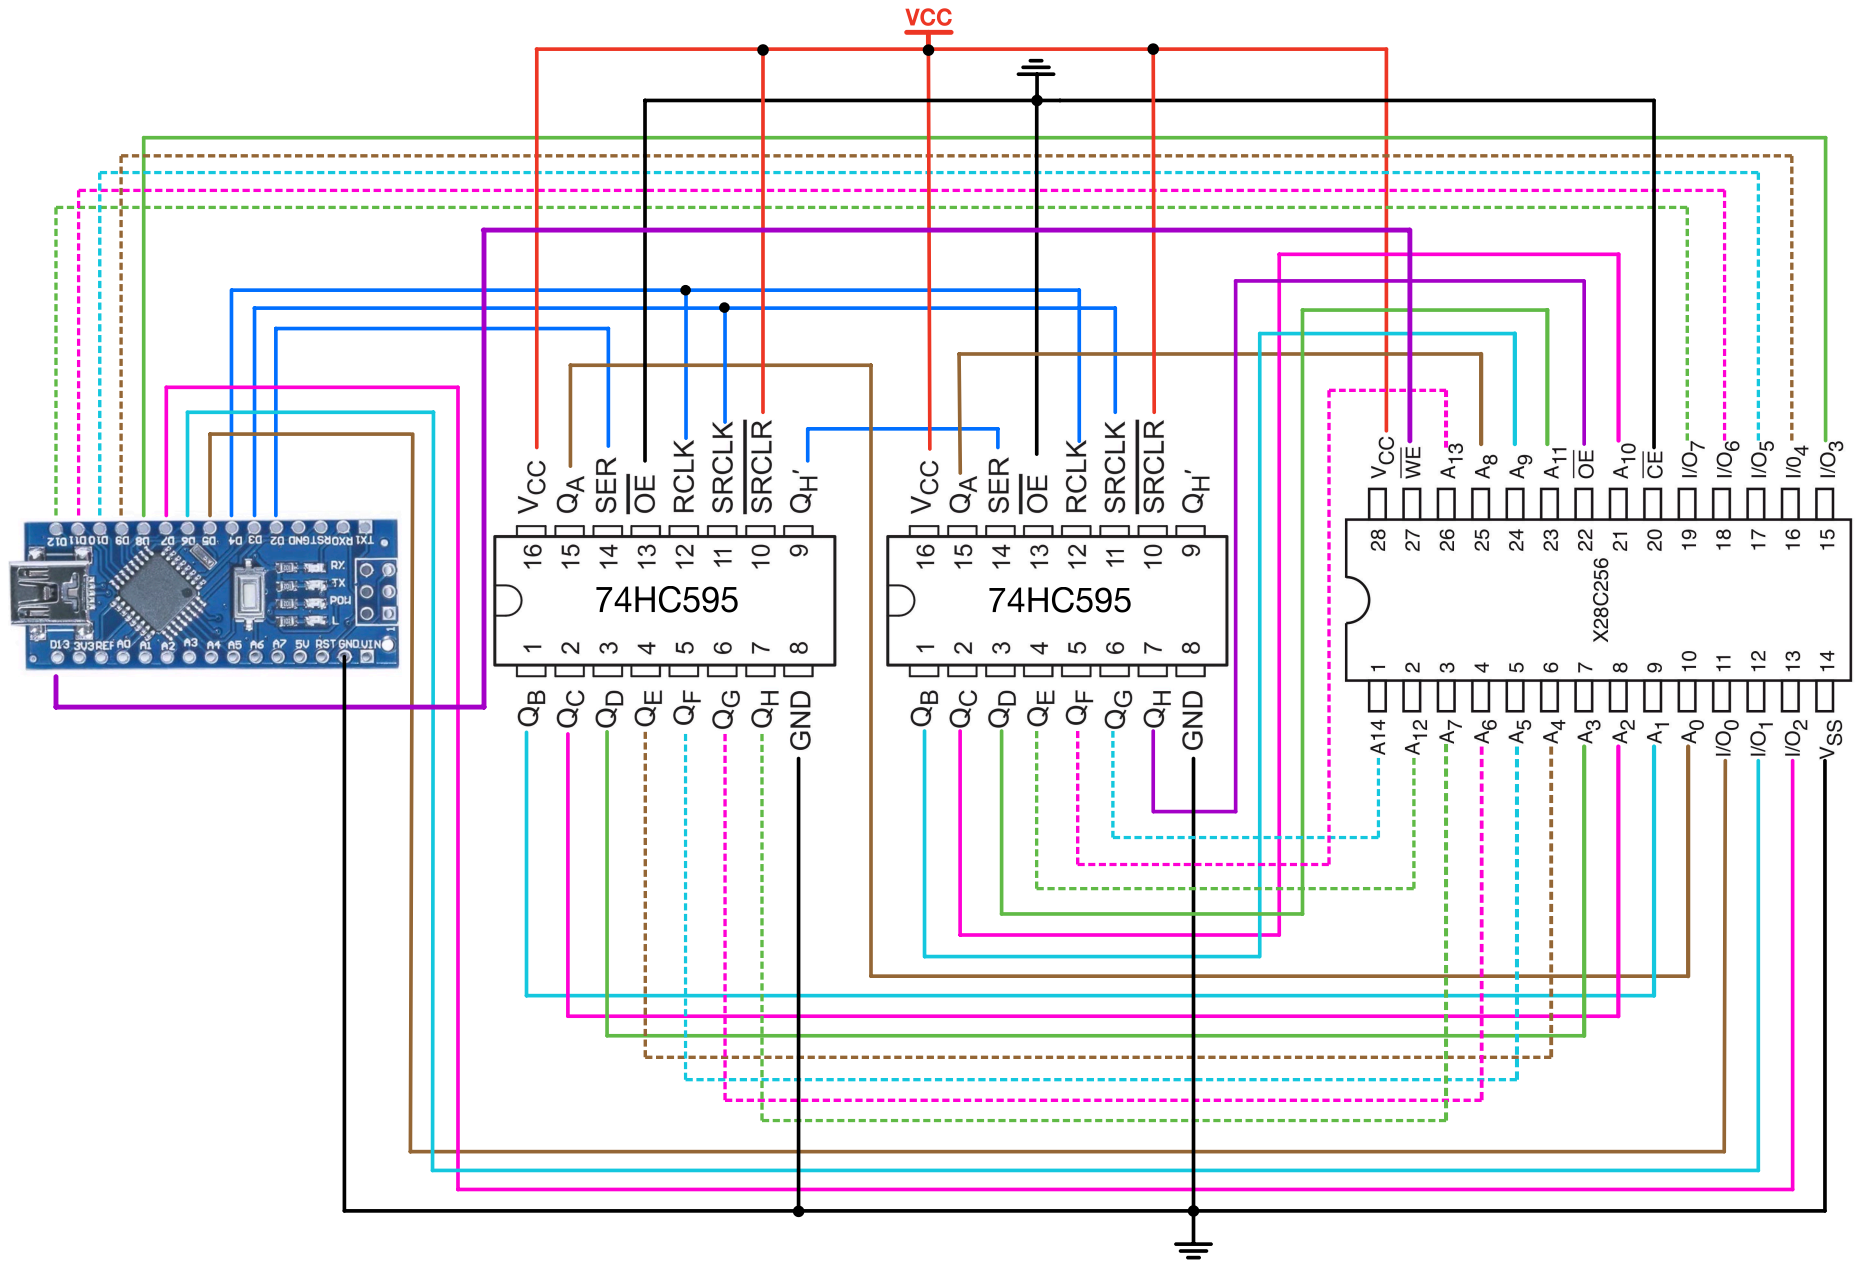
[picture p138: page 2]
