Fadil-1/8-BIT-BREADBOARD-CPU/schematics_and_figures/General Purpose Registers/General purpose Registers.pdf

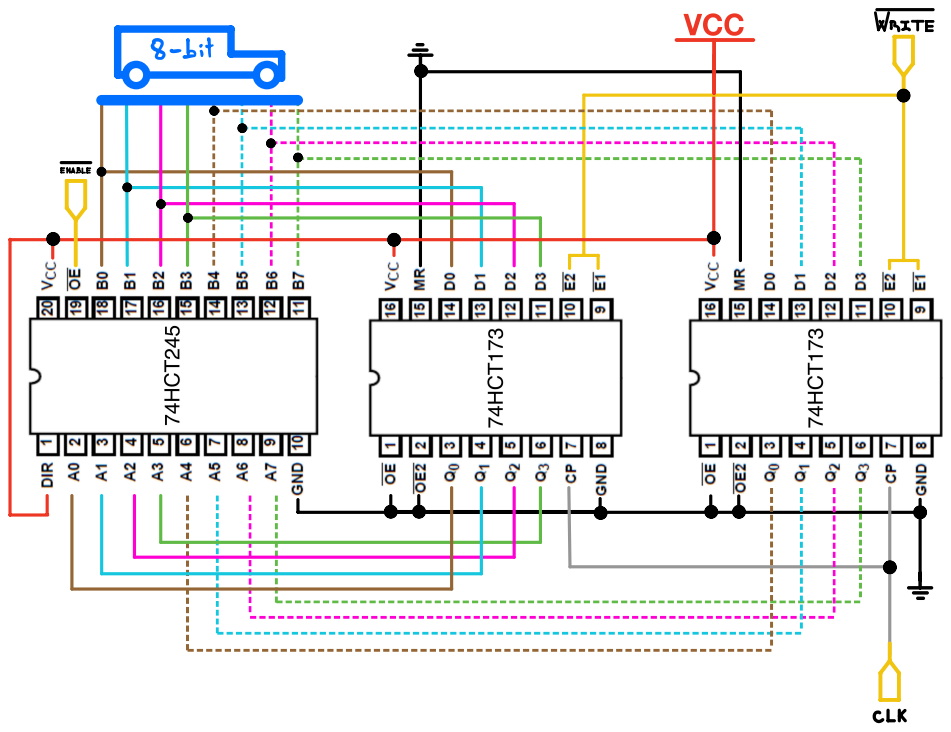
[picture p139: page 1]
8 bit

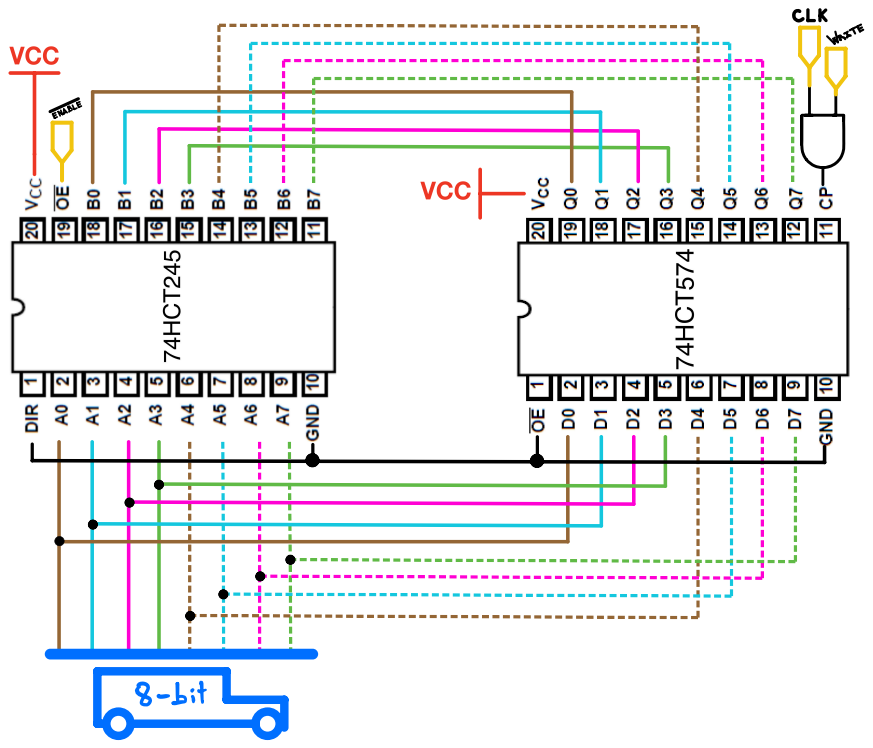
[picture p140: page 2]
8 bit

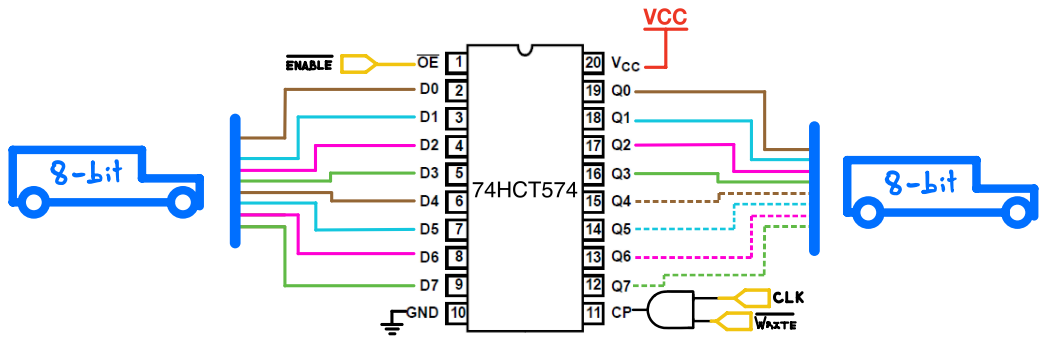
[picture p141: page 3]
8 bit
