Fadil-1/8-BIT-BREADBOARD-CPU/schematics_and_figures/Permanent Clock Figures/Permanent_Clock_figures.pdf

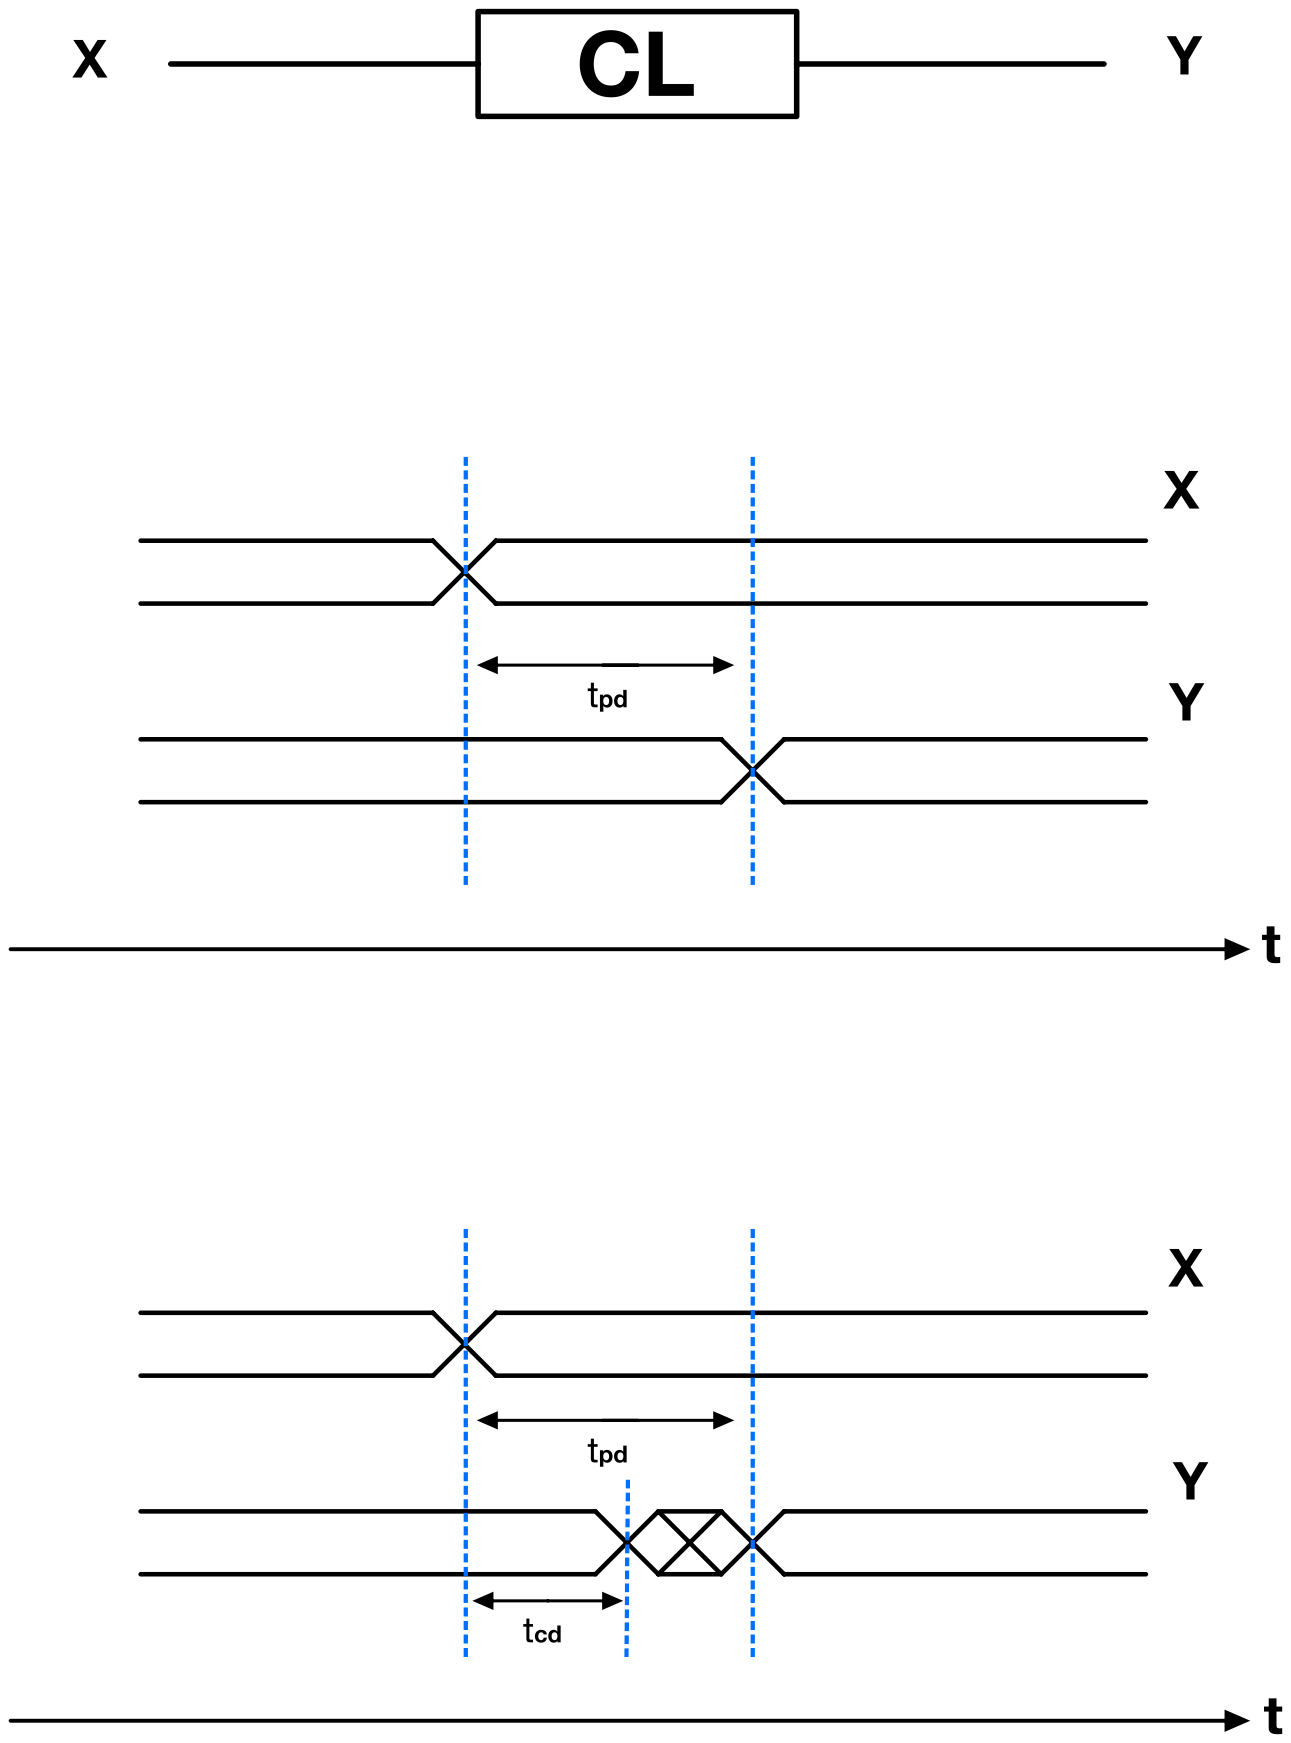
[picture p142: page 1]

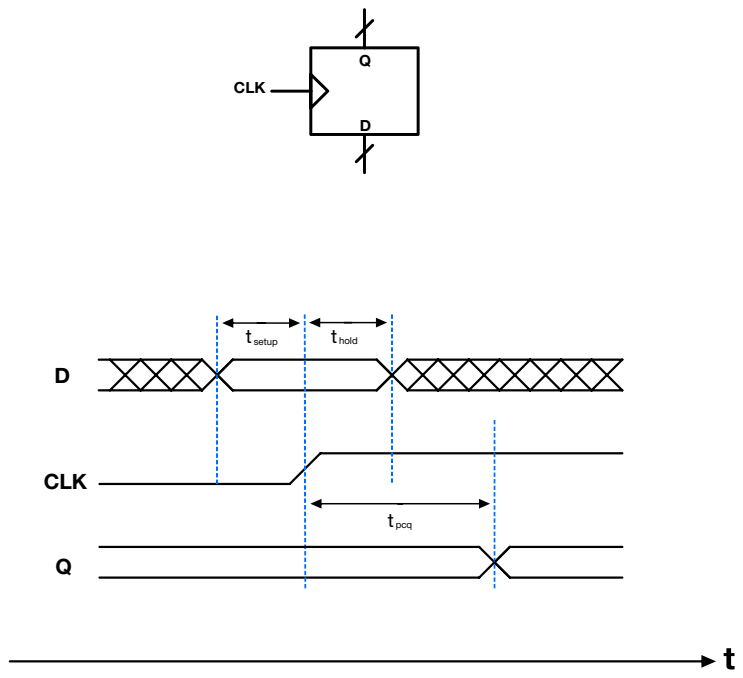
[picture p143: page 2]
CLK; t setup; t hold; pcq

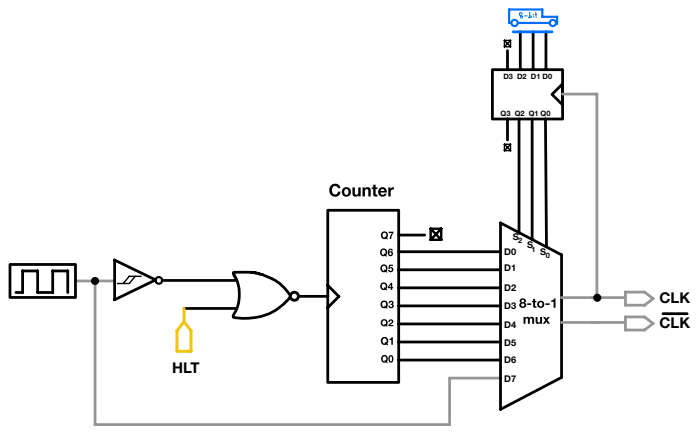
[picture p144: page 3]

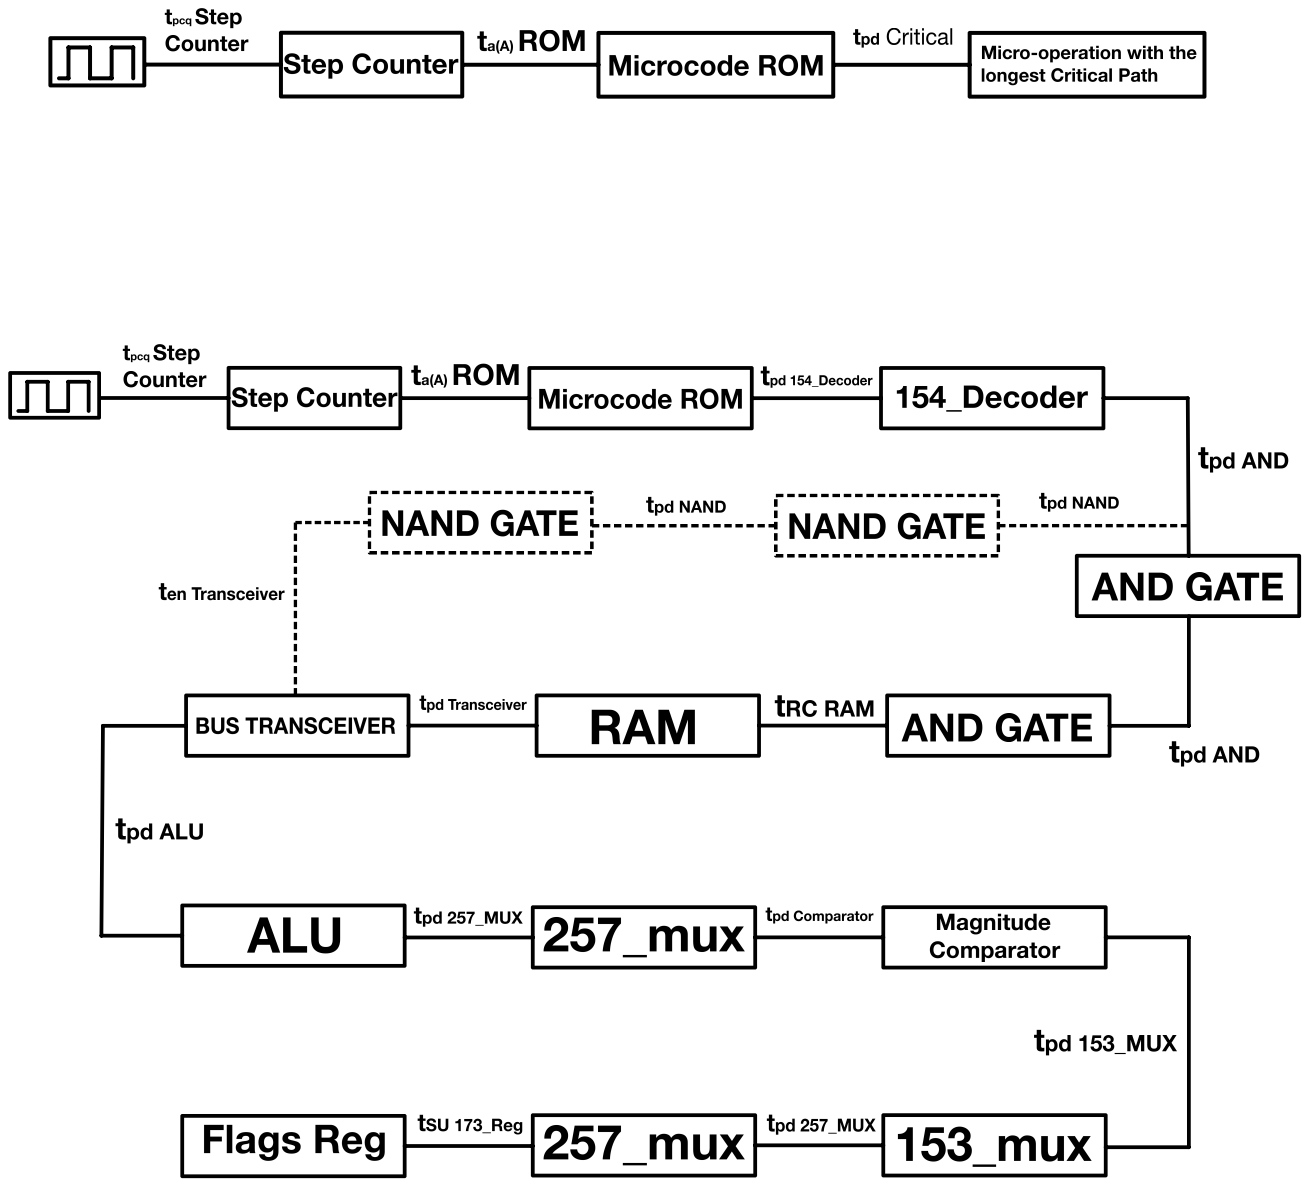
[picture p145: page 4]

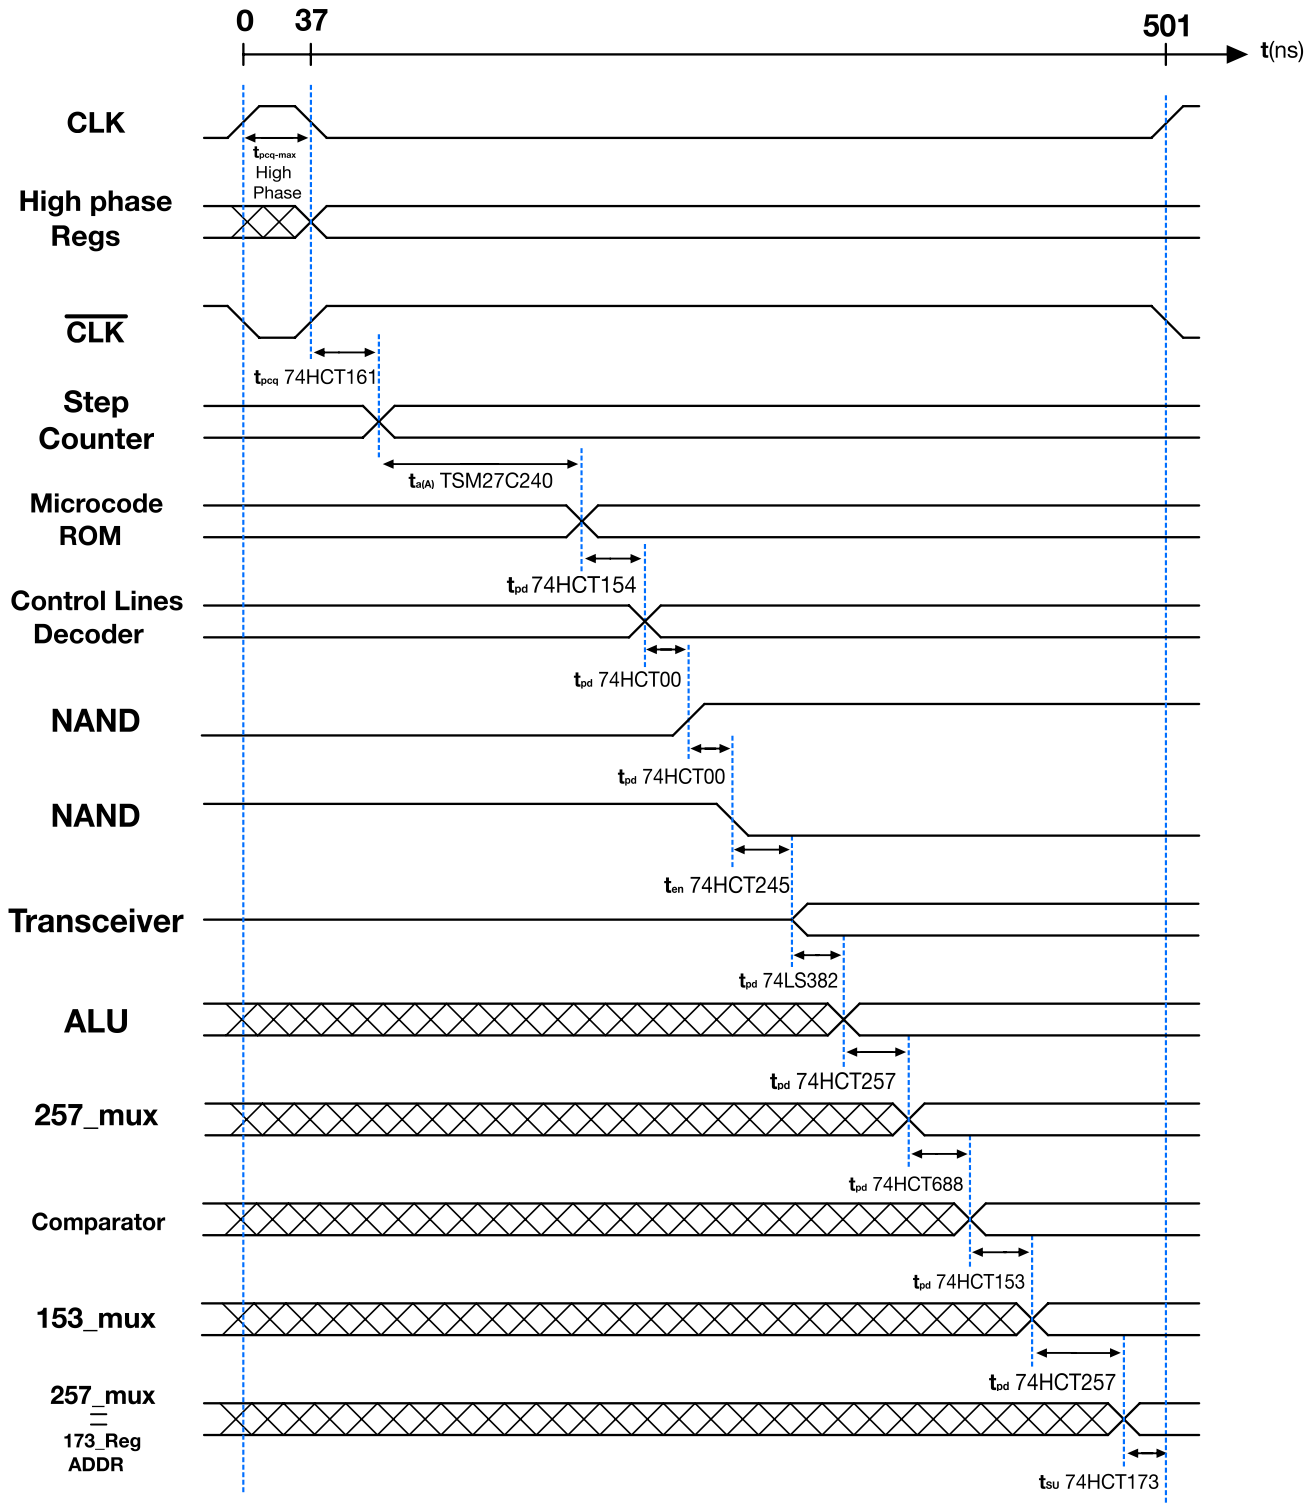
[picture p146: page 5]
