Fadil-1/8-BIT-BREADBOARD-CPU/schematics_and_figures/Permanent Clock/Permanent Clock.pdf

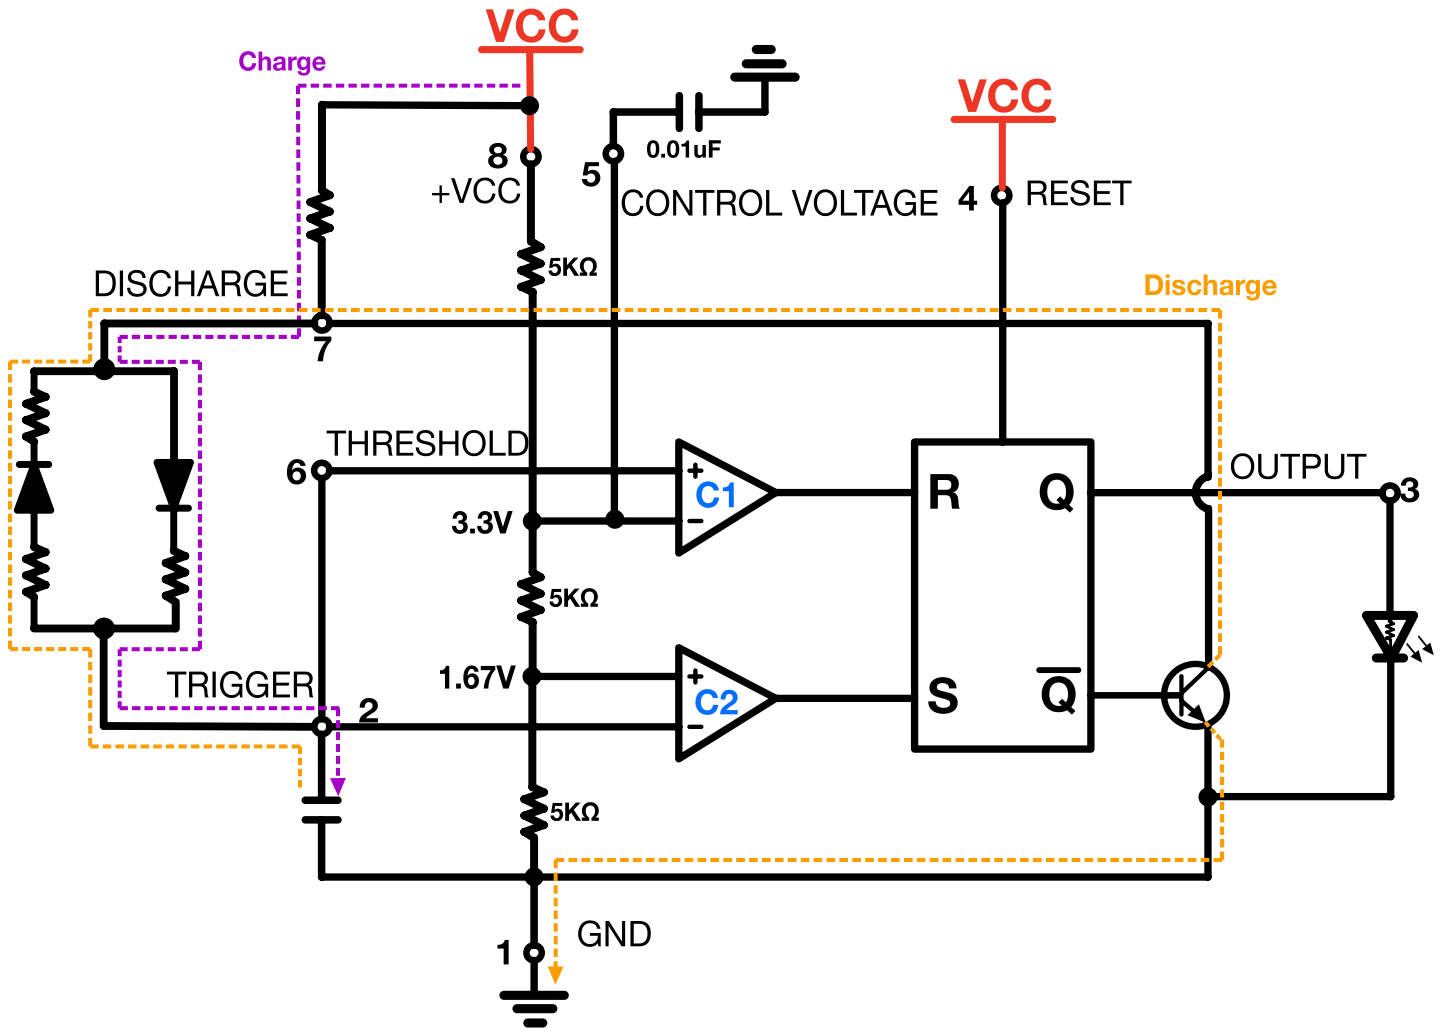
[picture p147: page 1]

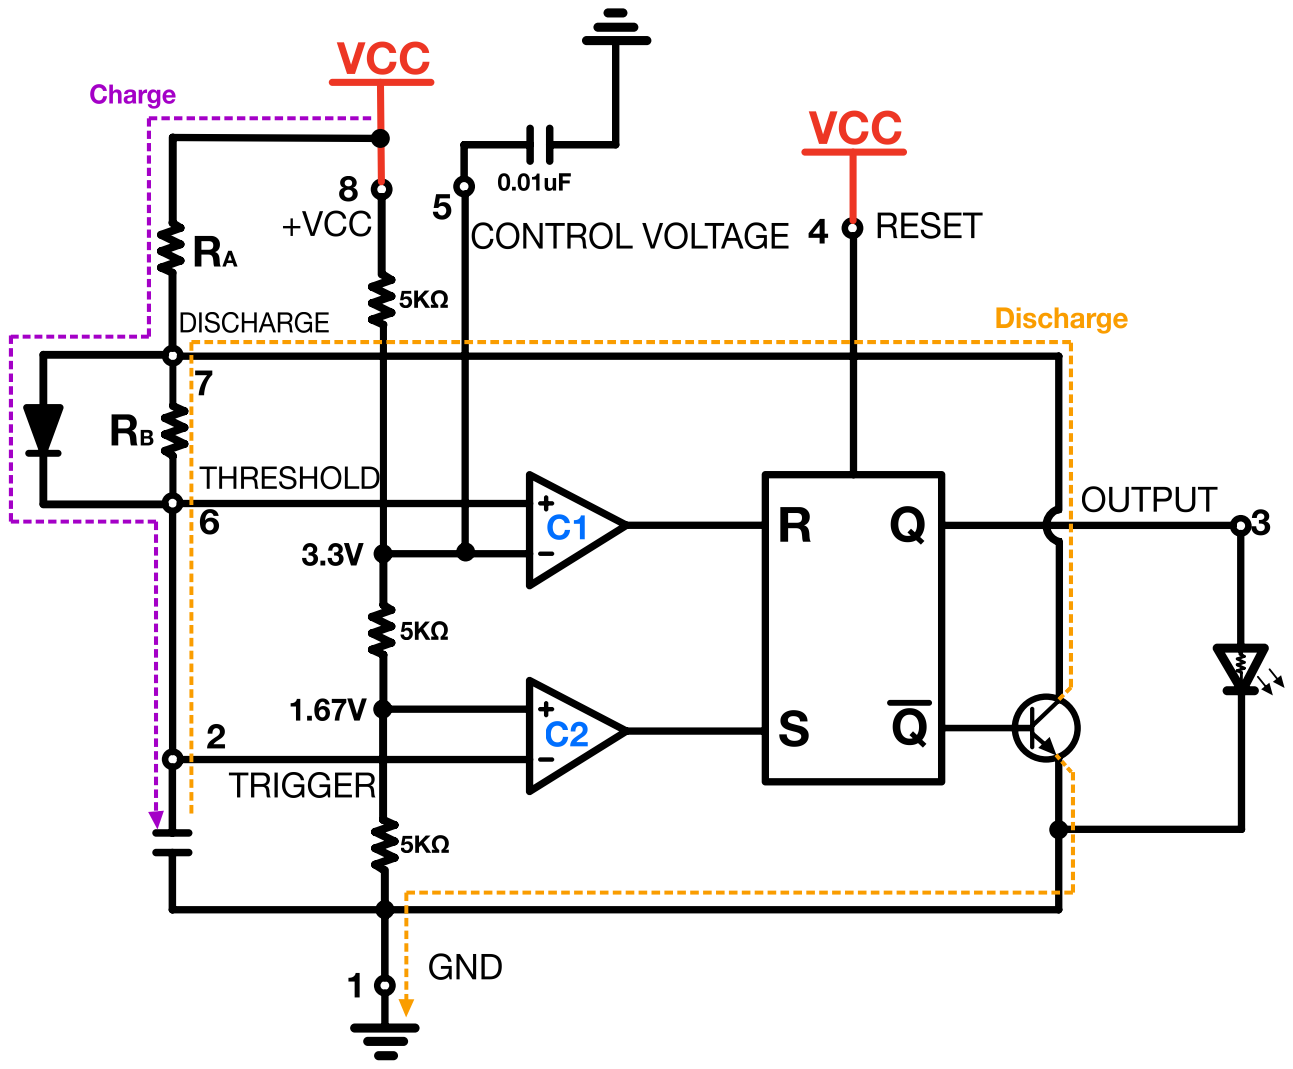
[picture p148: page 2]

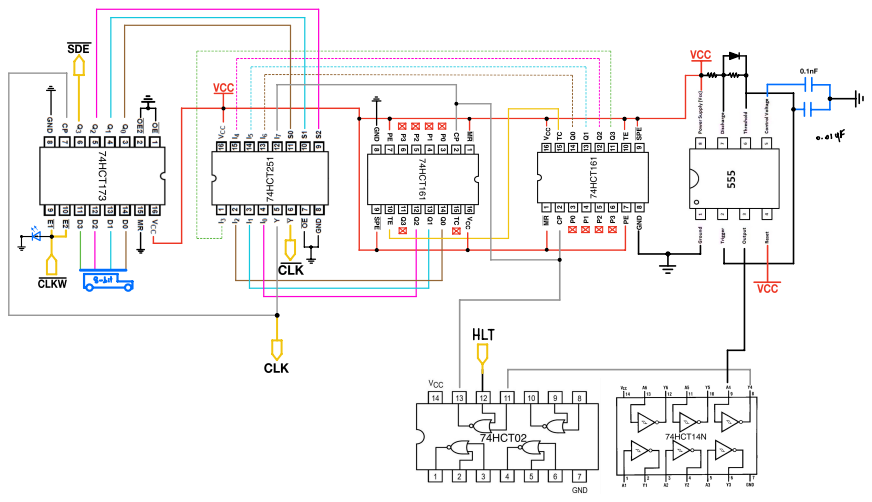
[picture p149: page 3]
