Fadil-1/8-BIT-BREADBOARD-CPU/schematics_and_figures/Program Counter Figures/Program_Counter_Figures.pdf

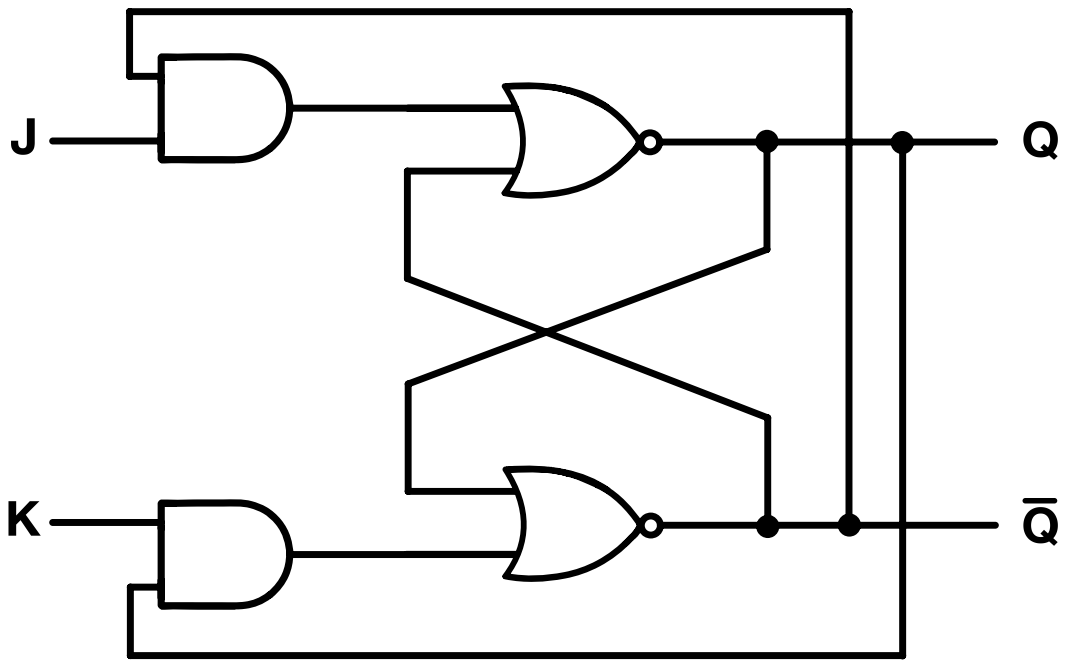
[picture p150: page 1]

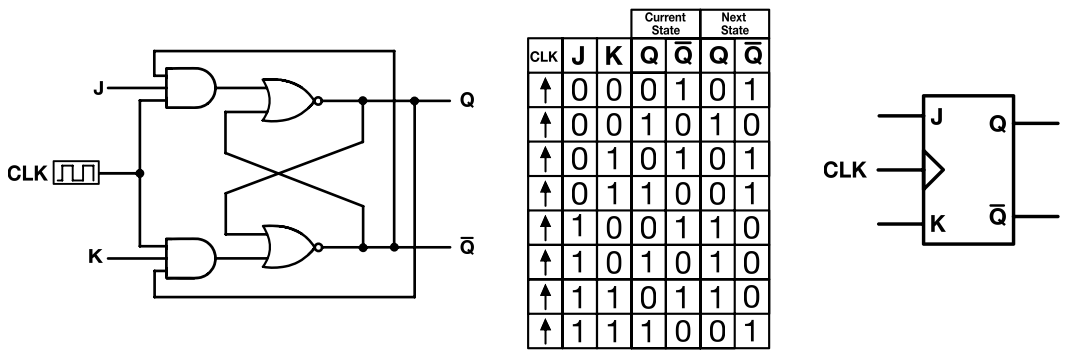
[picture p151: page 2]

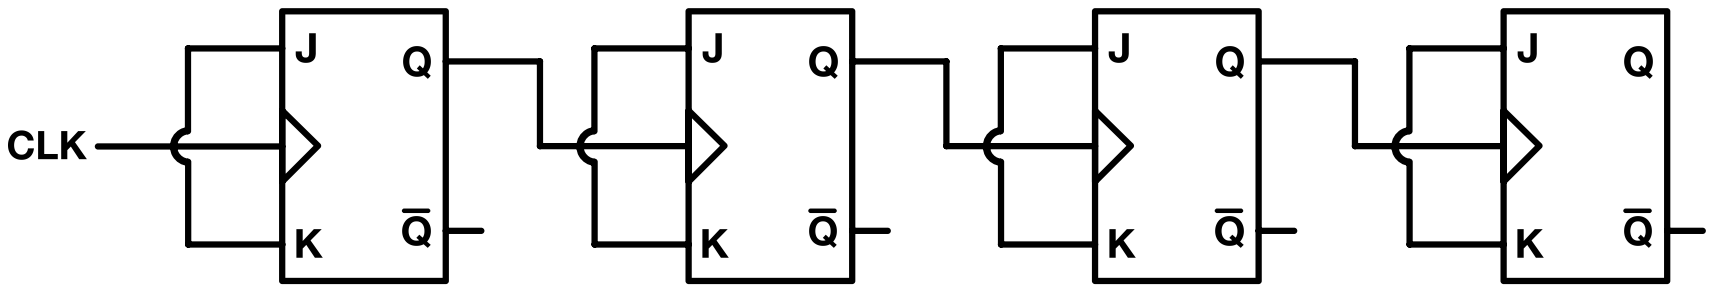
[picture p152: page 3]
