Fadil-1/8-BIT-BREADBOARD-CPU/schematics_and_figures/Program Counter/PROGRAM COUNTER.pdf

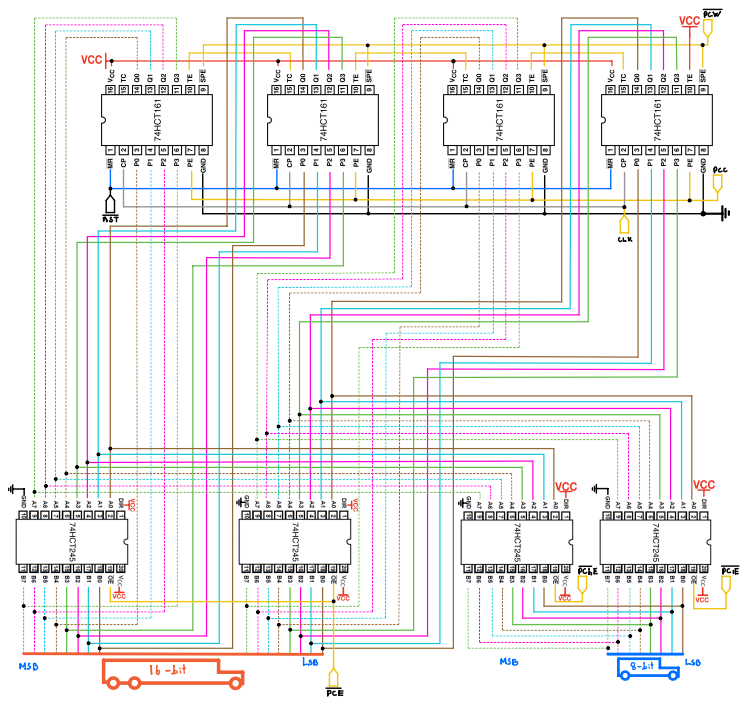
[picture p153: page 1]
PCW; Pcc; CLK; PChE; MSB; LSB
