Fadil-1/8-BIT-BREADBOARD-CPU/schematics_and_figures/RAM/RAM.pdf

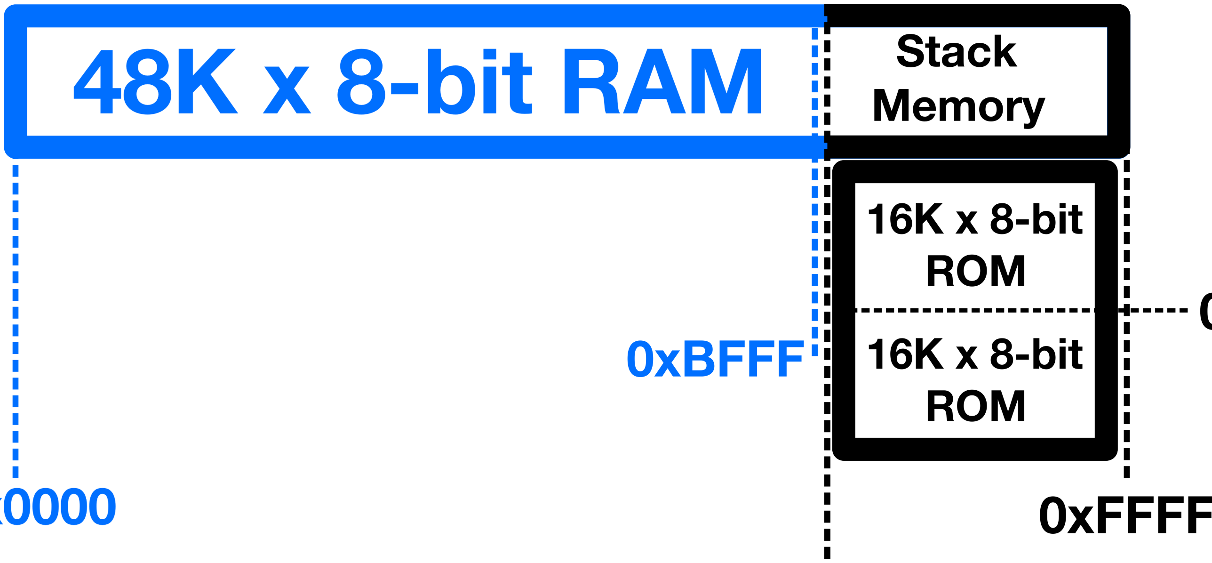
[picture p154: figure]
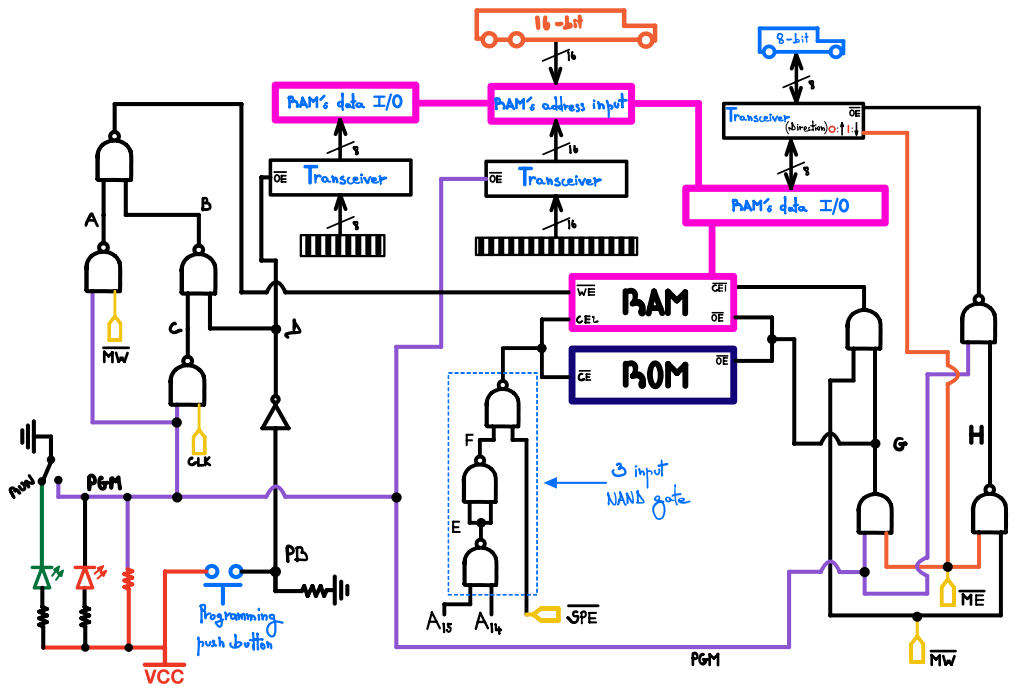
[picture p155: page 2]
13 s data; s address input; transceiverdirection; transceiver; s data; T.EET; 3 input MON; PGM; NANDgate; t.isT; Programming; pushbutton

as | 3
1k« | 220«

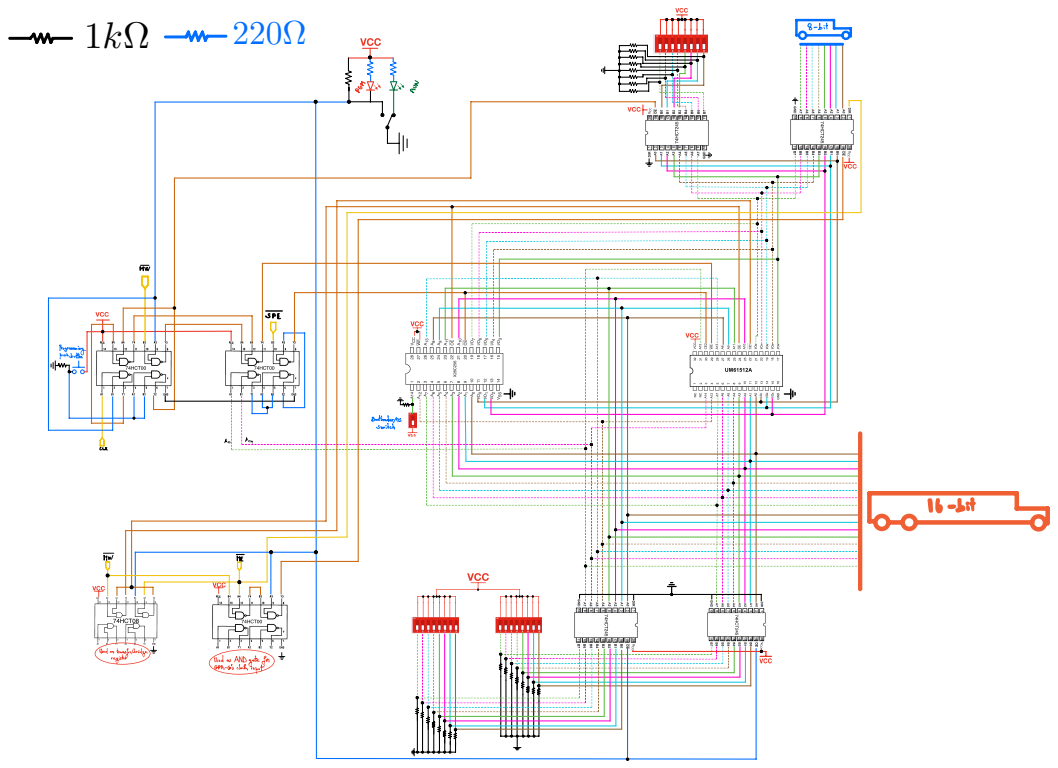
[picture p156: page 3]
SPE; Fiii; can; used; bridge; sd.inf.f
