Fadil-1/8-BIT-BREADBOARD-CPU/schematics_and_figures/Segmented Display Figures/Segmented_Display _Figures.pdf

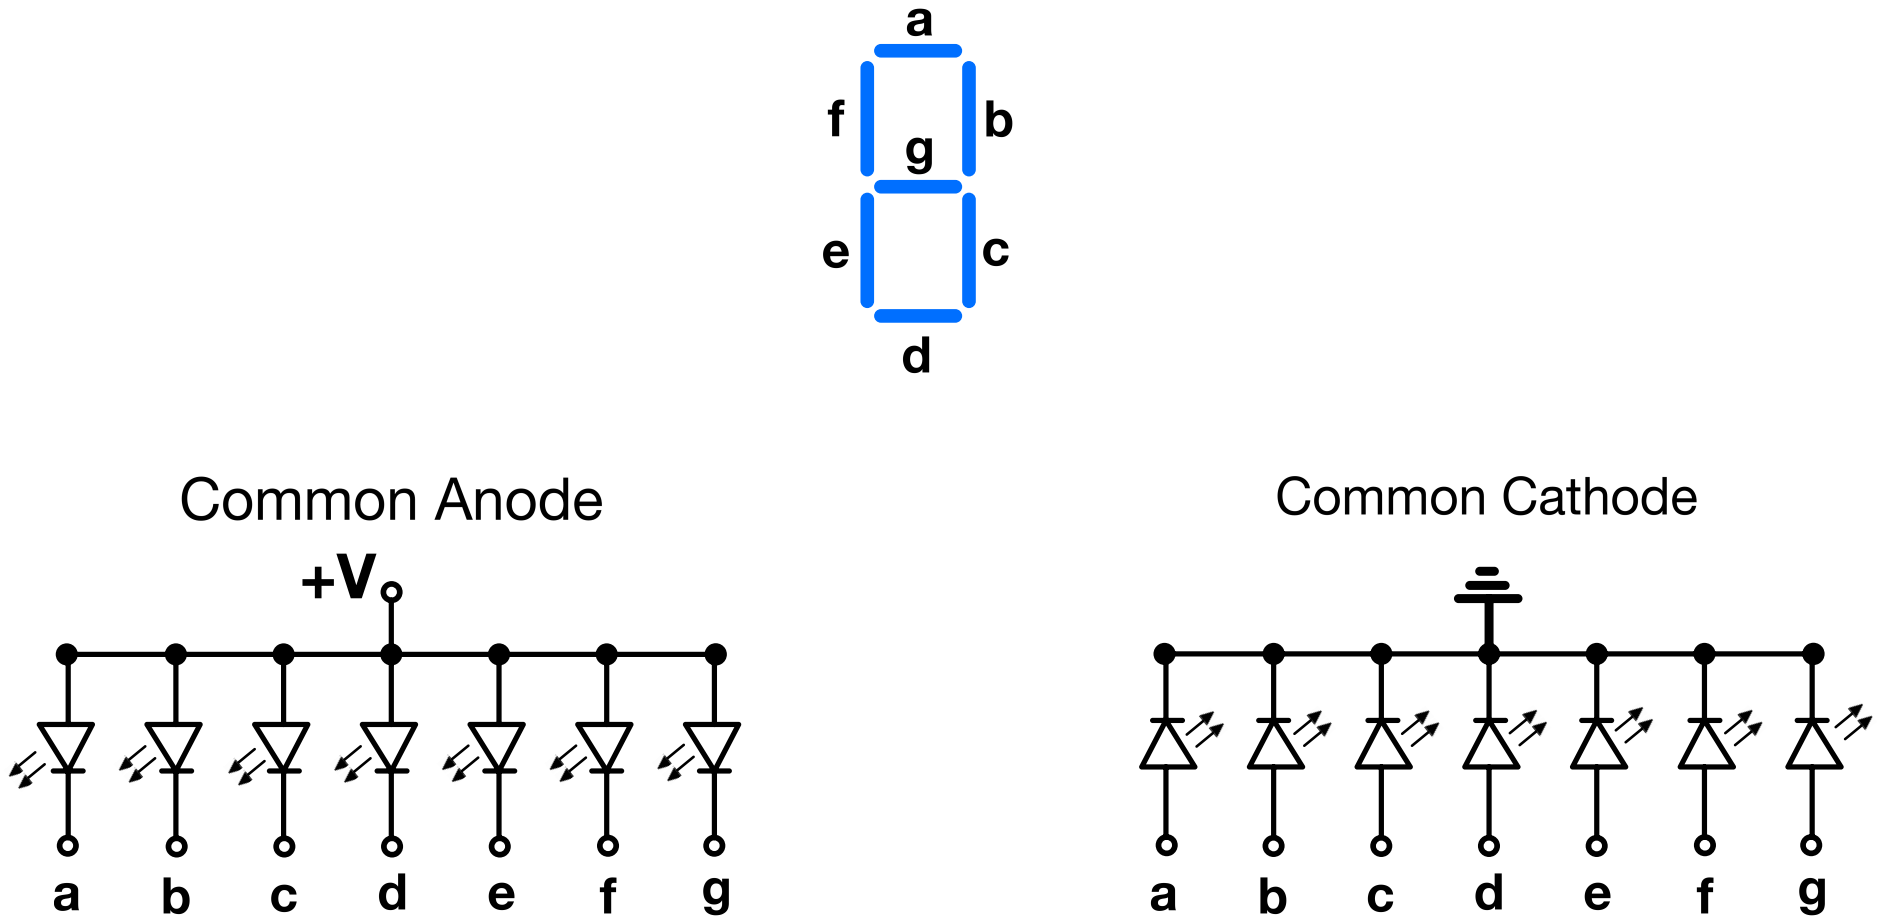
[picture p157: page 1]

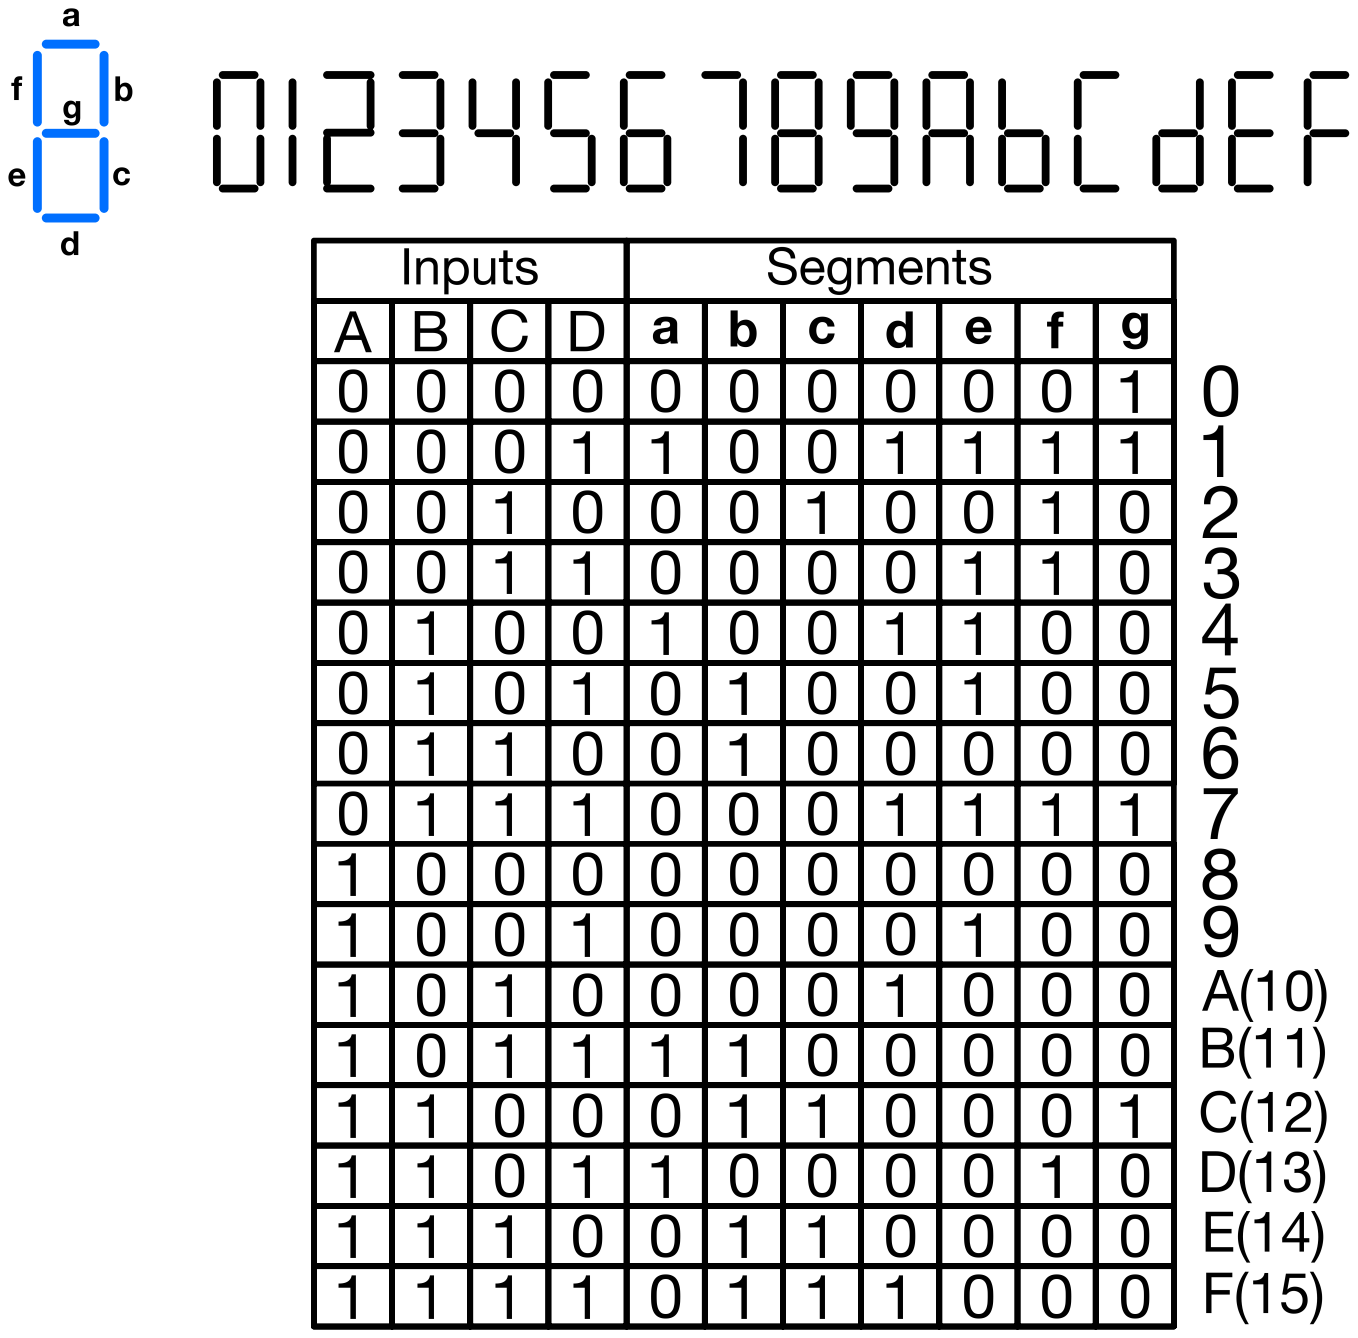
[picture p158: page 2]
