Fadil-1/8-BIT-BREADBOARD-CPU/schematics_and_figures/Segmented Display/Segmented Display.pdf

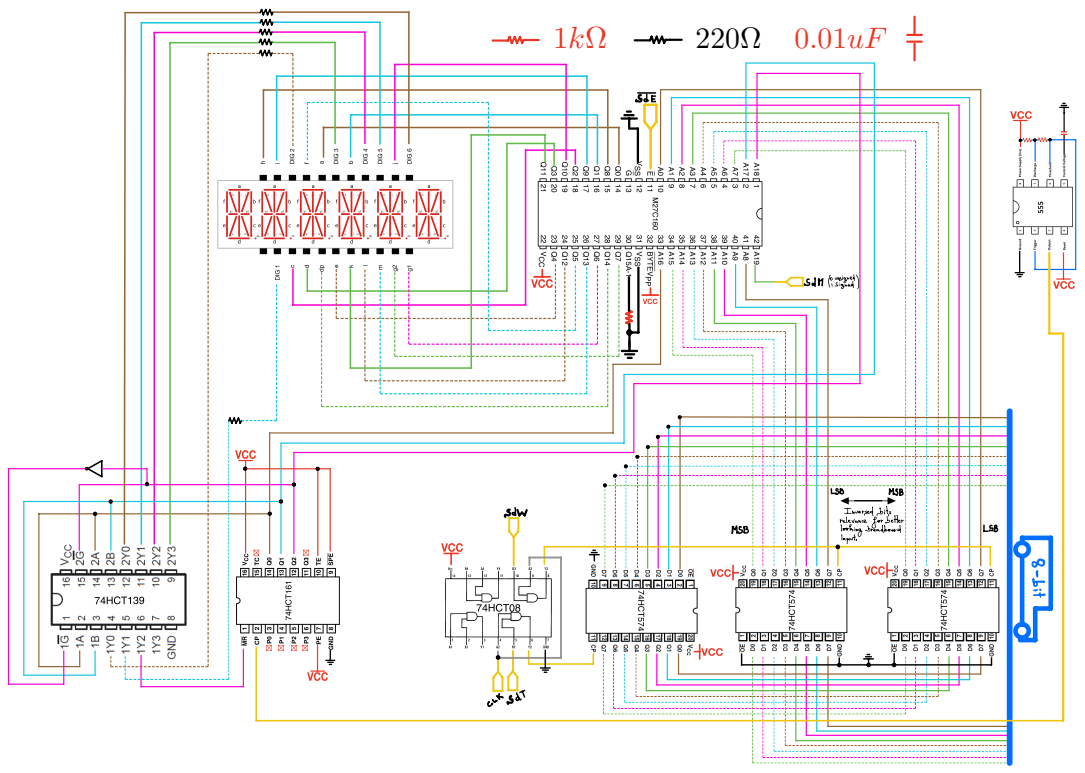
[picture p159: page 1]
LSB; MSB; atsd

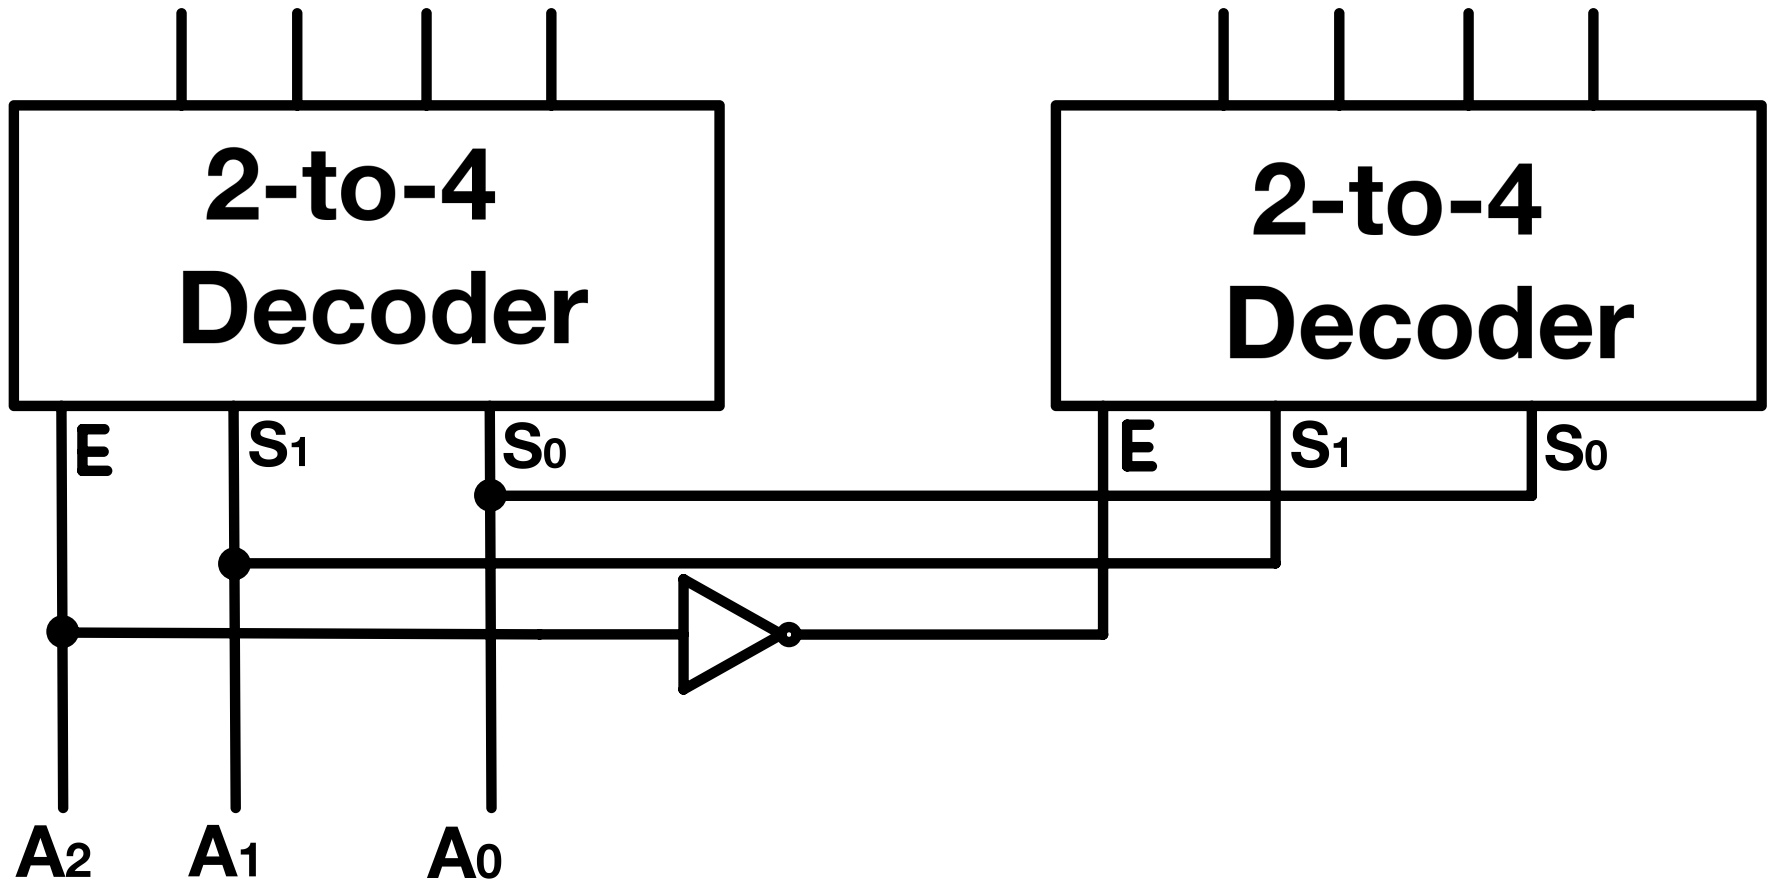
[picture p160: page 2]

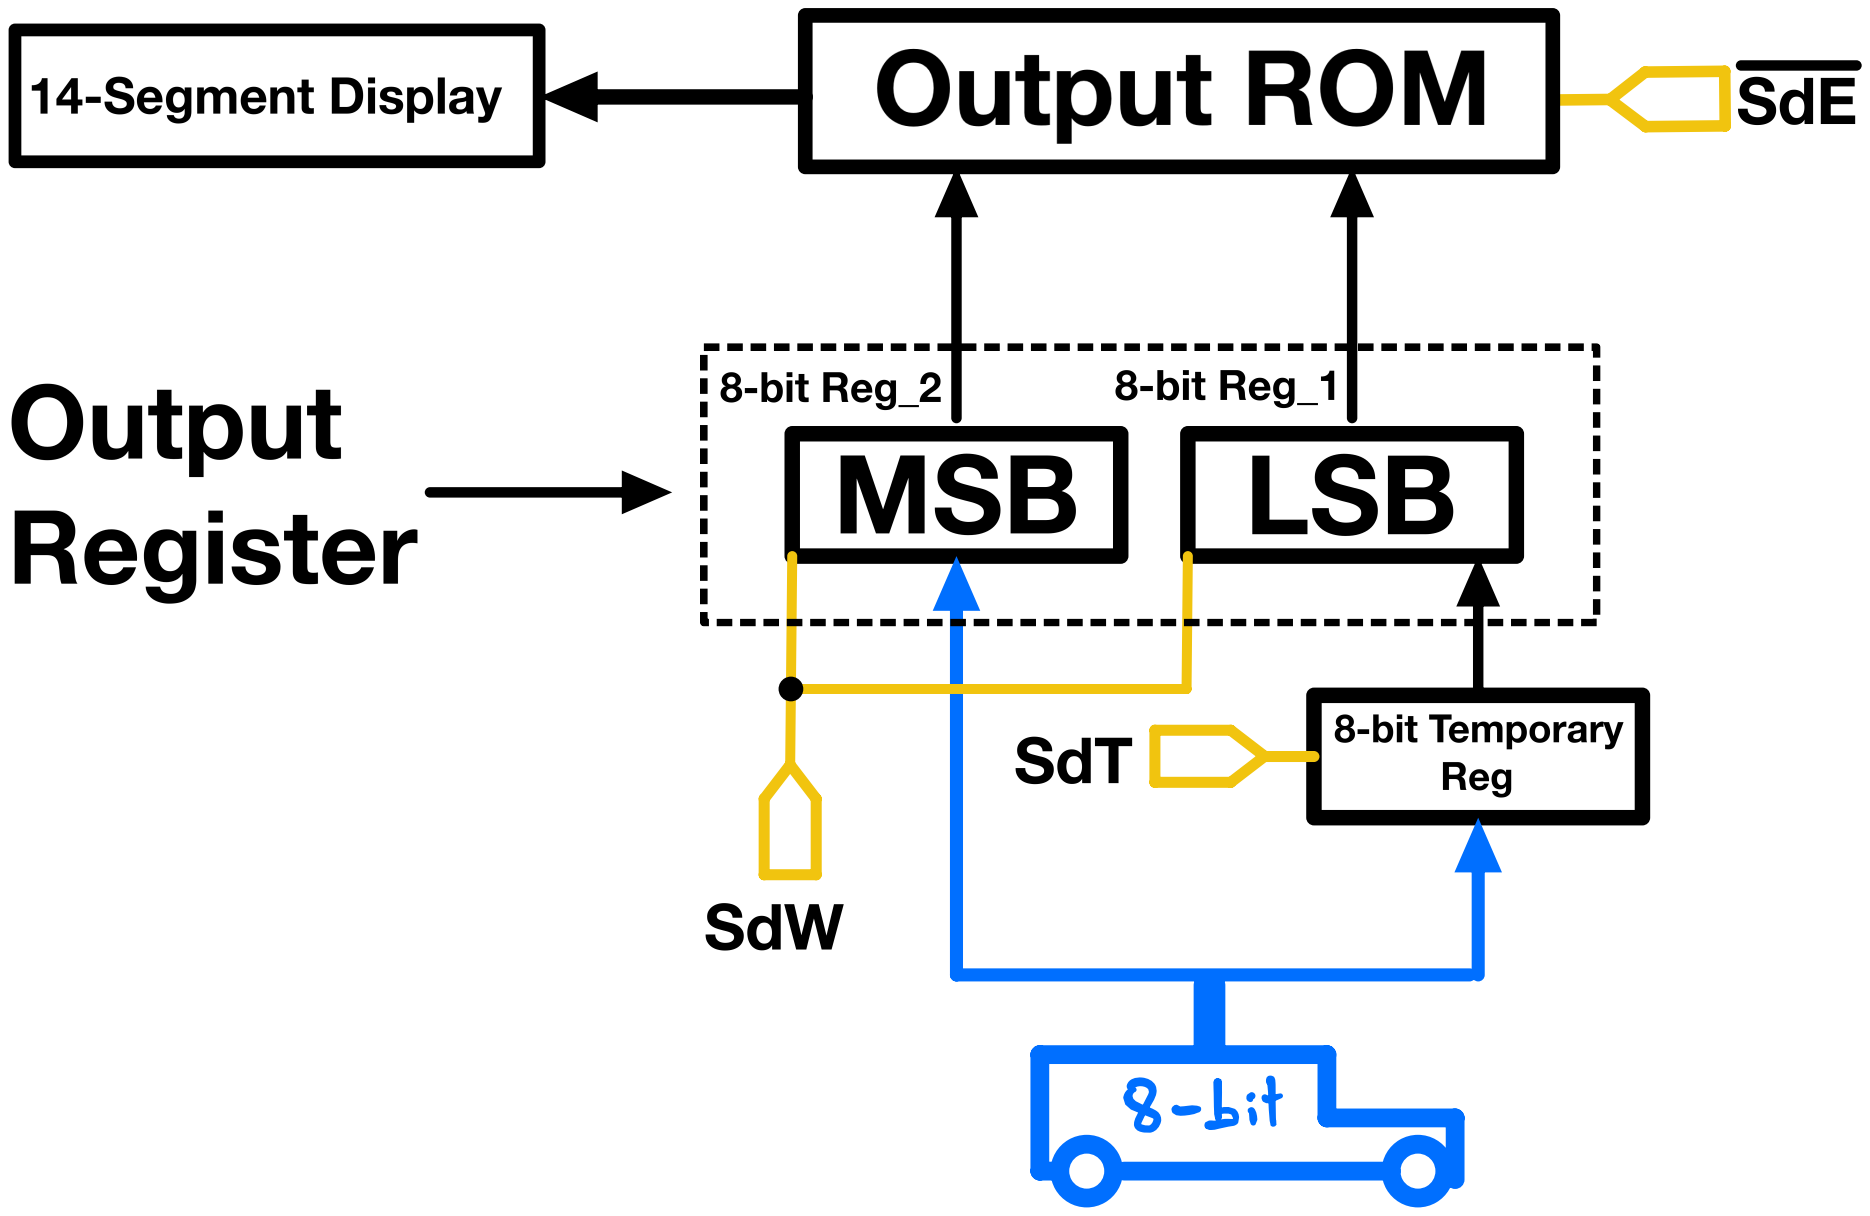
[picture p161: page 3]
