Fadil-1/8-BIT-BREADBOARD-CPU/schematics_and_figures/Stack Pointer/Stack Pointer.pdf

## SPW

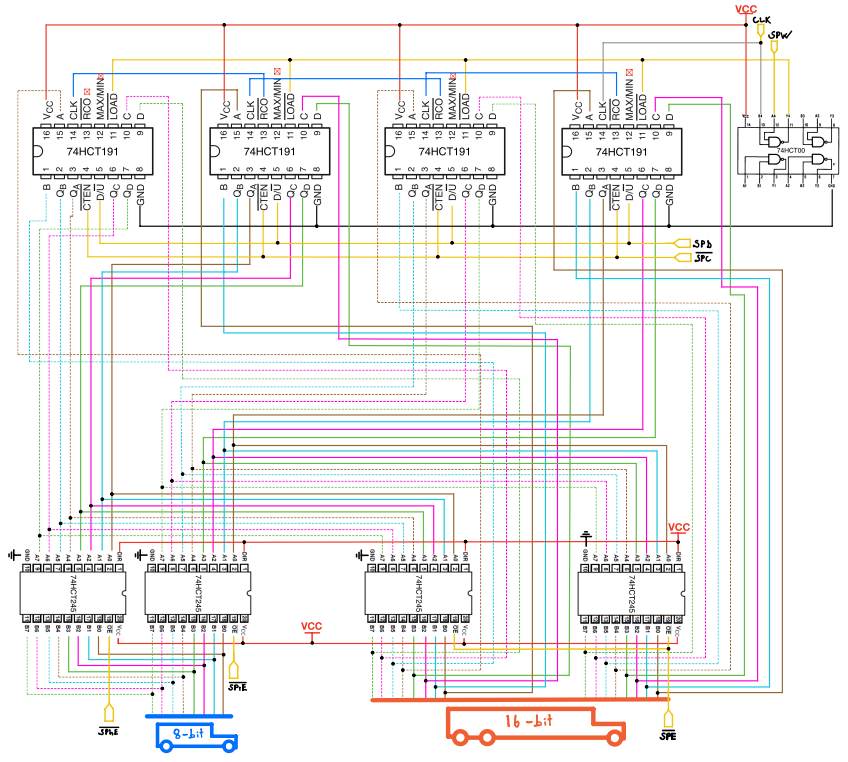
[picture p162: page 1]
SPIE; SPHE
