Fadil-1/8-BIT-BREADBOARD-CPU/schematics_and_figures/Transfer Register/Transfer Register.pdf

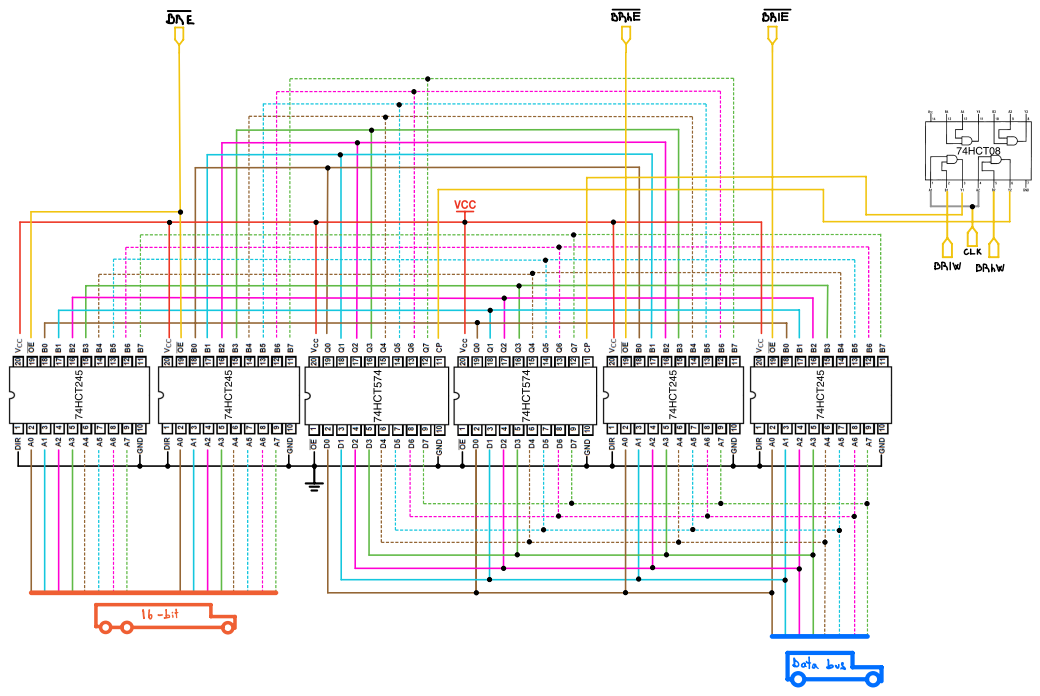
[picture p163: page 1]
BRE; BBA
