Fadil-1/8-BIT-BREADBOARD-CPU/(commit log)

2023-06-19 Switched images links from Drive to GitHub repo
2023-06-20 Added Schematics
2024-10-07 Added hexcomma_to_bin convenience script. Updated convenience scripts' readme. Regenerated ruledef file for current microcode(Previous ruledef wasn't up-to date). Generated new OLED.txt(OLED.asm was 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
2026-05-01 Move and update microcode generator
    Moves the microcode generator into tools/microcode, gives it stable output paths, and regenerates ruledef, instruction documentation, and microcode ROM binaries.
    Updates the current microcode source with stack initialization, RTS return-address handling, shift-register sequencing, and OLED enable polarity fixes.
    Corrects the OLED enable control line so OE is treated as an active-high signal rather than an active-low line.
2026-05-01 Add deployment tools
    Adds scripts to assemble ROM and SD payloads, create BT1 boot descriptors, and compare generated or read-back binary files.
2026-05-01 Clarify repository licensing
    Adds separate license coverage for software, hardware design material, and documentation/images.
2026-05-01 Fix demo assembly include paths
    Updates demo sources to include the generated ruledef from ASM/ruledef.asm.
2026-05-01 Add SPI, SD, and OLED assembly support
    Adds stable SPI/SD assembly routines, SD bootstrap sources, basic OLED driver files, timing helpers, and the OLED 5x7 text generator.
2026-05-01 Move demo programs under ASM programs
    Moves early assembly demos out of the ASM root and updates their ruledef include paths.
2026-05-01 Update README for cleaned repo structure
    Documents the current ASM, generated, and tools layout after the repository cleanup.
2026-05-02 Update schematics and figures
    Updates schematic and figure assets for the ALU, control logic, OLED display, port selector, and SPI bus, and removes the obsolete ASM README.
2026-05-05 Update CustomASM rule generation
    Default ruledef generation now targets little-endian syntax for CustomASM v0.14.1 and newer. The generator keeps legacy/intermediate/current syntax modes, and the current mode now uses @be for big-endian address forms.
2026-05-05 Add Windows SD deployment support
    Add Windows raw SD-card write support through \\.\PhysicalDriveN, plus optional --windows-lock-volume support for SD-card volume locks. Linux deployment behavior remains unchanged. Update the deployment READMEs with Linux and Windows device detection and direct-write examples
2026-05-05 Add OLED monitor libraries
    Add the OLED text and monitor support files used by SD-loaded stage-2 programs. Added files provide reusable display and monitor routines for later OLED and PS/2 monitor work.
2026-05-07 Reorganize example programs
    Move ROM-loaded examples under loaded_from_ROM and add SD-loaded program examples, including the 32-bit prime showcase and OLED animation inputs. Rename the Arduino EEPROM programmer folder for clearer organization.
2026-05-07 Fix SD delta video player generation
    Use local delay routines in generated OLED video players and refresh the committed animation examples.
    [eyes.asm, rick_roll.asm, stick_fight.asm, stick_fight_bw.asm]
2026-05-07 Rename schematics and Arduino programmer folder
    Rename the schematics & figures and Arduino EEPROM directory to shell-friendly paths.
